xlx2730109-code/Microduck/01_mechanical/roller_skates_kissqy_20261107/README.md

# 01_mechanical/roller_skates_kissqy_20261107
目标：提供 kissqy 20261107 原版滑轮鞋文件与摆盘数量。

## 基准与结论

### A. 文件与数量

| 文件 | 数量 | 说明 |
|---|---:|---|
| 滑轮.stl | 4 | 作者要求 TPU |
| 滑轮支架左.stl | 1 | 硬质结构件；作者未指定统一材料 |
| 滑轮支架右.stl | 1 | 与左支架文件相同，左右各装一件 |
| 左脚.stl | 1 | 同版脚踝连接件，作为配套参考 |
| 右脚.stl | 1 | 同版脚踝连接件，作为配套参考 |
| source_layout.3mf | — | 原始整机摆盘，仅供核对，不整包上传打印 |
| manifest.json | — | 来源、数量依据及文件 SHA256 |

- **K1**：原始 3MF 含四个滑轮实例、两个支架实例。6个轮子包含备料，不能当成作者装机数量。
- **K2**：五个 STL 均可读取、网格封闭。文件直接复制，未改模型、单位及尺寸，复制前后哈希一致。
- **K3**：现有机械行者／fanhao v2.2 脚部与此支架的实际兼容尚未验证。左右脚作为同版连接件附带，不能据此断言现有脚必须更换。
- **K4**：作者要求滑轮使用 TPU。硬质件使用 ABS 属于我们的材料建议，不是作者要求。
- **K5**：来源：https://github.com/kissqy/Microduck-kissqy/tree/main/hardware/3d-print-frankenduck 。以下载的 20261107 原包为准，网页 FILES/SHA256SUMS 部分仍记录旧包。
- **K6**：用户已确认多打备料；本机拟下单数量、截图实际材料与成交状态统一在 [BOM 补打计划](../../00_notes/01_BOM表.md#2026-11-10-补打与备料计划) 维护。上表为原版装机数量，不是本机备料总数；尚未确认打印付款或收货。

## 已完成

- [x] 2026-11-10 下载原包、读取摆盘、提取文件并检查 ZIP，见 K1、K2。
- [x] 2026-11-10 同步用户备料决定和 BOM 入口，见 K6；更新 ZIP 内同名说明，STL 保持不变。

## 待完成

- [ ] **T1** 核对现有脚部与滑轮支架的连接孔位；决定是否需要同版左右脚，见 K3。
- [ ] **T2** 按同版装配核对 623ZZ 轴承、轮轴和紧固件；实物装配与运转未验证。
