xlx2730109-code/Microduck/08_local_web/studio/README.md

# Microduck Studio

装在鸭子上的网页中控。电脑或手机浏览器打开 `http://<鸭子 IP>:8000/` 就能看鸭子现在的状态、一键卸力，也能站立/走路、配对蓝牙手柄（走官方 `robotctl pad pair`）、标定舵机、校准 IMU 方向、把这两样和方向一次写进主程序，按「上手清单」做装机检查。鸭子开热点等配网时，还能用手机选家里的 WiFi、填密码。

## 它做什么、不做什么

- 平时跟鸭子主程序 robotd 说话（`/run/robotd.sock`，接口 v40）；舵机页要直接调舵机，先让 robotd 交出总线，用完再交还。
- 页面上的一切状态都来自 robotd 的回读：比如「已卸力 ✓」要等 busStatus 里扭矩确认关了才显示，不是「按过了」就算。
- 停掉 Studio 不影响鸭子；停掉 robotd **不会**让舵机卸力（舵机保持最后的指令），页面会提示。
- **Studio 退出不卸力**：舵机页的总线会话开着时 Studio 退出（重启、升级），只关串口，保持着的舵机照样保持。
  开总线时在 state 目录写 `servo-session.json`（串口、开始时间、谁开的），点「交还主程序」成功才删；Studio 起来时见到它、
  robotd 又不在，就自动重新接管总线（只读打开，不改扭矩），每一页顶上的提示条照旧；接管不上，提示条写
  「上次退出时可能还有舵机保持着，去舵机页接管后才能卸力」，顶上的卸力按钮带你去舵机页。robotd 在：它起来时已经全部松开，删掉标记。
- 舵机会话期间每 5 秒看一眼 robotd 的 socket：被手动起来了（它会把舵机全部松开、跟 Studio 抢串口）就记错误、Studio 关总线（不写舵机），
  提示条变红。要回主程序，点「交还主程序」，别手动 `systemctl start robotd`。

## 目录

```
run.py              启动入口（python3 -I run.py …）：把 deps/ 放进搜索路径再进 studio
run_tests.py        跑全部测试
studio/
  log.py            日志：分类、分级、毫秒时间、去重、脱敏、按天滚动；命令记「发出 → 回执 · 耗时」
  auth.py           管理员密码（scrypt）、登录会话、失败退避、Host/Origin 校验
  rpc.py            robotd/configd 的 JSON-RPC 连接（一条连接一次一个请求）
  robotd.py         连接：轮询 / 实时状态流 / 命令 / configd 各一条常驻；卸力每次新开一条（robotd 重启后不会撞上死连接）
  estop.py          卸力状态机：ready → pending → confirmed / unavailable；只认「卸力回执之后才发出的」回读
  state.py          把原始数据汇总成推给页面的状态（姿势、电量、舵机、IMU、手柄、待办、配网）
  models.py         模型库、默认恢复、实际切换回读、手柄改键
  model_package.py  模型部署包解析与 robotd 无硬件预检
  sensors.py        摄像头来源配置与 ToF 按需快照（独立于运动控制）
  net.py            配网：读 netcheck 的 net.json、configd 的 net.status / scan / connect / forget、开关热点
  app.py            网页服务：静态文件、登录、日志、诊断包、WebSocket
web/                页面（Preact + htm，three.js 画 3D 鸭子；全部本地文件，不走 CDN；wifi.js 是连 WiFi 卡片和设置；
                    probe.svg 是连 WiFi 以后找鸭子新地址用的小图）
deps/               钉死版本的 Python 依赖（starlette、uvicorn 等，见 deps/VERSIONS.txt）
dev/
  record_robotd.py  在鸭子上只读录一份 robotd 的真实回包（给假 robotd 和测试用）
  fake_robotd.py    假 robotd + 假 configd：回放录的数据，电脑上不接鸭子也能跑
tests/              单元测试 + 真机录的数据 fixtures/now-20261018.jsonl
```

## 在电脑上跑（不接鸭子）

需要 Python 3.13（跟板子一样；Windows 上是 `py -3.13`）。

```bash
py -3.13 -I dev/fake_robotd.py --fixture tests/fixtures/now-20261018.jsonl \
    --net-mode hotspot --net-state-file ./state-dev/net.json   # 假 robotd + 假热点配网，听 17001/17002
py -3.13 -I run.py --listen 127.0.0.1:18080 --robotd tcp:127.0.0.1:17001 --configd tcp:127.0.0.1:17002 \
    --net-state ./state-dev/net.json --dev-autologin --state-dir ./state-dev --log-dir ./logs-dev
```

浏览器开 `http://127.0.0.1:18080/`。`--dev-autologin` 只认本机请求、只能配 `127.0.0.1`，方便截图测试；鸭子上不要用。
假 robotd 可以用 `--mode commissioning|motion` 选主程序模式（出厂场景是 `--mode commissioning --calib factory`），用 `--posture limp|policy|commissioning|starting` 换姿势；`--net-mode hotspot|wifi|none` 写一份假 net.json。
标定模式照 fork 的真实行为：起来后先回启动报告（`phase=configuring_bus`），第一次读成功才回实时快照；`--commissioning-stuck-status` 模拟旧 fork（启动报告永远不清，Studio 一直看到「启动中」）。
不给 `--net-state` 时读 `/run/microduck/net.json`；文件不在（电脑上、老镜像）就不显示 WiFi。不给 `--duck-label` 时，界面用主机名（鸭子上是 `duck-xxxx`）。

Windows 的 Python 没有 Unix socket，所以地址写成 `tcp:主机:端口`；鸭子上是 `unix:/run/robotd.sock`（默认）。

## 摄像头和 ToF

左侧「手柄」之后是「摄像头」「ToF」两个独立页面，手机底栏也有入口。

总览／手柄页的状态栏依次显示电池、舵机、IMU、摄像头、ToF、手柄、主板。摄像头仅通过本机 mediad socket 的只读 `hello` 判断“服务在线”，不把配置文件或测试画面当作真实摄像头已连接；点开页面才能查看实际视频。ToF 根据新帧显示在线，fake/sim 明确标为模拟数据。状态栏每10秒检查一次，切页或后台取消，过期状态清空；检查不会请求视频帧、建立 WebRTC 或启动系统服务。

当前镜像尚无“开机自动识别摄像头／ToF 硬件，再按检测结果启停服务”的统一策略。firstboot 的自动识别针对 IMU；镜像默认 `media.source="test"` 避免缺摄像头反复崩溃，但媒体服务仍可能运行。网页未连接可能是网络或服务问题，不能直接据此认定没装硬件并关闭服务。

- **摄像头**：接现有 mediad 的局域网 WebRTC 视频（默认信令端口 8443），可以开始、停止和重新连接。页面等实际画面开始更新才显示播放；切走或进入后台会释放连接。只读取视频及画面元数据，不打开电脑/手机摄像头，不发送运动指令。画面按运行端报告的安装角度显示。
- **来源标记**：镜像的 `[media] source="test"` 表示测试图案，能播放也不能代表真实摄像头接好了。配置为 camera 时也只显示「配置：摄像头」，配置文件不能证明当前运行状态；视频服务标为模拟设备时另行注明。当前版本会忽略旧的 `media.camera` 开关，Studio 不据此猜测真实来源。
- **ToF**：通过 `/run/tofd/tof.sock` 的 `tof.stream` 获取 8×8 距离分区，显示有效格数、最近/最远有效毫米值及逐格原始状态。5/9 且距离为正才计入统计；无目标（255）和测量失败分别显示。服务未连接、未接传感器、等待首帧、格式错误和过期数据均有独立说明。fake/sim 数据会标注「模拟数据」。
- 传感器读取独立于 robotd 的运动连接，只在相关页面可见时进行；没有自动避障、导航或后台录像功能，不更改系统服务和配置。

高级安装可通过 `--tof unix:/run/tofd/tof.sock`、`--camera-socket unix:/run/mediad/media.sock` 和 `--camera-signaling-port 8443` 指定本机服务；`--tof none` 或 `--camera-socket none` 明确关闭对应的只读探测。开发测试可将 socket 指向受控的 `tcp:127.0.0.1:端口`。网页不接受任意 socket 或视频服务器地址。摄像头信令使用打开 Studio 的主机名，远程仅转发 8000 端口的 SSH 隧道不会自动转发视频链路。

本地 `tests/test_sensors_e2e.py` 使用明确标记的假 ToF 和浏览器 RTC 测试实现，验证真实网页播放、导航、错误及资源释放；这些软件测试不代替摄像头、编码器和 ToF 硬件验收。

## 台架模式：主控没烧，用飞特调试板在电脑上调舵机

把飞特调试板（或 USB 转 TTL）插到电脑上，接好舵机和电源，然后：

```bash
py -3.13 -I run.py --bench
```

它不连主程序，自动打开浏览器进「舵机」页；在页头的「串口」下拉里选 COM 口，点「连接」就能调（跟 servo-web 一样）。
没接硬件想先看看：串口选「演示（没接舵机）」，Studio 在软件里假装有 15 颗舵机。

## 装到鸭子上

1. 拷贝：把 `software/studio` 整个目录拷到鸭子的 `/home/radxa/studio-dev`（`scp -r`、U 盘解压包都行）。
2. 自检：在鸭子上运行 `python3 -I run.py --selfcheck`（只读：打印版本，对 robotd / configd / padd 各问一次）。
3. 装 root 小助手：`cd deploy && sudo sh install.sh radxa`。0.7.1 的小助手负责舵机总线交接、手柄配对、热点开关、`calib-read` / `calib-commit`（把标定写进主程序、切运动模式）、`ssh-status` / `ssh-password`（「更多」页的 SSH 开关），以及 `imu-recalibrate`（重新校验已保存的 IMU 安装方向）；关热点前会写 `/run/microduck/studio-connecting.json`，让 netcheck 在连接期间别插手。从舵机页交还时，标定模式的实时快照也算主程序起来了（0.5.1 只认运动模式的 `control`，标定模式下每次都等满 30 秒判「起不来」）。步骤、卸载和上机核对见 `deploy/INSTALL.md`。
4. 开机服务：照 `deploy/microduck-studio.service` 文件头的命令装：

   ```bash
   sudo install -m 644 microduck-studio.service /etc/systemd/system/ && sudo systemctl daemon-reload && sudo systemctl enable --now microduck-studio
   ```

   撤：

   ```bash
   sudo systemctl disable --now microduck-studio && sudo rm /etc/systemd/system/microduck-studio.service && sudo systemctl daemon-reload
   ```

5. 打开 `http://<鸭子 IP>:8000/`，按页面上的「上手清单」走。

手柄配对的主路是 root 小助手调官方 `/usr/local/bin/robotctl pad pair --json`：`/var/lib/robot/weird-ble` 板上它会先停 `btd`、给蓝牙适配器断电再开，配完把 `btd` 起回来。没装或旧版小助手时退回 configd → bluetoothctl；这块板这样可能配不上，向导会提示重装小助手，或者在鸭子上运行 `sudo robotctl pad pair`。

出厂镜像让 robotd 跑标定模式：`/etc/systemd/system/robotd.service.d/zzzz-zz-microduck-commissioning.conf` 里 `ExecStart` 带 `--commissioning`。这样 `calibration-status` 和 `busStatus.last_sample` 马上能读，IMU 页粗校、舵机页中位都能做。上手清单第 3 步写成功后，小助手删掉这个文件、`daemon-reload`、重启 robotd，主程序回到运动模式。`systemctl show robotd -p ExecStart` 里有 `--commissioning`、但那个文件不在时，小助手拒绝自动切（`foreign_commissioning`），去日志页导出诊断包。

IMU 页的「IMU 安装方向」始终保留入口：已经保存并验证过的安装四元数，也能点「重新标定方向」。先扶住鸭子并卸力，二次确认后，运动模式通过新版 root 小助手暂时回到标定模式；已经在标定模式的直接重新采集。沿用原来的静止 3 秒、整个躯干前倾 15–30° 采 3 秒、计算方向和主程序验证。**点击「交给主程序验证」前，先把实物回正并停住**，再按提示前倾。小助手的重标定恢复会话保持卸力；出厂标定模式也支持下述站姿采数，站着精校流程不变。

总线 ID 200 的 IMU 由主程序启动时自动识别，支持 FT6、IMU-to-DXL（Feetech）；SFLP 124/12（Dynamixel 2.0）。标定、运动模式的 IMU 页都显示实际协议和板卡。板卡名称表示识别到的寄存器布局，不证明厂商。需要手动指定时改主程序配置 `bus.imu_protocol = "auto" / "feetech" / "dxl2"`，网页没有运行中切换协议的按钮。I²C 的 BNO085、LSM6DSV16X 流程不变。

总线安装方向的 `imu_bus_protocol` 由主程序验证成功后写入；旧标定没有这个字段时只兼容 Feetech。检测到的协议不匹配时，页面提示重新标定，跳过第 2 步也不能把旧方向当成已验证。主程序通过运动模式的失能状态保留重做入口。第 3 步与小助手 0.7.1 保留并读回该字段；重做完成可采用新绑定，取消恢复原文件。协议、板卡布局或原始身份字节改变，会作废当前采集、在途计算和旧的站姿校准结果。DXL2 板卡不提供采样序号、状态位、传感器读数年龄；主程序使用主机接收新鲜度和原始字节冻结检查，页面不填造这些诊断值。

出厂标定模式做第一次安装方向标定，也可以先手动点「站姿使能」：等 HOME 保持站稳（误差 ≤5°），双手扶住整个躯干采静止和前倾，再回正交给主程序验证。允许已卸力或明确站稳两种状态；起身中、扭矩未知、运动中及卸力待确认仍拒绝。通过小助手从运动模式进入的重标定恢复会话仍要求全程卸力，避免恢复模式时重启主程序影响站姿。采数不会自动上力或发起运动。

重标定会话保留原始标定和启动配置，刷新网页或重启 Studio 后可继续，也可「取消并恢复原参数」。验证通过后逐项读回当前芯片和新方向，只恢复原来的运动许可及运行模式，舵机零位（包括非 2048 的零位）、方向、限位、其他 IMU 和未知配置均保留；恢复成功仍保持卸力。失败会保留恢复入口，不会把未读回的方向报成完成。此流程需要同时更新 Studio、root 小助手和 sudoers；不会调用上手清单第 3 步来重写舵机标定。

**标定模式的状态要新版 fork**：fork robotd 一起来先写一份启动报告（`{"mode":"commissioning","phase":"configuring_bus",...}`），`robot.busStatus` 只要它的 phase 还是启动阶段就一直回它；第一次读成功以后才回标定模式的实时快照（phase 是 `ready` / `moving` / `read_error` / `stop_unconfirmed` / `power_pending`，带 `last_sample`）。旧版 fork 的标定模式从来不清启动报告，Studio 会永远看到「启动中」、拿不到 `last_sample`（10-20 真机验收就是这样）；fork 已经改成第一次读成功以后清掉，用 20261020 之后的镜像（或重装那份 robotd）。Studio 这边：实时快照的这几个 phase 都算「主程序起来了」（`read_error` 是起来了、只是读舵机出错，照原样写主程序的原话）；连续报启动阶段超过 30 秒（从这次连上算），总览头图改成「主程序一直报『启动中』」、给「去日志页」，顶栏、待办、上手清单头上也不再说「通常 10 秒」。

电池用台架电源供电时，在「设置 → 电池」里把型号选成「台架电源」：只显示电压，不算电量、也不报电量。
Studio 默认没有密码，同一网络里谁都能打开。在「更多 → 登录密码」里可以直接设置；设过以后要先登录才能改，也可以清掉。命令行 `python3 -I run.py set-password` 仍然可用，但要用 radxa 用户运行，别加 `sudo`（root 写的密码文件 Studio 读不了）。

## 上手清单：去做、已完成、跳过

每一行任何时候都有三个按钮（用户 10-20：「可能有人之前做过重新走一遍」「允许人家直接跳过」）：

- **去做**：去那一步的页面；测出了问题的行写「重新做」。
- **已完成**：我以前做过（比如二号鸭零位早用 Studio 的舵机页校过），这一行 ✓、写「你标了已完成（时间）」。以前的「已经校过，核对一下」就是它。
- **跳过**：先不做，这一行 ↷。

标过的行给「重新做」和「取消」（跳过的是「取消跳过」）。标记绑这一步的指纹（舵机零位、IMU 方向、标定、手柄……），指纹变了就不算、回到「该做」；标的时候读不到指纹，等读到了再绑上。
以前锁着的情况——主程序说没做完、读不到（?）、测出了问题、测急停、调舵机时——现在都能点，但「已完成」「跳过」要点两次，第二下按钮上写后果（「确定跳过？主程序说标定没做完：跳过了鸭子也站不起来」这种），后端没收到确认也拒。
第 1 步标了已完成或跳过，第 3 步「写进主程序」的准备情况里「舵机零位」算满足（15 颗按 2048 写零位，零位要是用 Studio 的舵机页校过的才对）。
第 2 步标了已完成或跳过、主程序里正在用的那颗 IMU 方向没确认、IMU 页也没站着校过（没有 `imu-pending.json`）时，第 3 步**按默认装法写这颗 IMU 并标成已确认**（10-21 真机验收：全点跳过以后 fork 要 IMU 方向已确认才肯进运动模式，鸭子一直停在标定模式）：

- 总线小板（`bus`）：文件里现有的 `imu_mount_quat`（出厂就是官方装法 `[0.7071067811865476, 0, 0.7071067811865476, 0]`）；
- BNO085（`bno08x`）：`[0.5, 0.5, 0.5, 0.5]`，fork `duck-control/src/trunk_imu.rs` 的 `BNO08X_DEFAULT_MOUNT`；
- LSM6DSV16X（`lsm6dsv16x`）：`[0.7071067811865476, 0, 0.7071067811865476, 0]`，复刻推荐装法（模块 x 朝下、z 朝前，二号鸭 10-17 实测）。fork 自己给的默认是单位四元数（「小板没有公认的朝上方向」），不用它。

准备情况里写「你标了第 2 步已完成：IMU 按默认装法写（芯片：哪种装法）。装得不一样的，站起来会往一边倒——写完以后在 IMU 页站着校一次，再写一次主程序」；点「写进主程序」的第二下写「确定？IMU 按默认装法写」。IMU 页站着校过（有 `imu-pending.json`）就照旧用它，主程序里方向已确认就照旧用主程序的；IMU 页记下的是另一颗芯片的、或者主程序还没报用的是哪颗，不猜，照旧挡住。小助手 `calib-commit` 照旧只收 `imu: {source, quat}`。这样**跳过第 1、2 步 → 第 3 步写进主程序 → 运动模式**一路能通。

## 打开 Studio 的地址怎么选

开着 Clash 系统代理的 Windows 电脑打不开 `duck-xxxx.local`（走了代理，502）；不带点的 `duck-xxxx` 能开（Windows 用 LLMNR 问到鸭子，代理按 `<local>` 绕过）。所以页面上按设备写：

- Windows 电脑：`http://duck-xxxx:8000/`（开着代理也能打开）；
- 苹果手机、Mac：`http://duck-xxxx.local:8000/`；
- 安卓手机，或者都打不开：去路由器的设备列表找 `duck-xxxx`，用它的 IP；
- 电脑开着 Clash 的 TUN 模式还打不开：在 Clash 里把局域网（192.168.0.0/16）设成直连。

「更多」页有一块「这只鸭子的地址」，列出现在能用的 IP（configd `net.status` 的 `ip4`，热点模式是 10.42.0.1）、`duck-xxxx`、`duck-xxxx.local`，每个能复制；总览顶栏鼠标停在鸭子名字上也看得到 IP。连 WiFi 的列表里滤掉了鸭子自己的热点（按 net.json 的 `hotspot_ssid`；没有就滤「`Microduck-` 开头、已保存」的）。

**连 WiFi 以后自动跳到鸭子的新地址**（10-21 用户：「连 WiFi 弄了三下」）：点了连接，页面记下要找的 `http://duck-xxxx:8000/` 和 `http://duck-xxxx.local:8000/`（主机名来自 net.json，端口跟 `--listen` 一致）。
页面跟鸭子的连接断了（WebSocket 断了，或者 5 秒没收到消息）以后，卡片换成「鸭子正在连『家里 WiFi』……请把这台设备连回『家里 WiFi』（电脑插着网线的不用管），找到鸭子会自动打开」，列出这两个地址（能点）和「找不到时：去路由器设备列表找 duck-xxxx 的 IP」。
每 2 秒用 `new Image()` 加载 `<地址>probe.svg?t=<时间>`（`web/probe.svg`，跟别的静态文件一样不用登录、不缓存；跨域加载图片不要 CORS），哪个先加载成功就跳过去；一次探测最多等 6 秒，没回话之前不重复探同一个地址。
最多找 3 分钟，找不到就换回原来那段按设备打开的说明。页面重新连上原来的地址（热点回来了，说明没连上）时停止探测，照旧显示失败原因。

## 镜像里 vs 手动装

「连 WiFi」卡片依赖复刻镜像里的几样东西，不是 Studio 自己带的：

- netcheck 写的配网状态 `/run/microduck/net.json`；
- NetworkManager 里的 `Microduck-Hotspot` 热点配置；
- configd 以 `--allow-user btd,radxa` 运行，Studio 才有权限调 `net.scan` / `net.connect` / `net.forget`；
- mDNS 配置，手机才能用 `duck-xxxx.local` 找到鸭子。

按 `deploy/INSTALL.md` 手动装 Studio 和 root 小助手、但没有复刻镜像 overlay 的鸭子，没有这几样，页面就不显示「连 WiFi」卡片；总览、手柄、舵机、IMU、日志这些照常使用。

## 页面和 Studio 之间的约定（WebSocket `/ws`）

握手时检查 Host 和 Origin，不对就拒绝握手（浏览器只看到 1006，日志里写原因）；没登录的先接受再用 4401 关掉，页面看到 4401 就跳登录页。

| 方向 | 消息 | 说明 |
|---|---|---|
| Studio → 页面 | `{"t":"hello","version","duck"}` | 连上先发一次 |
| | `{"t":"state", …}` | 页面可见时 10 Hz；字段见 `studio/state.py` 的 `summarize` |
| | `{"t":"hb"}` | 页面在后台时 1 Hz（这时不订阅 robotd 的实时状态，省 CPU） |
| | `{"t":"log","entry":{…}}` | 新日志 |
| | `{"t":"result","id","ok","reason","data"}` | 命令回执；扫 WiFi 的网络列表等数据放在 `data` |
| | `{"t":"pad", …}` | 手柄快照：手柄那一块在屏幕上时 10 Hz，不在 1 Hz（总览的手柄格要用）；长列表没变时带 `lists_same`、不带列表 |
| 页面 → Studio | `{"t":"hb","seq","visible","route","pad_visible"}` | 每秒一次；进出手柄区那一刻马上再发一次。`pad_visible` = 手柄那一块在屏幕上（#/pad 只是总览上的锚点） |
| | `{"t":"cmd","id","name","args"}` | relax、servo.*、imu.op、calib.op（`preview` / `commit`：上手清单第 3 步）、pad.op、onboard.op（上手清单的 `done` 已完成、`skip` 跳过、`undone` / `unskip` 取消，`{step, confirmed}`：要点两次的第二下才带 `confirmed: true`；老的 `confirm_servo` 还认）、net.op（`scan` / `connect` / `forget`） |

舵机会话在 `state` 里的几个字段（每一页顶上的提示条用）：`servo_session`（开着才有：`holding` 几颗保持着、`unknown` 几颗读不到扭矩、
`restored` 是不是 Studio 重启后接着管的）、`servo_handback_s`（交还以后、主程序连上以前一直有）、`servo_orphan`（上次退出时开着、这次没接管上）、
`servo_conflict_s`（会话期间 robotd 被手动起来了，10 分钟内）。`servo.close {if_idle:true}`（离开舵机页）只在 15 颗扭矩当场读到都是 0、
没有别的页面在舵机页、没在校准 / 运动时才交还；`servo.close {}`（点「交还主程序」）先等在路上的舵机操作做完再卸力交还。

`state.starting_s` / `state.starting_long`：主程序从这次连上起连续报启动阶段多少秒、超没超过 30 秒（总览头图、顶栏、待办改口「一直报启动中」用）。

`state.net` 是配网状态：`known=false` 表示没有 net.json（整块 WiFi 隐藏）；否则有 `mode`（wifi / hotspot / none）、当前 `ssid` / `signal` / `ip4`、`hostname`、
`url_local`（`duck-xxxx.local`，端口跟 `--listen` 一致）、`url_host`（不带点的 `duck-xxxx`）、`ip_now`（现在能用的 IP：热点模式是热点地址）、
`urls`（「这只鸭子的地址」那几行：`{kind: ip / host / local, url, note}`）、鸭子热点 `hotspot {ssid, ip, psk}`、上次结果 `last_try`、`busy`。`net.op scan` 滤掉鸭子自己的热点。`net.op connect` 先回「开始切换」（页面拿 `url_host` / `url_local` 当以后要找的地址），真正关热点、调 configd 在后台做；
结果写到 state 目录的 `net-last-try.json`（不含密码）。家里的 WiFi 密码只从页面传到 configd 一次，不进日志、state 或诊断包。

已保存的加密网络也要每次填密码：官方 configd 遇到加密网络、没给密码就回 `unsupported`。密码错了会先 `net.forget` 掉这次写坏的配置，再马上开回热点；
`timeout`、`other`、Studio 自己等 configd 超时，也会马上开回热点。Studio 等 60 秒没回话单独记「鸭子的配网程序 60 秒没回话」，不跟 configd 的 `timeout` 混在一起。
小助手关热点前写 `/run/microduck/studio-connecting.json`（90 秒内 netcheck 不插手），开热点成功后删掉。

页面判断「连不上」只看收到消息的间隔（1 秒变灰、3 秒报警），不看两边的钟（鸭子的钟可能是 1970 年）。

## 日志

`logs/studio-YYYY-MM-DD.log`，留 14 天、总共不超过 50 MB。一行一件事：

```
2026-10-18T00:41:56.194+09:00 [命令] → 卸力（电脑 127.0.0.1） · 步骤：robot.relax
2026-10-18T00:41:56.197+09:00 [命令] ← 卸力 成功 · 3 ms · 已发出，等回读确认 · 步骤：robot.relax · 原文：{"accepted": true}
```

出错时写明「卡在：哪一步 · 原文：… · 建议：… · 现场：{…}」。密码、令牌自动打码。同一句话 1 分钟内重复只记一次，并注明合并了几次。
页面「日志」页能看最近 500 条，也能导出诊断包（日志 + 当时的状态 + robotd 原始回包 + 版本 + robotd 的系统日志），发群里求助用。

日志里每条命令都记发出和回执、带耗时和现场，代码是我们自己写的。

## 测试

```bash
py -3.13 -I run_tests.py               # 电脑
python3 -I run_tests.py                # 鸭子
```

总线 IMU 集成的定向回归（含无头 Edge 页面；无 Edge / Node >=22 时浏览器项跳过）：

```bash
py -3.13 -I -c "import sys;sys.path[:0]=['deps','.','dev'];import unittest;unittest.main(module=None,argv=['x','tests.test_imu_backend','tests.test_commit','tests.test_helper_calib','tests.test_helper_imu_redo','tests.test_imu_bus_ui','tests.test_imu_wizard_e2e'])"
```

覆盖：
- 登录：会话、密码错 5 次退避、退出要 CSRF；Host 421、Origin 矩阵；没登录的 WebSocket 收到 4401；
- 日志：格式、脱敏、去重、按天清理（钟停在 1970 也能清）；
- JSON-RPC：半行、超长行、乱码和非对象 JSON、超时重连；
- 卸力：不被慢查询挡住、回读确认、hd1910 标志没清不算确认、标定模式、robotd 重启后第一次就成功、确认后别人再上力不会自动补发；
- 轮询：一项出错不挡别的项；只在有人看时订阅，没心跳当没人看；robotd 掉线又回来；
- 姿势判定（用真机录的数据）；通过 WebSocket 发卸力的完整来回；
- 手柄配对：小助手 `pad-pair` / `pad-forget` 的参数校验、robotctl 成功 / 失败 / 超时解析；向导的主路、旧小助手回退、bluetoothctl 代理注册失败重试、padd 30 秒等待。
- 配网：小助手热点动词、连接窗口文件；net.json 缺失 / 损坏 / 各模式；扫描缓存；连接顺序、失败原因（bad_key 先 forget 再开热点）、热点恢复、同时只连一个；密码不进日志 / state / last-try / 诊断包。
- 登录密码：网页首次设置、登录后才改、清掉；改密码保留当前浏览器会话；root 运行 `set-password` 被拒；热点模式且没密码时的卡片提示。
- 标定模式的状态：假 robotd 先回启动报告（四个键）、读成功后回 fork 字段的实时快照、`--commissioning-stuck-status` 永远回启动报告；实时快照算主程序起来了（总览、准备情况、小助手交还都是），旧 fork 一直 `configuring_bus` 时交还照旧判没起来、话照实说；连续 30 秒报启动阶段改口「一直报启动中」。
- 上手清单的三个按钮：每种原来锁着的情况都能「已完成」/「跳过」（两步确认、第二下的话对、后端没确认也拒）、「已完成」的记录和作废、指纹读不到先记再绑、第 1 步标了 → 第 3 步舵机零位满足、第 2 步标了但方向没确认 → 按默认装法写 IMU（总线小板 / BNO085 / LSM6DSV16X 各一条：准备情况满足、交给小助手的四元数对、读回过得了运动模式校验）、有 `imu-pending.json` 用它、主程序已确认用主程序的、芯片对不上照旧挡住。
- IMU 页的「站姿使能 / 失能」：标定模式下点了弹确认、发 `imu.op hold`，主程序收到的是 15 个方向 + 3000 ms 的 `hold-home`，站住以后写「标定模式（站着）」，失能走 `relax` 回软着；运动模式下发的命令跟遥控卡「站起来」、顶上「卸力」一模一样（浏览器端到端）。
- 地址：热点 / WiFi 模式的地址列表、扫描结果滤掉鸭子自己的热点、切换提示里三种地址。
- 连 WiFi 以后找鸭子：`probe.svg` 不用登录、两种主机名都给、不缓存；探测逻辑（Node 跑 `web/wifi.js` 的真代码，假时钟）每 2 秒探两个地址、先通的就跳、3 分钟放弃、热点回来就停、挂着不回的不重复探；浏览器端到端看断线后的卡片、热点回来停下、探到了跳过去。
- 写进主程序：小助手 `calib-read` 只读 / 不拿锁、`calib-commit` 先拿锁再查旗、标定模式删 drop-in 后切运动模式、`mode=motion` + `phase=control` + `calibration-status` 逐项读回一致才算成功、`waiting_for_bus` 的标定错误 / 总线错误分开报、读回不一致 / `.saved.toml` 写失败 / 重启失败都回滚（文件和模式分开报，回滚后起不来如实写）、策略在跑拒绝、`ExecStart` 里有 `--commissioning` 但 drop-in 不在拒绝、备份按序号留 10 组；Studio 两种模式的准备情况、`calib-read` 兜底、超时读 `last-result.json`、pending / centered 变化让第 3 步变「该做」、撤销中位校准删记录；两份组 TOML 代码输出一致。

## 现状（第一版）

能用的：
- **总览**：实时状态、3D 鸭子、电池、主板温度、一键卸力（空格也行）。
- **舵机页**：扫描、单颗或全部中位校准（直接写进舵机）、方向、姿势、P/D/限力。
- **IMU 页**：出厂标定模式下粗校（托起摆正 + 往前低头，交给主程序 `verify-imu` 自己验），能站以后站着精校。
  「站着校准」上面有「站姿使能」和「失能（卸力）」（走顶上「卸力」同一条路：`relax`），旁边一行写现在站着 / 软着 / 正在站起来。
  运动模式下「站姿使能」走遥控卡「站起来」同一条路（`pad.op stand`，后端按姿势再判一遍）；
  **标定模式下也能站**（10-21 用户：「咱标定也能站姿不就好了吗？非要切到运动模式」）：发 `imu.op hold` → fork 标定模式的 `hold-home`，
  15 颗从现在的位置一起 3 秒转到 HOME 锁住，IMU 照常读；方向跟第 3 步写进主程序的同一套，零位用主程序文件里的（出厂 2048）。
  标定模式下 Studio 每 0.1 秒读一次 `busStatus`，`last_sample.imu` 当实时读数：「现在」那块的倾角、站着校准都能用，方向没确认过也能站着校（算出整份新方向，第 3 步写进去）。
  站着的时候第 3 步挡住（「先点失能」），因为写进主程序要重启主程序，鸭子会直接塌。软着时开始站着校准，提示先点「站姿使能」。
- **SSH 远程登录**（「更多」页，10-21 用户：「出了问题他们 SSH 自己修，不用重新烧卡」）：镜像出厂只认钥匙、不带任何人的钥匙，也没有能远程登录的默认密码。用户先设网页登录密码（没设时后端拒绝：不然连上热点的人都能打开网页、顺手打开 SSH），再自己定一个 SSH 密码（8–64 位，不能是 microduck 这类大家都猜得到的），`POST /api/ssh {action: on}` → 小助手 `ssh-password`：`chpasswd` 从 stdin 设 radxa 的密码，写 `/etc/ssh/sshd_config.d/05-microduck-ssh-password.conf`（排在镜像的 `10-microduck.conf` 前面），`sshd -t`、`sshd -T` 读回密码登录真开了才 `reload`，哪一步不对就删掉文件退回去。关掉 = 删这个文件再 reload。**密码只走小助手的 stdin，不进命令行、日志、结果文件**（测试逐项核对）。卡片上给出 `ssh radxa@<现在这个地址>` 的登录命令。
  「办法二：登记钥匙」（`studio/sshkeys.py`）：Studio 本来就以 radxa 身份跑，`~/.ssh/authorized_keys` 是它自己的文件，不经过小助手。只收一整行公钥（ed25519 / rsa / ecdsa / sk-*），base64 里的类型要跟开头写的一致，前面不能带 `command=` 这类选项；贴私钥会被认出来拦下。同一把（按 SHA256 指纹，跟 `ssh-keygen -l` 一样）不重复写；删掉按指纹删。目录 700、文件 600，`~/.ssh` 或文件是软链接就拒绝。跟打开密码登录一样，要先设网页登录密码。
- **写进主程序**：上手清单第 3 步把舵机零位、方向、IMU 方向一次写进 robotd 的标定。出厂镜像是标定模式；写成功后小助手删掉 commissioning drop-in、重启主程序切运动模式。成功不只看重启：还要 `mode=motion`、`phase=control`，并且 `calibration-status` 读回逐项一致；不成就把文件和模式换回去。Studio 重启后会读 `last-result.json` 把上次结果放回第 3 步卡片。
- **手柄**：配对（走官方 `robotctl pad pair`）、网页手柄、测急停。
- **遥控**：站起来 / 开始走 / 坐下、技能、动作和组合动作。
- **调手感**：只看。**模型管理**：导入部署包、改名、选择模型、恢复内置、设置动作键和删除导入模型；具体格式见 [模型导入说明](MODEL_IMPORT.md)。
- **日志**：日志页和诊断包；手机底栏从「更多」也能进日志、导出诊断包。
- **连 WiFi**：鸭子开热点时用手机选家里的 WiFi、填密码；切过去以后页面自己找鸭子的新地址、找到就跳过去；设置里能看当前网络、换网、忘掉已保存的网络。
- **登录密码**：在「更多 → 登录密码」设置、修改或清掉；热点模式又没密码时，总览的连 WiFi 卡片会提示先设密码。

还不能的（下一版）：
- 在网页上**改**调手感参数（走路幅度、平滑、P/D/限力）。

## 参考

本项目基于官方开源的 Microduck，开发中参考了社区多个开源项目的思路；代码由我们自己编写，开发中使用了 AI 辅助编程。

## 许可

Apache-2.0（跟仓库一致）。`web/vendor/` 下的 Preact、htm、three.js 都是 MIT，许可证在 `web/vendor/licenses/`；3D 模型的来源见 `web/model/NOTICE.md`；`deps/` 下各包的许可证在各自的 dist-info 里。
