xlx2730109-code/Microduck/00_notes/00_复刻总路线.md

# 复刻总路线

目标：给第一次做的人看的全局地图，从零件到小鸭会走，再到自己训练、复现。每一步只写做什么、怎样算完成、去哪看，细节在对应文档里。

原则：**真机首走优先用现成资源。** 阶段一使用作者镜像、成品模型和网页工具；主控在途期间已并行开展仿真训练。训练进展不替代实物标定、系统辨识、迁移和首走验收。

## 现在在哪

| 项目 | 状态 |
|---|---|
| 资料 | 作者主仓、镜像、10 个成品模型、CAD、装配 PDF、官方源码都在本地，有版本锁和校验 |
| 硬件 | 机械主体已装起；ZERO 3W 1GB 已启动；用户已接回 fanhao HAT，针序和舵机供电待实测；IMU 待读回 |
| 软件 | 64GB 系统卡已写入 `20261027`；已通过 `xlx` 配网，Studio 跨网可达性有波动，见[实机联调](../README.md#2026-11-14-实机联调) |
| 电脑工具 | 微雪 Adapter A 台架曾读到 15/15；当前 Windows 未枚举 COM10。模拟演示与实机入口见根 README |
| 摄像头机械适配 | 灰色面板与黄色眼圈的 SW 已定位；眼圈分面已核实，用户自行修改，尚无改件或打印验收。统一见[根 README 当前工作](../README.md#摄像头面板与眼圈修改2026-11-10) |
| 仿真训练 | Jetson 正在训练 HD1910 平地行走，已产生中途检查点；原生 Windows 短测通过，命令、曲线和预览见 [08 指南](08_训练导出与迁移指南.md) |
| 标定工具 | Windows 舵机调试台用于微雪台架；ZERO Studio 用于装机后的总线、IMU 和标定验收 |
| 真机验收 | 15 个唯一 ID 和舵机保护已通过台架断电复核；已单测右踝。整机 HAT 识别、机械零位、IMU、架空和首走待验 |

## 阶段一：整机复刻（进行中，不需要训练）

拿到零件后的顺序是：**给舵机编号 → 装机械 → 装电控 → 写镜像 → 网页上标定 → 手柄让它走**。

| 步骤 | 做什么 | 怎样算完成 | 去哪看 |
|---|---|---|---|
| 0 备料 | 核对已到货的主控、HAT、IMU、HUB 和线束版本 | 实物、接口和固件有记录 | [BOM 表](01_BOM表.md) |
| 1 清点 | 到货逐件核对，拍照，记板号和线数量 | 缺件与错件有清单 | [02 指南 C3](02_分阶段复现指南.md) |
| 2 舵机编号 | 首次接成整机总线/上电前，逐颗用 Adapter A 读回并设成 D1 目标 ID；仅卖家预编程且读回全数正确时跳过改写 | 15 颗 ID 唯一、匹配目标表且读回有记录 | 02 指南 D |
| 3 机械装配 | 小腿、大腿与髋、躯干、颈、头分组装；装前先让舵机归中 | 关节无卡滞，线不拉紧 | 02 指南 E，[视频入口](../90_archive/notes/04_视频与外部入口.md) |
| 4 电控装机 | 按实物核对针序，装主控、HAT、IMU，万用表查电压 | 主控 5 V 正常，无异常发热 | 02 指南 F、F1 |
| 5 写镜像与联网 | 已写卡并配置 `xlx`；核对同网和跨网访问 | 电脑能稳定打开 `:8000` 并收到实时状态 | 02 指南 G、H |
| 6 标定 | 网页向导：舵机零位、IMU 方向、站姿 | 本机标定保存并重启后仍有效 | 02 指南 I，[验收模板](03_标定与验收记录模板.md) |
| 7 架空与手柄 | 托住机身测保持、卸力；配对手柄，测急停 | 卸力和停止行为有记录 | 02 指南 J |
| 8 首次行走 | 平地低速前后、转向、停止，一次只改一个条件 | 有成功与失败记录 | 02 指南 K |
| 9 摄像头 | 接真实摄像头，Studio 视频页出画面 | 真实画面，不是测试图 | 02 指南 L |
| 10 备份基线 | 整卡存档，保存标定与配置，必要时做恢复卡 | 能从备份恢复到走通的状态 | [08 指南 G](08_训练导出与迁移指南.md) |

阶段一到第 10 步结束，就是“复刻完成”。

## 阶段二：复现学习（走起来之后，选做，可按兴趣取舍）

| 环节 | 目的 | 现有资料 | 缺口 |
|---|---|---|---|
| 1 读懂现成系统 | 理解镜像里运行端、模型和部署合同如何配合 | [06 完整性](06_复现完整性与动作清单.md)，作者仓库 | 无 |
| 2 建模 SW → MJCF / URDF / USD | 对照自己熟悉的流程 | SW 装配体与 STEP 在 `01_mechanical/cad_v2.2`；训练主线用作者的 MJCF，不需要转换；第三方有 URDF 与 Isaac Lab 仓库可对照 | 没有 HD-1910 版的 USD，自己转需另立项 |
| 3 质量与惯量实测 | 让仿真模型贴近本机 | 电子秤已买；训练前数据清单有原版数值 | 装好后称重，模型要按实测改 |
| 4 系统辨识 | 得到本机舵机参数 | 现用陆吾公开的 1910 参数，飞特官方另有一份 | 本机台架数据、拟合和验证都没有 |
| 5 训练环境 | 原生 Windows RTX 5080 与 Jetson 独立适配环境已短测通过，无需为此安装 WSL2 | [08 指南](08_训练导出与迁移指南.md) | 严格冻结、长期目录和环境重建仍待完成 |
| 6 训练与评估 | Jetson 正在训练 HD1910 平地行走，保留日志和中途 PT | 08 指南的当前实测与常用命令 | 尚未完成收敛、步态、续训与迁移验收；本机检查点不等于作者原始权重 |
| 7 导出与部署合同 | 把训练结果变成机器人能导入的包 | 08 指南 D | 训练台导出的包缺部署合同文件，要补 |
| 8 sim2sim | 在另一个仿真里对照同一策略 | 作者有回放脚本 | 脚本里还有原版舵机路径，要改 |
| 9 sim2real | 导入、分级验收、与基线对比、可回退 | 08 指南 E | 依赖阶段一的基线 |
| 10 其他动作 | 倒地恢复、坐站、捡物 | 10 个成品模型在本地，行走权重已含倒地恢复 | 本机恢复范围需分别验收；重训这些动作需额外移植 |

## 扩展（不挡阶段一）

云端自然对话、ToF 测距、轮滑、翻滚与踢球。上游没有云端对话，列在这里单独做。

## 现在卡在哪

1. 先比较 `xlx` 同网与 Tailscale 的 Studio 首页及实时状态，定位超时。PCB/Wi-Fi 批次及扩容待记录，`20261023c` 保留为回退版本。
2. 台架已完成 15 颗舵机编号；转接 HAT 前核对三芯线针序与供电，使用 ZERO Studio 验收整机 15/15。逐关节核对方向、行程和走线后再校零。
3. 核对 IMU 板型并读回实时数据，再确认安装方向。HUB 和实际供电端子仍待记录。
4. 补打件含备料的数量、截图材料、文件和未成交状态统一见 BOM；滑轮鞋不阻断普通脚底首走。
5. 摄像头镜头无法穿过现有眼圈孔，待用户按实测尺寸修改后检查并少量打印验配；照片不能作为扩孔尺寸依据。

更详细的评估、缺件核对与差异分析见 [15 方案评估与核对记录](../90_archive/notes/15_方案评估与核对记录.md)。
