xlx2730109-code/Microduck/00_notes/03_标定与验收记录模板.md

# 标定与验收记录模板

目标：保留本机配置、原始寄存器、关节映射和验收结果，避免后续依靠聊天记忆恢复。

2026-11-13 已完成电脑台架的 15 颗 ID 和保护断电复核。实物关节映射、方向、机械零位及整机运动仍待验收，空白不代表 0。

| 台架项目 | 实测结果 |
|---|---|
| 调试入口 | Windows 本地舵机调试台 `http://127.0.0.1:8080/`，Adapter A V3.1，COM10，1 Mbps |
| 断电重上电后 ID | 10–14、20–24、30–34 全部应答，逐颗读取的 ID 与寻址一致 |
| 断电重上电后 EEPROM | 15 颗的寄存器 19 均为 13，启用过热、过流、过压保护。寄存器 40 均为 0，55 均为 1 |
| 单颗运动 | 14 号单颗低速试动回读 190 → 209 → 191，随后扭矩回读为 0 |
| 下一步 | 在承托、关扭矩状态下手摆逐关节，核对 ID、方向和线束余量，随后按实物基准校零 |

## 本机版本

| 项目 | 实际值 | 证据/备份位置 |
|---|---|---|
| 舵机完整型号与固件 | 已购 HD-1910-C001；逐颗固件未读回 | BOM 第1项 |
| 机械版本/打印来源 | 机械行者／fanhao 飞特 v2.2；主体已装起，新增补打件尚未确认交付 | [装配照片](evidence/20261110/assembly_progress.jpg)、BOM 补打计划 |
| 主控及 PCB 修订/RAM/eMMC | 订单为 ZERO 3W，1GB RAM、无 eMMC、带排针；已发货；PCB 修订未知 | [主控订单](evidence/20261110/zero3w_shipped.png) |
| 调试板与接口版本 | 微雪 Bus Servo Adapter (A) V3.1，COM10 | 2026-11-13 台架实测 |
| HAT 版本 | 待填 | |
| IMU 芯片/MCU/PCB/协议 | 实物照片为方形四安装孔、丝印 V1.0A；芯片/MCU/协议/固件待核 | 本会话 IMU 到手照片；不继承其他板型标定 |
| 系统镜像与 SHA256 | 待填 | |
| 板端服务仓库/分支/提交/版本 | 待填 | |
| 中控版本 | 待填 | |
| 模型与合同/归一化/频率 | 待填 | |
| 电池/电池座/降压 | 待填 | |
| 脚垫材料与厚度 | 待填 | |
| 整机含电池质量 | 待填 | |

## 逐关节标定

关节按策略的常见命名列出；**本机实测ID未预填**，计划映射已按当前镜像列于 [执行指南D1](02_分阶段复现指南.md#d1-本镜像的关节与-id)。逐颗读回后再填本表，不把计划当作实测。零位、方向和偏移公式以同版运行时为准。

| 关节 | 本机 ID | 固件 | 原始零位/相位备份 | 几何零位 ticks | 方向 | 机械限位 | 小角度验收 |
|---|---|---|---|---|---|---|---|
| left_hip_yaw | 待填 | | | | | | 未测 |
| left_hip_roll | 待填 | | | | | | 未测 |
| left_hip_pitch | 待填 | | | | | | 未测 |
| left_knee | 待填 | | | | | | 未测 |
| left_ankle | 待填 | | | | | | 未测 |
| neck_pitch | 待填 | | | | | | 未测 |
| head_pitch | 待填 | | | | | | 未测 |
| head_yaw | 待填 | | | | | | 未测 |
| head_roll | 待填 | | | | | | 未测 |
| right_hip_yaw | 待填 | | | | | | 未测 |
| right_hip_roll | 待填 | | | | | | 未测 |
| right_hip_pitch | 待填 | | | | | | 未测 |
| right_knee | 待填 | | | | | | 未测 |
| right_ankle | 待填 | | | | | | 未测 |
| mouth | 待填 | | | | | | 未测 |

## 验收记录

| 日期 | 阶段/测试 | 固定条件与改动 | 输出/现象 | 判定与风险 | 日志/视频/标定备份 |
|---|---|---|---|---|---|
| 2026-11-10 | 机械进度记录 | 用户提供实物照片，无通电测试 | 主体已装起，部分线束外露 | 仅记录外观进度；行程、紧固、接线及标定未验收 | [原图](evidence/20261110/assembly_progress.jpg) |
| 待填 | 单颗通信 | | | 未测 | |
| 待填 | 总线与供电 | | | 未测 | |
| 待填 | IMU 四方向 | | | 未测 | |
| 待填 | 架空 HOME/卸力 | | | 未测 | |
| 待填 | 首次落地保持 | | | 未测 | |
| 待填 | 小幅前后/转向/停止 | | | 未测 | |

发生失败时记录“假设、改动、现象、回退版本”，不删去失败记录。临时诊断脚本与日志按全局规则先放 E 盘任务临时目录；经用户确认需要长期保留的结果再归入正式项目。
