xlx2730109-code/Microduck/00_notes/08_训练导出与迁移指南.md

# fanhao：训练、模型导出与环境迁移
目标：记录当前 HD1910 仿真训练、命令与可视化；真机首走仍用配套模型，训练候选经评估和合同核对后再迁移。

| 需求 | 采用入口 | 现在是否要做 |
|---|---|---|
| 尽快让小鸭走 | 镜像配套模型，见 [执行指南](02_分阶段复现指南.md) | 先做，不要求训练 |
| 当前训练、命令与可视化 | 本文 0 节 | Jetson 长训进行中，TensorBoard 与动作预览已启动 |
| 修改步态 | HD1910 平地任务，真实 GPU 训练 | 仿真参数与硬件合同核对后 |
| 将模型移上机 | 本文 D–E、机器人 Studio“模型管理” | 仿真评估通过后 |
| 换电脑/云服务器/卡 | 本文 F–G | 迁移前先备份 |

**截至2026-11-10，原生 Windows 与 Jetson 短测已通过，Jetson 长训正在运行，已有本机 PT 检查点。** 当前采用独立适配环境与命令行入口；后文 Training Studio、完整导出和迁移流程属于参考，未因训练启动而视为验收通过。

## 0. 当前实测与常用命令

### 0.1 当前训练什么、运行到哪里

| 项目 | 已核实状态 |
|---|---|
| 任务 | `Mjlab-Velocity-Flat-MicroDuck-HD1910`；HD1910 平地速度跟踪与平衡，使用 BAM M6 舵机模型；不训练摄像头、对话或轮滑 |
| 实际训练端 | Jetson AGX Orin 64GB，12核 ARM64，Ubuntu22.04；SSH别名 `jetson-usb`，USB地址 `192.168.55.1` |
| 参数 | 4096环境、目标1500轮、种子42、每环境每轮24步、每250轮保存；未为提速减少奖励、物理精度或PPO更新 |
| 工作目录 | `/home/jetson/microduck_training_test_20261110`；仍在临时实验目录，活跃训练结束及成果备份前不要清理或搬迁 |
| 当前运行 | `logs/rsl_rl/microduck_hd1910_velocity/2026-11-10_21-31-20_hd1910_m6_luwu/`，进程PID159599 |
| 2026-11-10约22:46读回 | 日志迭代索引416，最近10轮吞吐中位数8927.5 FPS；总奖励最新103.23，平均回合长度940.09步；NaN终止统计0 |
| 最新已保存模型 | 本次运行目录中的 `model_250.pt`，4843363字节；另有 `model_0.pt`。这是读取时的快照，不随本文自动更新 |
| 当前可视化 | TensorBoard和 `preview.py` 进程均在运行；曲线已有用户截图确认。动作预览进程存在，不等于步态已评估通过 |

日志迭代索引不是训练成功率；奖励和回合长度不能单独证明已学会稳定行走。本机尚无完整步态评估、PT/ONNX一致性、sim2sim或实机部署通过记录。未验证从中途检查点恢复全部训练状态，不假定重启能恢复到日志最新轮数。

### 0.2 统一训练命令

在Jetson进入目录：

```bash
cd /home/jetson/microduck_training_test_20261110
```

激活独立环境：

```bash
source venv/bin/activate
```

下次新训练使用统一入口，当前训练运行时不要再执行：

```bash
python train.py --task=Mjlab-Velocity-Flat-MicroDuck-HD1910 --headless --num-envs 4096 --max-iterations 1500
```

仅检查参数转发、不启动训练：

```bash
python train.py --task=Mjlab-Velocity-Flat-MicroDuck-HD1910 --headless --dry-run
```

`train.py`是新增包装入口，继续调用`benchmark.py --mode train`，默认启用已验证的`--det3-compat`；不表示迁入Bennett训练框架。任务名不是检查点或策略文件名。默认4096环境、1500轮，支持环境数与轮数的连字符/下划线别名。已验证帮助、参数转发与错误输入处理；尚未通过新包装入口另开完整训练，原长训仍由`benchmark.py`启动。

### 0.3 曲线与动作预览

另开Jetson终端启动TensorBoard；已有服务时直接打开网页，不重复启动：

```bash
/home/jetson/microduck_training_test_20261110/venv/bin/python -m tensorboard.main --logdir /home/jetson/microduck_training_test_20261110/logs/rsl_rl --host 0.0.0.0 --port 6006
```

| 浏览器位置 | 地址 |
|---|---|
| Jetson桌面，包括Moonlight中的浏览器 | http://127.0.0.1:6006 |
| Windows电脑 | http://192.168.55.1:6006 |

`0.0.0.0`用于服务监听，不作为浏览器访问地址。该服务首页及数据接口已返回HTTP200，用户已打开曲线页面。只勾选本次21:31:20运行；其余运行是短测试。关注`Train/mean_reward`、`Train/mean_episode_length`、`Episode_Termination`、`Perf/total_fps`。Curriculum横线不是训练停滞证据，右上角INACTIVE也不能单独判定训练停止；刷新后结合日志步数与进程检查。

另开终端启动1环境动作预览：

```bash
/home/jetson/microduck_training_test_20261110/venv/bin/python /home/jetson/microduck_training_test_20261110/preview.py
```

Jetson浏览器访问`http://127.0.0.1:8080`，Windows浏览器访问`http://192.168.55.1:8080`。不要与Windows本地模拟演示网页`127.0.0.1:8080`混淆。入口在启动时自动选择本次运行编号最大的已保存PT，并打印完整路径；已有预览不会因新增PT而自动保证切换。使用界面的检查点选择功能，或仅结束预览终端后重新执行；不要结束训练终端。

### 0.4 已验证的提速与软件候选

| 条件 | 吞吐中位数 | 统计边界 |
|---|---:|---|
| 原50W动态频率 | 7153 FPS | 同一长训阶段的10轮 |
| 50W锁频 | 7991 FPS | 同一长训阶段的10轮 |
| MAXN锁频、未开预览时的短时测量 | 11652.5 FPS | 同一长训阶段的10轮；相对原始约提高62.9% |
| 当前长训并行预览 | 见0.1状态快照 | 存在资源竞争，未做开/关预览的严格对照，不能将降速全归因于预览 |

当前CPU2201.6MHz、GPU1300.5MHz、8个TPC全开、EMC3199MHz。约22:47采样CPU60℃、GPU56℃，仍维持上述频率；不把短时读数称为全程温度峰值或长期稳定验收。MAXN功耗模式持久保留，锁频未配置开机自启；没有修改密码、SSH、网络或启动服务。

本机先恢复动态频率再切换MAXN，`nvpmodel`未请求重启，原训练保持运行；之前“一定需要重启”的判断过强。若以后切换请求重启，应先拒绝，确认检查点与恢复路径；不用`--force`。

原始频率备份：`/home/jetson/microduck_training_test_20261110/clocks-before-20261110-214439.conf`。恢复候选顺序为`sudo jetson_clocks --restore 备份路径`再`sudo nvpmodel -m 3`，完整恢复效果尚未实测，当前不执行。

软件分析使用py-spy25秒非阻塞采样，主要线索为舵机延迟缓存中的GPU布尔判断、直立奖励的身体姿态索引及指令重采样nonzero。延迟缓存候选通过360组组件一致性检查，姿态索引输出一致；均未接入原训练或共享mjlab。组件计时与长训共享GPU，不能换算成整轮收益；GPU时间线因CUPTI权限不足未取得。

### 0.5 资料、验证边界与后续

| 材料 | 位置 |
|---|---|
| Windows与Jetson实测、原始数据、软件候选、启动脚本副本 | `E:/HuanCun/AI_tmp/GPT/tmp_20261110_microduck_training/`，详细记录见该目录README |
| Jetson实际日志、PT、配置、MAXN操作证据、分析结果 | 0.1工作目录；`power-tuning-*.json`、`maxn-*.json`、`software-*.json/raw` |
| Windows独立虚拟环境 | 上述本机测试目录的`windows-venv`，继承原`D:/Conda/envs/env_isaaclab`；未改原Conda环境，未安装WSL2 |

待办：

- [ ] 训练结束后核对最终PT、日志和配置，备份到经用户确认的长期结果目录；当前不搬迁活跃目录。
- [ ] 分检查点评估站稳、前后、侧向、转向和停止，保留成功与失败视频；确认播放的实际检查点。
- [ ] 验证可续训状态与统一入口的完整运行，记录迭代计数语义和剩余轮数，不盲目重启。
- [ ] 软件候选先做隔离完整A/B，报告效果后经用户确认再接入机器人专属适配。
- [ ] 模型/动作合同、系统辨识、导出、sim2sim和实机分级验收依后文开展；当前训练不能抵消这些缺口。

## A. 三个软件对象分开理解

| 名称 | 在哪里运行 | 地址/作用 |
|---|---|---|
| 机器人 Studio | ZERO 主控，镜像自带 | `:8000`；标定、手柄、运行模型与诊断 |
| Training Studio | 独立训练执行端，本次未启用 | 默认 `127.0.0.1:8093`；调度训练、评估和导出 |
| mjlab 训练引擎 | 同一训练执行端 | 实际计算仿真与 PPO，保存 PT 检查点 |

Training Studio 的演示模式生成合成指标和示意回放，不产生可部署权重。界面显示百分比是迭代进度，不表示“已学会走路”。已有 ONNX 推理模型通常不能直接恢复优化器继续训练；续训需要适用的完整 PT 检查点。

源码固定于 [本地训练工程](../02_feetech/microduck-replica_20261024/software/training/README.md)和 [训练台](../02_feetech/microduck-replica_20261024/software/training-studio/README.md)。不用旧 V167 训练中控的菜单替代当前 Training Studio。

## B. 已实测的训练环境

用户不希望安装WSL2或切换Ubuntu。本次已在原生Windows RTX5080和Jetson上实际完成短训；当前长训采用Jetson。下表仅代表本机适配环境，不代表作者冻结依赖的原样复现。

| 平台 | 解释器与GPU软件 | 验证 |
|---|---|---|
| Windows RTX5080 16GB | Python3.11.14、PyTorch2.7.0+cu128、CUDA12.8 | 64/256环境各5轮PPO及检查点读取通过；4096环境未测 |
| Jetson AGX Orin 64GB | Python3.10.12、PyTorch2.11.0、CUDA12.6 | 同规模短测通过，长训见0节 |
| 两端仿真依赖 | mjlab1.3.0、MuJoCo3.10.0、MuJoCo-Warp3.8.1、Warp1.12.0 | Python/PyTorch/CUDA不同，非严格硬件单变量对照 |

训练源码提交`2852bccd625e0aef01b6a48a0ea8fd4c9d43670d`，BAM提交`62bd8ce12154340be97e06f7f41a0ca8f116d967`。通过PYTHONPATH加载独立源码副本和手动注册任务，未改固定归档源码。作者声明Python3.12及另一套锁定依赖，本机适配不宣称`uv sync --frozen`原样通过。

Jetson现有PyTorch/CUDA在随机化阶段缺少cuSOLVER符号`cusolverDnXsyevBatched_bufferSize`。测试入口对3×3行列式使用等价显式公式，已与CPU结果核对1000个矩阵；两端对照均启用，未取消质量/惯量随机化。原系统CUDA没有替换，Matplotlib冲突仅在独立venv修复。

同规模热身后小样本中位数：64环境Windows2.28秒/轮、Jetson6.02秒/轮；256环境Windows2.435秒/轮、Jetson6.13秒/轮。采用第1–4轮、排除第0轮和冷启动，Jetson为当时50W条件；不能套用到当前MAXN的4096环境，也不能据5轮判定收敛。

安装与重建参考：复制原始训练工程到独立可写目录后，先核对源码、BAM、解释器与锁文件；不要在归档源码内升级依赖。若另建作者原生Linux环境，使用该提交实际锁文件和作者README；不要把旧`915ed836`镜像资料提交直接当成本次训练提交。Training Studio尚未在本次适配环境验证，当前入口使用0节命令。

## C. Training Studio 参考流程（本次未启用）

在训练引擎目录转到相邻训练台。

```bash
cd ../training-studio
```

使用训练环境中的 Python 启动真实模式。

```bash
../training/.venv/bin/python run.py
```

在服务所在机器打开 `http://127.0.0.1:8093/`。远程服务器通过 SSH 转发到本机；下面用户名和主机是占位符。

```bash
ssh -N -L 8093:127.0.0.1:8093 USER@GPU_HOST
```

操作顺序：

1. 进入“计算环境”，确认 GPU、MuJoCo 图形后端、mjlab 1.3.0、CUDA 和 HD1910 注册检查通过。
2. 新建“HD1910 平地行走”，保留配置快照和种子，不选 XL330、轮滑或单脚平衡作为首个任务。
3. 按作者入口先做 **64 环境、5 轮**短试跑。它只检查加载、物理步进、保存与评估链路；执行预算先设短超时，超时记录现象后再决定是否延长。
4. 短测检查：数值有限，无 NaN/Inf；正确保存 PT；评估视频对应所选检查点；不是演示模式。
5. 报告短测配置、输出与问题，获用户确认后再正式训练；5 轮权重不用于真机行走。
6. 正式训练前核对质量/惯量、动作系数、默认姿态、执行器、随机化和命令范围，保持 HD1910 独立任务，不修改共享官方任务。
7. 正式训练放大环境数和轮数时以显存和实际迭代耗时为依据，不盲目照抄大卡参数。
8. 选检查点评估零命令、前后、转向、起停和失败场景；保留成功、失败及对照条件。
9. 比较同任务和同模式实验，确定候选后导出。

本版 Training Studio：关网页不停止任务，**关闭训练台服务会停止它拥有的子进程**。暂停仍占显存；不会停止云主机计费。长训练应使用经确认的终端会话/服务管理方案保持服务运行。

### C1. 不用界面时的命令行入口

先确保工作副本和短测输出位置已经核对，再在 `software/training/` 使用作者短测命令：

```bash
uv run --frozen train Mjlab-Velocity-Flat-MicroDuck-HD1910 --env.scene.num-envs 64 --agent.max-iterations 5 --agent.logger tensorboard
```

默认会在工作副本 `logs/rsl_rl/microduck_hd1910_velocity/` 生成文件；使用临时短测时，工作副本/输出应置于用户规定的临时任务目录，不能污染原始快照。

## D. 导出与仿真验证

### D1. 需要保留哪些成果

| 文件/记录 | 用途 |
|---|---|
| 完整 PT 检查点 | 评估、可能的续训；是否含优化器等状态须检查 |
| `policy.onnx` | ZERO 推理 |
| `manifest.json`、`deployment-contract.json` | 模型身份、关节、观测、动作与运行要求 |
| 其他导出配置/执行信息 | 同次导出若有 `deployment-execution.json`、`deployment-runtime.json`、`model-info.json` 等一并保留 |
| 源码提交、锁文件、参数和种子 | 重建训练与解释差异 |
| 评估视频和数值对照 | 证明候选通过了哪些检查，保留失败场景 |

在引擎目录先查实际导出参数：

```bash
uv run --frozen python scripts/export.py Mjlab-Velocity-Flat-MicroDuck-HD1910 --help
```

以下路径须替换为同一次实验真实检查点和新的候选文件；不覆盖已验收模型。

```bash
uv run --frozen python scripts/export.py Mjlab-Velocity-Flat-MicroDuck-HD1910 --checkpoint-file /absolute/path/model_XXXX.pt --onnx-file /absolute/path/candidate.onnx
```

导出脚本包含观测归一化；仍要核对具体包，不在运行端重复归一化。命令行导出单个 ONNX 不保证已产生机器人 Studio 所需的全部元数据；缺少合同不能随意补名、改后缀或塞入另一次实验的 JSON。

### D2. 导出后再验什么

1. 对相同观测比较 PT 与 ONNX 输出；记录容差和不能解释的差异。
2. 用匹配 HD1910 执行器的仿真检查静止、前后、转向与停止，不将保留 XL330 执行器路径的独立测试脚本直接当作 HD1910 通过证明。
3. 核对当前常用 61 维观测、14 维动作和 50Hz 的每一维语义；同维度不意味着同任务，单脚平衡的命令定义不同。
4. 对照实机的关节顺序、零位、方向、默认站姿、动作缩放、滤波、舵机增益及时间步。
5. 保存所有成果和 SHA256，候选未通过时保留失败记录，不替换旧基线。

## E. 导入小鸭并逐级验收

依据：[作者模型导入说明](../02_feetech/microduck-replica_20261024/software/studio/MODEL_IMPORT.md)。

1. 先备份旧配置、标定、模型和可启动系统卡，记下恢复方式。
2. 将同次导出的 `policy.onnx`、`manifest.json`、`deployment-contract.json` 及可用的其他运行元数据置于单一模型目录，打成 ZIP/tar.gz/tgz；不混多个模型或训练日志。
3. 部署包压缩上限 64MiB、展开上限 256MiB。进入机器人 Studio `:8000` 的“模型管理”导入。
4. 导入通过只表示安装成功；预检失败先读合同/运行端不兼容原因，不能强制复制覆盖系统模型。
5. 卸力后选择正确用途，点击“使用此模型”，等主程序确认实际路径。
6. 基础站姿、P 参数或关节顺序不同不能直接热切换，需要部署适配。
7. 重新完成架空、小幅保持、卸力、低速落地与停止验证，再做带摄像头/语音并发。
8. 异常先恢复旧模型及对应参数；只换回 ONNX 而不恢复参数可能仍然异常。

## F. 换电脑、换服务器、换主控

| 场景 | 要复制 | 在新环境做什么 |
|---|---|---|
| 换训练电脑 | 固定源码/锁文件、两个结果目录、完整 PT、配置及评估 | 重建 Python/CUDA 环境，短测后核对能否续训 |
| 本地转 GPU 服务器 | 同上，另记工作目录和路径关系 | 启动训练台并 SSH 转发，确认成果实际留在服务器 |
| 更换系统卡 | 已核验镜像、本机配置/标定、导入模型库和验收记录 | 备用卡启动，先看身份/数据，再标定检查和架空验证 |
| 更换 ZERO 主控 | 上述机器人备份及板卡/无线信息 | 先验镜像支持该批主控，再恢复本机资料 |
| 换另一只小鸭 | 可复用源码和候选模型 | 新机必须独立标定，不复制旧机零位当成新机实测 |

Training Studio 结果要同时保留 `training-studio/state/runs/` 和 `training/logs/rsl_rl/`；界面可能引用旧绝对路径，换位置后需明确恢复引用。本版没有“上传成果 ZIP 自动恢复训练”的入口。Windows 的 `.venv` 不复制到 Linux 直接用。

## G. 机器人备份和恢复卡

| 内容 | 本镜像的来源位置 | 处理 |
|---|---|---|
| 飞特配置和标定 | `/etc/robot/feetech-ft5/` | 完整备份并计算哈希；目录名沿用 ft5，不自行改名 |
| 媒体等总配置 | `/etc/robot/robotd.toml` | 保存相机等实际启用状态 |
| Studio 状态与导入模型 | 通常 `/var/lib/microduck-studio/` | 按实际 state 路径确认，保留导入身份与配置 |
| 默认 runtime 和模型 | `/opt/robot/feetech-ft5-r5/` | 发布版本和文件身份与系统卡一同记录 |
| 对话客户端 | 最终安装目录及设备配置 | 备份配置结构；凭据单独保管，不放公开资料包 |
| 系统卡 | 关机后整卡读出的镜像 | 使用明确支持读卡备份的工具；不要用 Flash 写入代替读出 |

制作恢复卡时先正常关机、断电取 A 卡，再通过已核对的工具读出完整卡镜像；使用 Etcher 将备份写入 B 卡。标称同为128GB的卡实际扇区数可能不同，目标小于源整卡镜像时不能强行写入，需调整镜像或使用更大实际容量卡。

恢复验收顺序：B卡启动 → 核对版本和实际本机标定 → 检查舵机/IMU → 卸力/保持 → 低速首走。只成功写卡、复制文件或显示页面不算恢复验证通过。

## H. 已知边界

- 训练工程沿用上游几何质量/惯量及公开 BAM M6 执行器参数，不是本机辨识结果。
- 作者 GPU 短试跑不等于长训练完成，也不等于该权重已在本机稳定行走。
- 内置运动模型、源码和网格的许可范围不同，按原文保留；本次定位个人复刻。
- 先形成普通脚底基线，再引入新动作或结构变化，避免同时修改机械、标定和模型而无法定位问题。
