xlx2730109-code/Microduck/01_mechanical/author_tips_20261024/README.md

# 作者补充资料 2026-10-24

目标：保存作者在微信群发布的零位支架和装配提示，供标定与装配时对照。来源为用户提供的群聊截图，未在上游仓库中。

| 文件 | 内容 |
|---|---|
| `chat_zero_jig_announce.png` | 作者说明：0 位支架可打印验证，仅验证了下半部，也可作站立底座 |
| `photo_zero_jig_front.jpg` | 零位支架装机正面，可见舵机铭牌 `HD1910M` |
| `photo_zero_jig_side.jpg` | 零位支架装机侧面 |
| `tip_use_m3_not_self_tapping.png` | 躯干与髋连接处用合适长度的 M3 螺丝拧紧，不用自攻螺丝 |
| `zero_position_jig.3mf` | 同一支架的可打印 3MF，来自用户提供的 `01_mechanical/original_downloads/0位支架.3MF` |
| `zero_position_jig.stp` | 零位支架 STEP，1.3 MB；作者称仅验证了下半部，未验证部分不作为标定依据 |

- 作者实物照片中的舵机铭牌为 `HD1910M`，用户确认与已购 HD-1910-C001 是同一款。
- 支架需自行打印，数量和材料作者未说明。
