xlx2730109-code/Microduck/90_archive/notes/09_资料来源与本地索引.md

# 资料来源与本地索引

目标：说明每份资料的来源、固定版本、本地位置、校验与可复现范围。

## 当前 fanhao 主线：2026-10-24

| 对象 | 固定身份/本地位置 | 使用边界 |
|---|---|---|
| 主仓源码 | `02_feetech/microduck-replica_20261024/`，提交 `915ed8364650dff317d9b80760ee632fa4b1c9ed` | 1095个Git blob全部核验；10月22日旧快照已于2026-10-24删除，见K90 |
| 发布信息 | `90_sources/fanhao_20261024/release.json` | GitHub原始发布元数据，大小/哈希可追溯 |
| 原始源码树 | `90_sources/fanhao_20261024/source-tree.json` | 每个文件的Git blob SHA1 |
| 当前镜像runtime源码 | `02_feetech/Microduck-kissqy_runtime_20261023c/`，提交`0791fcd…` | 1948个Git blob核验，原始树见`runtime-source-tree.json` |
| 模型标注训练上游 | `90_archive/references/03_official/microduck_rl_8d0db749/` | 241个Git blob核验，原始树见`model-training-upstream-tree.json` |
| 独立运动模型 | [模型README](../../02_feetech/models/fanhao_20261023c/README.md) | 10个权重全部匹配发布SHA256；86个模型相关文件；无对应完整PT |
| 系统镜像及附件 | `02_feetech/images/fanhao_20261023c/` | 完整镜像状态以 [版本锁定](../../90_sources/fanhao_20261024/版本锁定.md)为准 |
| 初学者操作 | [装配到首走](../../00_notes/02_分阶段复现指南.md) | 当前执行入口，不混用历史R1/V167 |
| 训练与音视频 | [训练迁移](../../00_notes/08_训练导出与迁移指南.md)、[独立云对话](../../00_notes/07_摄像头与独立云对话指南.md) | 未安装/未实机验证的部分明确标注 |

以下完整仓库和发布附件表保留10月22日的原始归档信息。旧表“fanhao只存小附件”仅指 `20261021b`，不代表当前版本下载状态。

## 完整仓库快照

共 13 套完整快照。ZIP 获取的仓库已检查 CRC；四套逐文件获取的仓库与固定提交的全部 Git blob 核对一致。保留来源原文，没有把来源里的结论当作本机验收。

| 本地目录 | 来源 | 分支/提交 | 获取与检查 |
|---|---|---|---|
| [01_mechanical/microduck-replica-cad](<../../01_mechanical/microduck-replica-cad>) | [fanhao375/microduck-replica-cad](https://github.com/fanhao375/microduck-replica-cad/tree/dabbda7c592e42e0d016a293dc8c9fcabb300bbf) | `master` / `dabbda7c592e42e0d016a293dc8c9fcabb300bbf` | ZIP CRC 通过 |
| [02_feetech/Microduck-kissqy](<../../02_feetech/Microduck-kissqy>) | [kissqy/Microduck-kissqy](https://github.com/kissqy/Microduck-kissqy/tree/525a215a19397767a073b782f57e97cf53683761) | `main` / `525a215a19397767a073b782f57e97cf53683761` | 全部 1936 个文件 Git blob 通过 |
| [02_feetech/Microduck-kissqy-imu-fork](<../../02_feetech/Microduck-kissqy-imu-fork>) | [fanhao375/Microduck-kissqy](https://github.com/fanhao375/Microduck-kissqy/tree/e376346723e1670a649b2a00e4dcec0f3d2a46cd) | `hd1910-v167-trunk-imu-i2c` / `e376346723e1670a649b2a00e4dcec0f3d2a46cd` | 全部 1945 个文件 Git blob 通过 |
| `02_feetech/microduck-replica`（已删除） | [fanhao375/microduck-replica](https://github.com/fanhao375/microduck-replica/tree/813639d668c1dc56bd0aa145a930bb2c9fb5986c) | `master` / `813639d668c1dc56bd0aa145a930bb2c9fb5986c` | 10月22日旧快照，988 个文件核验后于 2026-10-24 删除，哈希清单仍在 `90_sources/metadata/`；当前用 `microduck-replica_20261024` |
| [03_official/elec_RPI_Robot_HAT](<../references/03_official/elec_RPI_Robot_HAT>) | [pollen-robotics/elec_RPI_Robot_HAT](https://github.com/pollen-robotics/elec_RPI_Robot_HAT/tree/6de86283297e4c49a9da8312cd3395ab83c437e3) | `main` / `6de86283297e4c49a9da8312cd3395ab83c437e3` | ZIP CRC 通过 |
| [03_official/microduck](<../references/03_official/microduck>) | [pollen-robotics/microduck](https://github.com/pollen-robotics/microduck/tree/942e58e3aa6dbb28e7037203fff11866122c7567) | `main` / `942e58e3aa6dbb28e7037203fff11866122c7567` | ZIP CRC 通过 |
| [03_official/microduck_rl](<../references/03_official/microduck_rl>) | [pollen-robotics/microduck_rl](https://github.com/pollen-robotics/microduck_rl/tree/b02fdea4902c2b93b7d34a83a6f05da4ececb7d3) | `develop` / `b02fdea4902c2b93b7d34a83a6f05da4ececb7d3` | ZIP CRC 通过 |
| [04_alternatives/awesome-microduck](<../references/04_alternatives/awesome-microduck>) | [joeynyc/awesome-microduck](https://github.com/joeynyc/awesome-microduck/tree/75b59609af34189014787989c3d7910da0232535) | `main` / `75b59609af34189014787989c3d7910da0232535` | ZIP CRC 通过 |
| [04_alternatives/Microduck-build-tutorial](<../references/04_alternatives/Microduck-build-tutorial>) | [AI-FanGe/Microduck-build-tutorial](https://github.com/AI-FanGe/Microduck-build-tutorial/tree/49678215d0b40529522772a40c06c216390449dd) | `main` / `49678215d0b40529522772a40c06c216390449dd` | ZIP CRC 通过 |
| [04_alternatives/microduck-community-kit](<../references/04_alternatives/microduck-community-kit>) | [jyg9/microduck-community-kit](https://github.com/jyg9/microduck-community-kit/tree/35a4bf8a4c7c7038ab7b20f0aa86236101a4d596) | `main` / `35a4bf8a4c7c7038ab7b20f0aa86236101a4d596` | ZIP CRC 通过 |
| [04_alternatives/microduck-diy](<../references/04_alternatives/microduck-diy>) | [wslengzhicheng/microduck-diy](https://github.com/wslengzhicheng/microduck-diy/tree/6c88eb6be07b9003c58a0f0a946bac15305f6bdd) | `main` / `6c88eb6be07b9003c58a0f0a946bac15305f6bdd` | ZIP CRC 通过 |
| [04_alternatives/microduck-hd1910m](<../references/04_alternatives/microduck-hd1910m>) | [zhuoligetu123/microduck-hd1910m](https://github.com/zhuoligetu123/microduck-hd1910m/tree/59d5117d2aa6428150d55250bb8c692b46d818f1) | `main` / `59d5117d2aa6428150d55250bb8c692b46d818f1` | 全部 709 个文件 Git blob 通过 |
| [06_voice/xiaozhi_linux_rs](<../references/06_voice/xiaozhi_linux_rs>) | [haoyn231/xiaozhi_linux_rs](https://github.com/haoyn231/xiaozhi_linux_rs/tree/57981916aafc91b66bba3fc658f7a6be0789c3b6) | `main` / `57981916aafc91b66bba3fc658f7a6be0789c3b6` | ZIP CRC 通过 |

完整固定提交、原始 URL、下载时间、ZIP 哈希或逐文件哈希保存在 `90_sources/repository_manifest.json` 与 `90_sources/metadata/`。逐文件快照不含 Git 历史；原始仓库引用的站外模型、系统镜像、视频和依赖不因此自动包含。

## 直接使用的文件

| 内容 | 本地入口 | 版本/说明 |
|---|---|---|
| 机械装配说明书 | [打开](<../../01_mechanical/microduck-replica-cad/安装说明书/microduck装配安装说明书.pdf>) | 21 页；全文与渲染检查通过，仍需配合 CAD |
| 采购 BOM | [打开](<../../01_mechanical/microduck-replica-cad/BOM/装配BOM-机械行者Robo-2026-10-20-带采购链接.xlsx>) | 33 类打印/23 类外购；公式问题见零件清单，原表未改 |
| 打印工程 | [打开](<../../01_mechanical/microduck-replica-cad/打印/microduck-飞特版-BambuStudio2026-10-20.3mf>) | 飞特 v2.2，材料不能全部套默认 PLA |
| 组件/爆炸图 | [打开](<../../01_mechanical/microduck-replica-cad/组件图>) | 23 张组件图，另有零件预览 |
| 可编辑 CAD 原包 | [打开](<../../01_mechanical/releases_v2.2/SolidWorks-FT2026-10-20.zip>) | 发布方 SHA256 与 ZIP CRC 通过 |
| 已解压 CAD | [打开](<../../01_mechanical/cad_v2.2>) | 77 个 SolidWorks；STEP 包保留原目录，未用 SolidWorks 重建验收 |
| 改动件 STEP | [打开](<../../01_mechanical/releases_v2.2/STEP-changed-parts-FT-2026-10-20.zip>) | 13 个；只包含改动件，不是全套中性格式总装 |
| 系统镜像 R1 | [打开](<../../02_feetech/images/kissqy_R1/microduck-zero3w-0.15.1-R1.img.xz>) | control.40，后续升 control.43；已验发布方哈希，未烧卡 |
| 机器人中控 | [打开](<../../02_feetech/Microduck-kissqy/release-assets/Microduck-Console-R17-V167.zip>) | R17 V167；完整 ZIP CRC 通过，未执行 |
| 训练中控 | [打开](<../../02_feetech/Microduck-kissqy/release-assets/Microduck-Training-Studio-R1.5.27.zip>) | R1.5.27；完整 ZIP CRC 通过，未执行 |
| ZERO ARM64 固件 | [打开](<../../02_feetech/Microduck-kissqy/microduck-hd1910/firmware/console/updates/Microduck-Robotd-FT6-R17.tar.gz>) | control.43，发布方哈希一致；已解析包目录，未安装 |
| STM32 IMU 固件 | [打开](<../../02_feetech/Microduck-kissqy/microduck-hd1910/firmware/console/updates/imu_to_feetech_ReVA_FT6_SYNC15_UART_IRQ_v1.bin>) | FT6，8428 字节，发布方哈希一致，未烧录 |
| AMP2.0 板卡工程 | [打开](<../../02_feetech/Microduck-kissqy/hardware/AMP2.0-VERSION.md>) | 成品配套与原理图/PCB 源文件入口 |
| 飞特调试软件/资料 | [打开](<../../02_feetech/microduck-replica_20261024/tools>) | 原仓自带工具，未安装或执行 |
| 官方 HAT 生产文件 | [打开](<../references/03_official/elec_RPI_Robot_HAT/production>) | D1 当前资料及 _old 历史版；不是可与任何固件互换的承诺 |
| 官方训练参考 | [打开](<../references/03_official/microduck_rl>) | 默认 XL330 参考，HD1910 使用适配执行器与合同 |
| 板端云对话源码 | [打开](<../references/06_voice/xiaozhi_linux_rs>) | 完整 AArch64 候选源码；未与本机 HAT 联调 |

## 发布附件校验

| 文件 | 字节数 | SHA256 |
|---|---:|---|
| [SolidWorks-FT2026-10-20.zip](<../../01_mechanical/releases_v2.2/SolidWorks-FT2026-10-20.zip>) | 417656282 | `71e5b6a711ec9b4dd7154627e036a5180207088536aa230e42949212a550eaa1` |
| [STEP-changed-parts-FT-2026-10-20.zip](<../../01_mechanical/releases_v2.2/STEP-changed-parts-FT-2026-10-20.zip>) | 21667489 | `57570e61e556b51f2f476b961cac2d6ac93250b4190bca3009de13d5f388e9d9` |
| [microduck-zero3w-0.15.1-R1.img.xz](<../../02_feetech/images/kissqy_R1/microduck-zero3w-0.15.1-R1.img.xz>) | 767412924 | `75da978b5d56acd9e4146256431732381de84523bb683e4ab7ac9f0580a7bce5` |
| [microduck-replica-20261021b-licenses.txt](<../../02_feetech/images/fanhao_20261021b/microduck-replica-20261021b-licenses.txt>) | 13323 | `a1e7e5968f45e70a962f4222de4e90ae6ce40fe90072e32506c330f5bf65e7eb` |
| [microduck-replica-20261021b-manifest.txt](<../../02_feetech/images/fanhao_20261021b/microduck-replica-20261021b-manifest.txt>) | 9560 | `fa33be798abefc14203c6e678a52380e98df2b6840b25b6d958952c146e3f687` |
| [microduck-replica-20261021b-models.txt](<../../02_feetech/images/fanhao_20261021b/microduck-replica-20261021b-models.txt>) | 7477 | `539a03996c0f4bd446b78b508eea0a70eda21f55067586eccc77881775f40e4d` |
| [microduck-replica-20261021b-third-party.txt](<../../02_feetech/images/fanhao_20261021b/microduck-replica-20261021b-third-party.txt>) | 4931 | `42f1f6c68cbb1ac2dc684b323909858389962677685bd0516296c37ad4bc109b` |
| [microduck-replica-20261021b.img.xz.sha256](<../../02_feetech/images/fanhao_20261021b/microduck-replica-20261021b.img.xz.sha256>) | 101 | `100ba75f0ee2f2c9b9fa70745c057a41adb5c2842d718f17ec489a62e6cbb9f6` |

以上附件均与 GitHub 发布方 digest 一致。fanhao 20261021b 仅保存镜像清单、许可与哈希文件；**其 `.img.xz` 没有下载**，因为当前采购推荐是配套总线 IMU 路线。R1 是本轮实际下载的系统镜像。

## 厂家与语音参考范围

| 范围 | 本地目录 | 说明 |
|---|---|---|
| 飞特 | [型号、STEP、针序与协议](<../references/05_vendor/feetech>) | Wiki 固定提交 a4f9de2388ade2b9d811635bc748c0c2ff9a7189；仅选取相关文件，不是全部厂家资料库 |
| 微雪 | [产品、接线、FAQ](<../references/05_vendor/waveshare>) | HTML 快照；外链图片可能仍需联网，不等于整站离线镜像 |
| 瑞莎 | [主控与快速上手](<../references/05_vendor/radxa>) | HTML 快照；按实物 PCB 修订继续核对 |
| Python 语音备选 | [说明、许可、依赖](<../references/06_voice/py-xiaozhi>) | 仅选取参考文件，没有下载完整客户端与模型 |
| ESP32 语音备选 | [说明与许可](<../references/06_voice/xiaozhi-esp32>) | 仅选取参考文件，没有下载全部固件或选定具体板卡 |

## 缺口与限制

- B 站 API 本轮返回 `code=-352`，网页访问也有限制。视频目录保留原仓可追溯的前六集地址；搜索结果可见第八集标题，尚未获得其独立 BV 链接。平台视频未下载。
- 微雪文档中的 Adapter A 原理图旧链接返回 404；不以其他型号原理图替代。
- 飞特 Gitee BAM 页面抓取失败，没有把整个厂家 BAM 库计为已下载。适配仓内的现有参数与出处另行保留。
- 部分最初 ZIP/Git 大包传输失败，已用逐文件加 Git blob 校验补齐；这些失败不再意味着仓库缺文件。
- 自然对话是新增集成工作，资料不证明本机能录音、全双工、唤醒、打断或视觉问答。
- 原许可逐目录保留。官方代码、几何与第三方模型/个人中控的许可不同，不为整个资料包统一重新授权。
- 备选 `microduck-community-kit` 的 `firmware/GD32F30x_Firmware_Library` 是外部 Git 子模块，未递归下载。该项不属于当前推荐 STM32 FT6 成品路线；若以后编译该备选固件，需按固定子模块提交补齐厂家库。

## 复核文件

- `90_sources/validation_report.json`：ZIP、固件哈希、CAD 数量与本地链接检查。
- `90_sources/file_inventory.json`：最终文件路径、大小与 SHA256。
- `90_sources/repository_manifest.json`：完整仓库提交与获取方式。
- `90_sources/release_manifest.json`：发布附件及发布方摘要核对。
- `90_sources/web_manifest.json`、`voice_manifest.json`：选取网页/语音参考及失败记录。

本轮没有采购付款、安装依赖、启动第三方程序、烧卡、烧 IMU、写舵机或实机测试。
