xlx2730109-code/Microduck/90_archive/notes/10_回来后统一确认.md

# 用户确认与剩余疑问

目标：保存用户已明确的需求与采购信息，后续不重复询问已确定事项。

| 编号 | 用户已确认 | 对后续的影响 |
|---|---|---|
| Q1 | 已买截图套件；2026-10-24 明确选中 HD-1910-C001、15 舵机＋打印件＋M2 螺丝包＋轴承＋5264 转 AMP2.0 线 | 不重复买整套机械；微雪板仍保留 Q5 的此前确认，另核附送范围 |
| Q2 | 2026-10-24 用户再次确认主控还没买；此前拟选 ZERO 3W 2GB、无 eMMC、带排针 | 记在B015；同批已测2GB可用，4GB为并发余量候选，不登记已下单 |
| Q3 | 2026-10-24 用户确认HAT和躯干IMU都还没买，GY-BMI160为已购不适配件 | 继续核对适配fanhao 20261023c的成套电控，不将BMI160计为反馈补齐 |
| Q4 | 已购两款 NP-F550 电池、USB 单充和简易焊接工具；电池座、TF 卡/读卡器、万用表等仍无已购确认 | 已购物料转入验收，不重复补购；明细以本机 BOM 为准 |
| Q5 | 2026-10-24 用户明确为微雪 Bus Servo Adapter (A) ×1 | 型号和数量关闭询问，按Adapter A核对发货修订、跳线和针序，不照URT-2接法 |
| Q6 | 首版要摄像头及自然对话、回答问题 | 原始叫声功能不足，单独安排语音集成 |
| Q7 | 不依赖电脑，允许 Wi-Fi 云端 AI | 不要求小鸭本地运行大模型 |
| Q8 | 优先成品，减少焊接开发，预算不设限制 | 采购已焊、已刷、已测的板卡和线束 |
| Q9 | 已有四足项目手柄 | 历史记录为 TGZ Controller，6 轴/13 键；Microduck 映射未测 |
| Q10 | 已买的东西若不对，须主动提醒 | 检查型号、接口、版本、结构和配套；发现不合适时说明影响与补救，不仅登记已购 |
| Q11 | 轴承最终确认为大 11＋小 3，共 14 个；打印件没问题 | 关闭轴承数量和打印件是否适用的采购疑问，不再重复询问 |
| Q12 | 买什么就记入文档，作为本机 BOM | 统一在 `01_BOM表.md` 记录型号、数量、证据和状态，其他文档引用该主表 |
| Q13 | 新增两笔 GY-BMI160、VL53L8CX 与焊接套装订单 | 记录 B012–B014；BMI160 不适配当前躯干路线，ToF 板型有空间风险，建议与实际退换状态分别维护 |
| Q14 | BOM 要加入主控、电控、IMU 等完整模块 | 同一主表列已购、拟购和待购，并补用途、数量、成套边界与连接关系，避免把需求当已购 |
| Q15 | 按fanhao375/microduck-replica全盘整理，面向初学者，以最短周期完成 | 当前主线改为fanhao镜像与配套Studio；当前入口为02/08/07指南，旧路线归档 |

全部套装、供电、传感器与工具订单统一见 [本机 BOM](../../00_notes/01_BOM表.md)。截图的已揽件不代表实物已到货或已通过验收；BMI160 已购也不代表配套 FT6 躯干 IMU 已补齐。

## 剩余事项

以下为到货和卖家配套核对项，不再重复询问用户目标：

- 已购两款电池各自件数、完整型号、电压、外形/质量、放电能力；已购 USB 单充的铭牌与适配说明。
- 两笔 BMI160 是否退货或保留开发备件；VL53L8CX 模块外形/孔距与脸壳配合；焊接套装实际内容。没有用户确认前不登记为已退款或已换货。
- 电池座/触点和相机/音频成品是否配齐；实际安装空间与线束走向按装配验收记录，不再重复质疑用户已确认的打印件。
- 微雪Adapter A发货修订、跳线和接口；转接线数量、长度和针序。准确型号与1块数量已经确认，不再重复询问。
- 成品HAT/IMU/HUB修订、接口、固件/协议、配套主控修订和fanhao 20261023c实测范围。
- 主控截图呈补货状态，需确认个人可买的库存、2GB/4GB 各自实价、发货批次和排针已焊；BOM B015 未登记为已下单。
- 麦克风、扬声器与 HP1.25 线束是否配齐，实际录放音与相机出图是否通过。
- TGZ 的接收器/USB/蓝牙模式、轴键映射和实际 Wi-Fi 频段。

具体型号与采购状态见 [本机BOM](../../00_notes/01_BOM表.md)，可发卖家的文本见 [当前执行指南C2](../../00_notes/02_分阶段复现指南.md#c2-发给电控卖家的核对内容)。本轮未代发消息、下单、刷卡或写舵机。
