xlx2730109-code/Microduck/90_archive/notes/11_硬件型号版本选型调研.md

# Microduck 硬件型号与版本选型

目标：保留已购 HD-1910 套件，以成品配套、可靠供电和可维护性为优先，完成独立行走、摄像头与云端自然对话。

选型检索：2026-10-22 至 2026-10-23；采购同步：2026-10-24。本文记录候选依据；已购状态以本机 BOM 为准，尚未接硬件或完成整机验证。

2026-10-24 已购更新：机械、供电、传感器与工具统一登记在 [本机 BOM](../../00_notes/01_BOM表.md)。轴承数量和打印件疑问已关闭；已购电池与单充先验收。新增 BMI160 不能替代当前 FT6 躯干 IMU，已购 VL53L8CX 须核对板型；具体处理见 BOM。其他品牌电池/充电器保留备选，不自动列为还需购买。

用户另提供的聊天式购物建议已在本机 BOM 的“外部采购建议的复核”逐项核对：不采用其中 HAT 头/身 IMU 混用、BMI160 直插免适配、“拒绝4GB”和全机按6V理解的说法。采购仍按下表具体版本与实际卖家成套证明核对；表格模块名不等于同名商品均可直接互换。

## 1. 建议先研究的组合

| 部分 | 本轮建议 | 数量 | 决定条件 |
|---|---|---:|---|
| 主控 | **Radxa ZERO 3W，4GB、无 eMMC、已焊 40Pin 排针**，SKU `RS107-D4E0H1W15` | 1 | 优先取得同批 PCB/Wi-Fi 与运动镜像验证；2GB 已测成套方案仍可优先交付 |
| 主控备选 | ZERO 3W，2GB、无 eMMC、带排针，`RS107-D2E0H1W15` | 与上项二选一 | 与目前社区实购基线更接近；不是低质量版本 |
| 电控 HAT | **kissqy AMP2.0 接口版，2026-10-15 工程对应 PCBA 成品** | 1 | 已焊、供电/总线/音频已测，附板卡修订与实际照片 |
| 躯干 IMU | **STM32G031F8P6＋LSM6DSV16XTR，配套 AMP2.0 板，已刷 FT6_SYNC15_UART_IRQ_v1** | 1 | 卖家确认 ID 200、1Mbps、实际数据更新；与所选 robotd 配套 |
| 分电与触点 | 匹配现有飞特打印件的 HUB、NP-F 电池触点板、固定件与成品线 | 1 套 | 不能仅凭“Microduck 通用”下单；确认总线针序、接口和结构 |
| 摄像头 | **Radxa Camera 8M 219，Sony IMX219** | 1 | 原厂板型，确认现有面板孔位 |
| 摄像头线 | **22Pin/0.5mm → 15Pin/1.0mm，同面 FPC** | 1＋备件 | ZERO 3W 对应版本；原厂默认 150mm，短线按实际走线选择 |
| 工作/备份卡 | **三星 PRO Endurance 128GB，MB-MJ128KA/CN** | 2 | 正规渠道；按 2022 款完整料号辨认，替代地区后缀单独核对 |
| 读卡器 | **SanDisk MobileMate USB 3.0，SDDR-B531** | 1 | USB-A；若电脑仅 USB-C，另选可靠转接或同级 USB-C 读卡器 |
| 电池 | 已购两款 NP-F550，详见 BOM B008/B009；**Hollyland HL-NP550**及社区款仅作备选 | 实购件数见 BOM | 先验收已购件的仓位、重量、电压与放电能力，不重复下单 |
| 充电器 | 已购 USB 单槽充电器，详见 BOM B010；**NITECORE USN3 PRO**仅作升级备选 | 实购数量见 BOM | 先核对已购铭牌及适配，不因品牌不同就判断买错 |
| 扬声器 | **3525 腔体、4Ω/3W、HP1.25 2P 成品线** | 1 | 参考样机规格；由 AMP2.0 HAT 卖家配套，不默认线序相同 |
| 麦克风 | 先用 HAT 的 **LMA2718T421-OA5-2 模拟 MEMS**及其匹配模拟输入 | 随 HAT | 要录音样例与录放音验证；不直接买 I²S 麦克风代替 |
| 音频升级候选 | **Seeed reSpeaker Lite，SKU 107990273，USB 固件、双麦、XMOS XU316** | 可选 1 | 建议先台架评估；35×86mm，尚未确认装入现有头壳 |
| 主控台架电源 | **Radxa Power PD 30W**，按国行插头与原装线购买 | 1 | 用于主控独立台架；整机电池由配套 HAT 降压，不给舵机接 USB 5V |
| 散热 | **Radxa Heatsink 5519A**为尺寸核对候选 | 1 | 检查与 HAT、排针和头壳间隙后决定，不先叠风扇 |
| 台架直流电源 | **SIGLENT SPD1168X**；更高电流需求选 RIGOL DP813A | 二选一 | 前者 16V/8A；后者高量程 20V/10A、低量程 8V/20A；设置由现场分阶段确定 |
| 万用表 | **UNI-T UT61E+**；品牌偏好可选 Fluke 17B+ | 二选一 | 直流电压、通断与线序核对；不以表面功能数判断质量 |
| 机械工具 | Wiha 精密十字 #00/#0，按实物配六角；Mitutoyo 500-196-30 卡尺可选 | 各 1 套 | 手动装配；卡尺用于孔距、板厚、插座与电池尺寸测量 |
| 启动排障线 | **FTDI TTL-232R-3V3**＋适配跳线 | 选配 1 | 3.3V 信号、支持高速 UART；用于 ZERO 启动日志，不替代舵机调试板 |

优先花预算在明确修订、PCBA 测试、连接器和线束、供电、真实存储卡上。主控与相机更换平台会增加驱动、外形和训练基线核对工作，暂不作为首轮升级方向。上述推荐是工程判断，不是本机测试排名。

## 2. 主控：4GB 优先候选，批次与镜像比容量更关键

| 版本 | 型号/SKU | 对本项目的意义 | 建议 |
|---|---|---|---|
| ZERO 3W 2GB，无 eMMC，排针已焊 | `RS107-D2E0H1W15` | 现有社区运动基线与采购记录清楚 | **最快成套备选** |
| ZERO 3W 4GB，无 eMMC，排针已焊 | `RS107-D4E0H1W15` | 给语音、相机服务和日志留更多内存；CPU 仍相同 | **本轮优先询价** |
| ZERO 3W 4GB＋32GB eMMC，排针已焊 | `RS107-D4E32H1W15` | 内存满足候选目标；仍可评估用 TF 卡启动，但须核对启动介质与现有系统 | 无 eMMC 款缺货时可接受的候选 |
| ZERO 3W 8GB | 按是否 eMMC/排针区分 | 没有证据说明本项目需要 8GB，CPU 并未同步提升 | 不为容量单独加价 |
| ZERO 3W 1GB | 按实际 SKU | 可参考原运动架构；首版还要自然对话，余量较少 | 新购不优先 |
| ZERO 3E、ZERO 2 Pro、Orange Pi Zero 3W、Cubie A7Z、树莓派 5/Zero 2W | 不同平台 | 名称或外形接近不等于现有镜像、HAT、CSI 和串口配置兼容 | 不作为同型号替代下单 |

SKU 依据原厂规格书 [S01]；4GB 的选择理由之一是候选 Python 语音客户端公开建议至少 4GB [S23]。这并不证明它已在 ZERO 上跑通，也不意味着 2GB 的轻量 Rust 客户端方案一定不可用。

### 2.1 板卡批次要记录什么

| 必须取得 | 为什么 |
|---|---|
| PCB 正反面照片与完整丝印 | `V1.12` 等简称不能唯一识别全部物料批次 |
| Wi-Fi 模组/芯片标识 | 原厂 FAQ 说明早期与当前无线方案不同；不能只看商品标题的 Wi-Fi 6 |
| 实测过的镜像文件名、哈希或下载地址 | 社区曾遇到相同系列板卡需要不同引导/DTB 的情况 |
| 冷启动、重启、Wi-Fi/蓝牙及外设测试范围 | “能亮灯”或“官方系统能开机”不等于机器人镜像及外设全部通过 |

官方硬件变更页主要记录板级物料变更，不提供完整供应商映射；FAQ 中还有更细无线批次描述 [S02][S03]。社区对 V1.12 与 V1.12J 记录了引导/设备树差异 [S04]。因此不写死“某个版本一定好”，优先取得与实际批次配套的测试结果。

### 2.2 本轮能确认的购买状态

2026-10-24 用户新截图指向 2GB 无 eMMC 带排针，已登记为 BOM B015 拟购。截图选项灰显，底部写补货中，页面 ¥888 无法归属为已确认配置价；不能据此认定原淘宝已恢复可售、个人最少须买 100 块或用户已经付款。库存、零售价格、交期与实际 PCB/Wi-Fi 批次都待卖家明确，证据 P5 见本机 BOM。

| 入口 | 已核实 | 未核实 |
|---|---|---|
| [Arace ZERO 3W](https://arace.tech/products/radxa-zero-3w) | 页面显示 **2GB 无 eMMC 带排针 SKU，US$39.99，In stock** | 4GB 选项的成交价/库存、板卡修订、配送与发货时间 |
| [京东 RADXA 官方店 2GB 对应页](https://ic-item.jd.com/10147078913756.html) | 商品标题为所需 2GB 配置 | 页面未返回价格和地区库存 |
| [安联新创淘宝店](https://allnetchina.taobao.com/) | 瑞莎旧官方渠道页列有该店 | 未读到可核实的新商品 SKU 或库存 |
| [旧淘宝商品](https://item.taobao.com/item.htm?id=763812025816) | 用户截图确认下架 | **不再作为购买入口** |

Arace 的 US$39.99 对应页面所示 2GB SKU，不能套给本轮 4GB 推荐款。内存不同的报价、库存分别核对。

当前建议仍为：首版包含相机和云对话时优先取得 4GB 无 eMMC 已焊排针、同批验证的组合；2GB 已测整套可以作为快速交付路线，需采用轻量客户端并验收并发资源占用。这是余量与交付的选型判断，不是已经完成两种内存的横向实测。完整模块与采购状态统一在本机 BOM，不能用本报告候选表代替订单。

## 3. HAT、IMU 与 HUB：购买一套完整配套

### 3.1 HAT 版本比较

| 对象 | 差异 | 购买判断 |
|---|---|---|
| kissqy AMP2.0，2026-10-15 工程 | 总线 AMP2.0 3P，音频 HP1.25 2P；新增 RX 指示相关器件 | **现有飞特套件优先询价的版本** |
| kissqy 原 EH2.5 接口版 | 插座和配套线束不同，原采购成本表对应此版 | 有成套已测件也能评估；不能照搬 AMP2.0 插头 |
| Pollen HAT C1 | 复刻作者有使用记录；原官方设计并非飞特线束专版 | 要核对总线与音频转接 |
| Pollen HAT D1 | 官方列出换用 LSM6DSV16X、RS485 和音频端子变更 | 更新不代表对旧复刻镜像更成熟，须单独核对 |
| fanhao 新版三板 | 公开工程有参考价值，README 仍记为未打样实测 | 不作为成品优先目标的直接下单方案 |

工程依据 [S05][S07][S08]。HAT 内置的头部 IMU 不等同于躯干 IMU；本项目保留独立躯干反馈位置。

推荐版的主要器件为 `TLV320AIC3104IRHBR` 音频 codec、`PAM8406DR` 功放、`AP63205WU-7` 5V 降压与 `LMA2718T421-OA5-2` 板载模拟 MEMS。核对来源为本地 `AMP2.0-BOM.json`；这些是成品识别依据，不是让用户逐颗买元器件。

### 3.2 躯干 IMU 比较

| 方案 | 具体对象 | 软件要求 | 本轮判断 |
|---|---|---|---|
| STM32 总线成品 | STM32G031F8P6＋LSM6DSV16XTR，匹配 RevA/AMP2.0 板，FT6 | V167/control.43 或明确支持 FT6 的 fork/镜像 | **优先**，减少自焊和固件适配 |
| LSM6DSV16X 模块直连 I²C | 3.3V 模块，地址 0x6A/0x6B | 采用支持该模块的 fanhao fork | 备选；模块排针和固定方式也需处理 |
| BNO085/BNO086 模块直连 I²C | 对应模块及正确接线 | 对应 fork；注意融合模式和该版本实机记录 | 不因“九轴/自带融合”就判定更稳定 |
| GD32 社区 IMU 或其他 imu_to_dxl | MCU、寄存器和固件可能不同 | 按该板专用运行时合同核对 | 不把 STM32 FT6 文件刷到其他 MCU |
| MPU6050、ICM42688 等通用模块 | 传感器型号不同 | 驱动、融合、安装与时序需另适配 | 不作为免开发替代品 |

FT6 当前合同为 **飞特协议、1Mbps、ID 200**，固件与主控服务分开升级 [S06]。不能只凭名称 `imu_to_dxl` 或 LED 亮就判定买对。I²C 方案还须注意 D1 板上 LSM6DSV16X 已占 0x6A，外置模块需避让；旧 fork 文档与最新镜像的验证范围应分别阅读 [S08][S09]。

### 3.3 下单描述中必须写清

| 项目 | 要求 |
|---|---|
| HAT | 已焊 PCBA；工程日期、接口版、正反面照片；同批 ZERO 的 5V、总线与录放音测试 |
| IMU | MCU 与传感器完整型号、FT6 文件名、ID/波特率、转动时数据更新证明 |
| HUB/触点板 | 匹配用户现有飞特打印件；电池接触件、固定件和线束范围列明 |
| 线束 | 主电源与信号分支分别明确；端子系列、针序、长度与实际线规可追溯 |
| 整套 | 给出已测镜像/robotd/IMU 固件组合；样机标定仅作参考，到本机重新标定 |

在此类社区 PCBA 上，清楚的工程来源、焊接检查和负载测试比商品名中的“高配”更有判断价值。尚未收到卖家报价或测试材料。

**已购提醒：GY-BMI160 不是这套 FT6 板的替代品。** 当前归档支持的躯干 IMU 路线没有 BMI160 驱动，HAT 资料中的 BMI088 也不等于 BMI160。如果是为首版躯干姿态反馈购买，建议退掉或作为开发备件，不为了消化已购物料扩展驱动；实际退换状态以本机 BOM B012 为准。仍需配套 STM32G031＋LSM6DSV16X 的已刷 FT6 成品板。

## 4. 相机与 ToF：原厂 IMX219 保持兼容

| 选择 | 优点 | 代价/限制 | 建议 |
|---|---|---|---|
| **Radxa 8M219 原厂模组** | 明确为 IMX219，官方列出 ZERO 3W 兼容与专用排线 | 本机镜像仍需启用相机并验证长期出图 | **首版推荐** |
| 通用 IMX219 板 | 可能便宜或提供不同镜头 | 芯片相同不保证孔位、FPC、触点、镜头高度和调试参数相同 | 有完整尺寸与驱动证据才选 |
| Raspberry Pi Camera Module 3 / IMX708 | 支持自动对焦，传感器规格更新 | 树莓派生态的兼容声明不等于 ZERO 兼容；模组高度变化 | 首轮不替换 |
| USB 摄像头 | 可走 UVC，调试方便 | USB 口、外形、重量和线缆占用增加 | 台架备选，非原面板直接替换 |

原厂明确的 FPC 是 **22P/0.5mm → 15P/1.0mm，同面**，不是“买一条 22Pin 线就行” [S10]。相机与主控都在头部，排线无需跨脖子；默认 150mm 可按头内走线整理，追求短线时先核对折弯和插座位置。

Camera Module 3 的对焦能力与更高模组高度来自树莓派规格书 [S11]；上述不优先换用的结论是兼容性判断，不是画质测评。

ToF 是可选扩展；用户已购 VL53L8CX，先按 BOM B014 核对外形/孔距，暂不重复买。该芯片在归档驱动支持范围，但作者常见长板样品约 33.4mm 长、孔距约 28mm，曾装不进默认脸壳；这些不是本机实测。若确实不匹配，可换 **VL53L5CX 小载板 V2＋盖片、匹配面板孔距**，不为可选传感器改已确认的打印件或拖延首走。不能买成 VL53L0X、VL53L1X 或 VL53L7CX 后期待原程序直接识别。芯片功能看 ST 资料 [S12]，板型与踩坑见复刻采购记录 [S13] 和本机 BOM 所列原文。

## 5. 存储：指定系列与料号，工作卡加回退卡

**2026-10-24当前选型：系统盘首选改为Samsung PRO Plus 128GB，`MB-MD128SA`系列、UHS-I/A2/U3/V30、两张；原Endurance优先建议降为备选。** 本轮按系统盘和维护用途选型，未做本机随机I/O/耐久横测；A2不等于耐久保证，64GB已够用。采购状态见B024，具体理由和原厂链接见 [执行指南C1](../../00_notes/02_分阶段复现指南.md#c1-tf-卡直接购买规格)。下表保留此前比较依据，其“优先候选”为历史时点。

| 产品 | 指定版本 | 取舍 |
|---|---|---|
| **Samsung PRO Endurance 128GB** | `MB-MJ128KA/CN`；其他地区后缀核对同代 | **优先候选**。原厂针对持续写入；不是以最高标称读速作为唯一指标 |
| SanDisk MAX ENDURANCE 128GB | `SDSQQVR-128G-GN6IA` | 耐久系列备选；购买时核对容量与料号，官网动态页默认容量可能跳变 |
| Samsung PRO Plus 128GB | `MB-MD128SA` 系列，U3/V30/A2 | 偏性能的备选；与 Endurance 的用途取舍不同 |

三星国行 Endurance 128GB 页列出最大 100/40MB/s、U3/V30 和持续视频写入测试条件 [S14]。**不再把“A1/A2”与“耐久卡”强制捆成一个筛选条件**；A2 描述应用性能，不能代替耐久用途声明，反过来也不能凭 Endurance 名称推定 Linux 随机 I/O 最快。主控实际接口也会限制达到的速度 [S15][S16]。

本机尚未做卡速和耐久测试。两张卡的作用是工作与可回退备份，不是 RAID。推荐配 **SanDisk MobileMate USB 3.0 SDDR-B531**，型号已在品牌支持页核实 [S17]；SD 转接套本身不等于 USB 读卡器。

## 6. 电池：品质、放电能力、尺寸与重量一起核对

**采购状态更新：已购 B008/B009 两款电池，先完成验收。** 下表为前期候选比较，不是当前缺件订单。商家标称容量和“进口电芯”不能代替电芯料号或放电能力资料，已购评估统一见本机 BOM。

| 候选 | 已公开的具体规格 | 本项目的判断 |
|---|---|---|
| **Hollyland HL-NP550** | 7.2V、2000mAh、100g，充电限制 8.4V | 品牌薄款候选；官方页未列持续放电电流，须取得该数据后再确定 |
| 沣标 NP-F550 2200mAh | 社区作者采购并使用的两电＋双充款 | 复现基线候选；同名 SKU/容量和卖家批次仍要核对 |
| **SmallRig 4331 USB-C NP-F550** | 经销支持页列 70.6×38.5×22.8mm、最大输出 10A；页面同时存在两处重量数据 | 电流资料较完整，但比常见薄款更厚；先核对电池仓和实称重量，不能默认直装 |
| Deity NP-F550 / FB-NP-F550-DT | 7.4V、3350mAh，LG 电芯；厂商定位包括低功耗 NP-F 设备 | 容量与电芯信息清楚，但不是机器人高峰值电流适配证明 |
| F750/F970 或大容量改装包 | 更大的外形、重量或不同结构 | 不作为首轮续航升级 |

来源 [S18][S19][S20][S21]。SmallRig 页列 `Product Weight 133±5g` 与 `Battery Weight 112±5g`，本报告保留该冲突，不自行选一个当实测值。其标称 3500mAh 与电池额定 3300mAh 也属于不同字段。

**已购电池仍须通过适配验收。** 优先取得：实物长宽厚、称重、连续/峰值放电及保护限流说明，再与打印件配合。换大电池会改变质量和重心，未验证前不承诺更长续航或更稳步态。

“10A 电池”也不代表每个 HUB、触点和小插座都能连续通过 10A。整机供电要结合实际压降、温升和各段接插件核对；台架电源或电池均不以全部舵机同时堵转为正常工况。

### 6.1 充电器

**本机已购 USB 单充先验收，NITECORE USN3 PRO 保留为升级备选。** 该备选官方明确列出 NP-F550，输出 8.4V，QC 模式可双槽各 800mA [S22]。这些规格不属于已购单充，不能混填；仅有 USB-C 插头不等于可用快充档。

若改选 SmallRig 4086，须另取得当前版原厂规格与实际 SKU。它目前保留为询价候选，不用经销商的“索尼电池通用”一句话代替确认。充电时取下电池单独充，不将充电器当机器人台架电源。

## 7. 自然对话：音频前端与对话软件分别选

| 方案 | 硬件 | 适用优势 | 尚需完成 |
|---|---|---|---|
| **紧凑基础方案** | HAT 自带模拟麦克风＋3525 喇叭 | 体积和布线改动较少，先复用运动电控 | ALSA 录放音、舵机噪声下拾音、回声和打断验收 |
| **音频品质升级候选** | reSpeaker Lite `107990273`，XU316 双麦，USB 固件 | 专用音频前端提供回声/干扰处理和降噪；支持 USB 音频 | 35×86mm 的装配、重量、5V 余量、播放参考路径、Linux 客户端联调 |
| 独立小智语音板 | 完整型号明确的 ESP32-S3 成品 | 对话可作为独立模块运行 | 增加电源/安装/控制接口；与原相机、手柄和动作的配合需开发 |
| Waveshare ESP32-S3-AUDIO-Board | ESP32-S3R8、16MB Flash/8MB PSRAM、ES8311/ES7210、双麦 | 有专门音频硬件与 ESP-SR 资料 | 不是 USB 麦克风的同义词，也不证明原头壳能装；暂作为台架候选 |

reSpeaker 的产品与固件类型依据 [S24][S25]。USB 音频模式选 `107990273` 并确认 USB 固件；带 XIAO 的 I²S 配套版本不默认是相同即插即用体验。裸阵列板没有完成云端自然对话，仍需要本机客户端和云服务。

Waveshare 板卡的芯片与接口信息来自原厂 Wiki [S35]；本轮未从其尺寸图确认裸板可用安装空间，因此不将它列为整机直接替换件。

回声消除要有正确播放参考。若声音只从 HAT 播放、阵列只负责拾音，不能默认阵列芯片已拿到参考、AEC 就会生效。验证时应让播放走该音频设备支持的参考链路，或采用明确支持外部参考的方案。

### 7.1 麦克风与扬声器的具体要求

| 项目 | 本轮规格 | 不采用的泛化采购法 |
|---|---|---|
| HAT 麦克风 | 板载 `LMA2718T421-OA5-2`；外置款需匹配带偏置模拟输入 | 将 INMP441/I²S 麦直接插模拟输入 |
| HAT 扬声器 | 3525 腔体、4Ω/3W，配 AMP2.0 版 HP1.25 2P | 单纯换大功率、大腔体，以为必然更清楚 |
| 阵列方案扬声器 | 按阵列功放、负载和参考链路确认 | 将两个功放的输出并接同一喇叭 |
| 拾音安装 | 麦孔露出、隔离振动与线束遮挡，检查离喇叭和舵机位置 | 只按芯片信噪比宣传判断整机效果 |

### 7.2 软件候选与首版边界

| 客户端 | 已核实能力 | 选择条件 |
|---|---|---|
| `xiaozhi_linux_rs` | AArch64 目标、ALSA、云端协议与音频；不内置离线唤醒/AFE | 轻量方案候选，仍需确认 ZERO 系统库与实际声卡 |
| `py-xiaozhi` | ARM/Linux、语音和视觉工具；README 建议至少 4GB | 4GB 候选理由之一；未完成本机资源占用验证 |

来源 [S23][S26]。本机运行客户端、Wi-Fi 调云端，满足用户“不依赖电脑”的方向。摄像头出图、模型理解画面、语音触发机器人动作是不同集成项，首版应分别验收；运动由原控制服务管理。

## 8. 工具：具体型号与投入优先级

| 项目 | 推荐/备选 | 依据与本项目用途 | 优先级 |
|---|---|---|---|
| 台架电源 | **SIGLENT SPD1168X** | 16V/8A、128W、线性电源；原厂商城页面 ¥2,071、有货 | 优先候选 |
| 更高电流台架 | **RIGOL DP813A** | 8V/20A 与 20V/10A 两量程；8.4V 不在 8V 量程内 | 如需更大余量，替代上一项 |
| 万用表 | **UNI-T UT61E+** | 真有效值、22000 显示、数据传输；重点用于直流电压和通断 | 建议有一台 |
| 万用表备选 | **Fluke 17B+** | 品牌与售后取向的备选；本项目不需据此升级所有精度指标 | 与上一项二选一 |
| 数显卡尺 | **Mitutoyo 500-196-30** | 0–150mm、分辨率 0.01mm；长期机械测量工具 | 可选；正规品牌同用途款也可 |
| 精密螺丝刀 | **Wiha Precision Phillips，#00/#0** | 选匹配螺丝头的刀型；六角尺寸按实物清点补齐 | 建议手动装配 |
| 启动串口 | **FTDI TTL-232R-3V3** | 厂家列 3MBaud、3.3V UART；ZERO 调试波特率为 1,500,000 | 启动问题排障备件 |
| 主控独立供电 | **Radxa Power PD 30W** | 原厂支持 5V 大电流；用匹配线缆和国行插头 | 主控台架用 |
| 其他 | 镊子、标签、热缩、绝缘材料、承托支架、少量替换螺丝 | 降低装配损伤和反复等待 | 按现有工具补缺 |

出处 [S27]–[S34]。SPD1168X 的 8A 不是“任何动作都够”的保证；DP813A 的 20A 更不是允许线束或舵机消耗该电流的许可。分阶段设置限流，触发恒流后该次运动测试的供电条件已经改变。

FTDI 的 `3V3` 指 UART 信号电平，其线缆供电针仍可能是 5V [S33]；排启动日志按主板说明连接信号与共地，不把供电针随意接进板内。已有微雪舵机调试板与这种普通 UART 排障线用途不同。

不把焊台、热风枪、ST-LINK、示波器和电子负载列为首版必购。成品电控未能提供应有测试时，先解决供应配套；不能用增加一桌工具替代合格成品交付。

## 9. 价格与购买入口：不将估计包装成报价

| 项目 | 本轮状态/金额 | 解释 |
|---|---|---|
| ZERO 3W 2GB | **US$39.99，Arace 页面显示有货** | 对应所示 2GB SKU；4GB 另询价；未核运费和地区配送 |
| reSpeaker Lite 107990273 | **US$24.90，Seeed 页面显示有货** | 裸 USB 音频前端选项；不含已完成整机安装/云对话 |
| SPD1168X | **¥2,071，原厂商城显示有货** | 仅台架电源，不含其他工具 |
| SmallRig 4331 | 页面显示 **US$44.90** | 技术对比与价格参考；不据此确认中国内地到手价或装配适用 |
| 8M219 / 3525 喇叭 / 沣标两电双充 | 历史订单 ¥129.99 / ¥3.08 / ¥84.59 | 仍是历史价，未验证当前对应 SKU |
| HAT＋IMU＋HUB＋线束 | **待整套报价** | 最大未定项之一；不引用裸板元器件分摊成本当成品售价 |
| 三星国行 Endurance 128GB | 官方规格页标售完 | 可核规格，不证明授权零售渠道无货；本轮未核到国内实时成交价 |

按本轮品质取向，**缺件可先预留 ¥2,000–3,500；若连专业电源、万用表与较好机械工具全部新买，再预留约 ¥3,500–5,000 工具资金**。这是资金规划判断，非已报价项目相加；总预留约 ¥5,500–8,500，不含已购机械/舵机、代装、运费和云端服务。最终应按选定电池、卡、主控与成品电控实际报价重算。

上一轮 ¥1,100–1,500 缺件及 ¥500–1,000 工具属于早期占位，不是本轮品质配置总价；仅选 SPD1168X 就已超出上一轮工具预留。专业工具可以服务后续机器人项目，但并非每件都必须买最高档。

### 9.1 淘宝与官方入口

| 物品 | 商品/品牌入口 | 需选择的具体版本 | 核实程度 |
|---|---|---|---|
| 主控 | [Arace](https://arace.tech/products/radxa-zero-3w)、[京东官方店对应 2GB 页](https://ic-item.jd.com/10147078913756.html)、[安联新创淘宝店](https://allnetchina.taobao.com/) | 4GB 无 eMMC 已焊排针优先询价；2GB 已测成套备选 | 见 §2.2 |
| HAT/IMU | [作者淘宝成品入口](https://item.taobao.com/item.htm?id=1095121548583) | AMP2.0 PCBA＋STM32 FT6，成品范围明确 | 入口来自作者；现价/库存未读到 |
| 相机 | [原采购商品](https://item.taobao.com/item.htm?id=768918125679) | Radxa 8M219，ZERO 3W 同面转接排线 | 历史入口，未核当前库存 |
| 扬声器 | [原采购商品](https://item.taobao.com/item.htm?id=683920556900) | 3525，4Ω3W，匹配端子与线序 | 历史入口 |
| 飞特成品线 | [原采购商品](https://item.taobao.com/item.htm?id=825340808235) | AMP2.0、长度按配套，不能只看标题 | 历史入口 |
| 电池 | [Hollyland 型号页][S18]、[原沣标套装](https://item.taobao.com/item.htm?id=585415365001)、[SmallRig 4331 支持页][S20] | 先核薄款尺寸与放电；4331 暂不认定直装 | 规格与历史入口，非统一现货订单 |
| 充电器 | [NITECORE USN3 PRO][S22] | USN3 PRO，NP-F550 兼容 | 原厂规格已核；国内现价待查 |
| 存储卡 | [三星国行 MB-MJ128KA/CN][S14] | 128GB、KA 代完整料号 | 原厂规格已核；官网售完 |
| 读卡器 | [SanDisk SDDR-B531 支持页][S17] | MobileMate USB 3.0，USB-A | 型号已核，购买渠道待定 |
| 阵列 | [Seeed 107990273][S24] | USB 双麦 XU316，不带额外 XIAO | 页面显示有货 |
| 台架电源 | [鼎阳官方商城][S27] | SPD1168X，16V8A | 页面有货；也可向品牌授权淘宝店核同 SKU |
| 万用表 | [优利德 UT61E+][S29]、[Fluke 17B+][S30] | 精确到 `E+` / `17B+`，配原装表笔 | 规格核实，国内成交价未核 |

找不到可信的新淘宝商品页时，保留型号与品牌入口供人工核对，不生成看似真实的商品 ID。淘宝搜索可直接粘贴：`Radxa ZERO 3W 4GB 无eMMC 带排针`、`MB-MJ128KA/CN`、`NITECORE USN3 PRO`、`UT61E+`、`SPD1168X`。这些搜索词不是库存证明。

## 10. 可复制给卖家的核对文字

> 我在复刻飞特 HD-1910-C001 Microduck，已有 15 个舵机、打印件、微雪调试板、轴承螺丝和部分转接线。请按免焊成品配套报价：Radxa ZERO 3W 4GB 无 eMMC 已焊 40Pin 排针；如果你们只有已测的 2GB 套装，也请单列。请提供 PCB 丝印、无线模组照片及已测镜像版本。HAT 要 kissqy 2026-10-15 AMP2.0 接口工程对应成品；躯干 IMU 要 STM32G031F8P6＋LSM6DSV16X、已刷 FT6_SYNC15_UART_IRQ_v1、ID200、1Mbps。请同时列 HUB、电池触点板、接触件、固定件和全部成品线束的型号、接口、数量与长度，并确认与我的打印件适配。相机要原厂 Radxa 8M219 和 ZERO 3W 对应同面 FPC。音频要已测录音与播放、3525 4Ω3W 扬声器及匹配线，不只写“支持语音”。请说明做过哪些供电、总线、IMU、相机和音频测试，哪些尚未测，给出整套实物照片、交期和分项价格。样机标定不替代我这台的重新标定。

本轮仅准备文字，未代发消息、询价或付款。

## 11. 用户审阅后需要冻结的项目

| 待冻结项目 | 已有判断 | 尚缺证据 |
|---|---|---|
| 主控 4GB 或 2GB 成套 | 4GB 为本轮优先询价；同批已测更重要 | 实际货源、PCB/Wi-Fi、配套镜像 |
| HAT/IMU/HUB 成品整套 | AMP2.0＋STM32 FT6 优先；已购 BMI160 不能抵扣 | 卖家明确板号、线束、测试与价格 |
| 已购 ToF 与开发模块 | VL53L8CX 芯片支持；BMI160 不适配当前路线 | ToF 板型与脸壳尺寸、BMI160 实际退换或备件安排 |
| 已购电池与单充 | 已纳入本机 BOM，其他品牌暂不重复下单 | 两款实购件数、铭牌、尺寸/质量、放电能力与单充适配 |
| 音频 | HAT 先验收；专用前端可提升候选能力 | 头壳空间、参考音频路由、功耗与真机拾音效果 |
| 工具档次 | 已列品牌与具体型号 | 选择哪些购入、现有工具是否可复用 |

用户已确认打印件没问题及轴承数量。剩余为微雪板准确型号、线束清点、已购供电件适配和其他到货验收，不再将已关闭事项作为采购阻断。本报告不替代本机 BOM。

## 12. 来源与本地资料

已保存的新增原厂 PDF 位于 `../references/05_vendor/selection_20261022/`：

| 文件 | 内容 |
|---|---|
| [radxa_zero3w_product_brief.pdf](../references/05_vendor/selection_20261022/radxa_zero3w_product_brief.pdf) | 主控规格、SKU 与外形参考 |
| [radxa_8m219_product_brief.pdf](../references/05_vendor/selection_20261022/radxa_8m219_product_brief.pdf) | 相机规格、接口与尺寸图 |
| [rigol_dp800_datasheet.pdf](../references/05_vendor/selection_20261022/rigol_dp800_datasheet.pdf) | 台架电源系列与输出量程 |

SanDisk 旧数据表地址本轮下载返回 404，未登记为本地已下载；改保留当前原厂产品入口。网页页面可访问也不意味着其动态 SKU、收货地址库存和实际结算价均已验证。证据入口及下载哈希另见 `../90_sources/hardware_selection_manifest_20261023.json`。

[S01]: https://dl.radxa.com/zero3/docs/hw/3w/radxa_zero_3w_product_brief.pdf
[S02]: https://docs.radxa.com/en/zero/zero3/faq
[S03]: https://docs.radxa.com/zero/zero3/hardware-design/revision
[S04]: https://github.com/fanhao375/microduck-replica/blob/813639d668c1dc56bd0aa145a930bb2c9fb5986c/tools/radxa/镜像使用说明.md
[S05]: https://github.com/kissqy/Microduck-kissqy/blob/main/hardware/AMP2.0-VERSION.md
[S06]: https://github.com/kissqy/Microduck-kissqy/blob/main/hardware/IMU-FIRMWARE.md
[S07]: https://github.com/pollen-robotics/elec_RPI_Robot_HAT/blob/main/README.md
[S08]: https://github.com/fanhao375/microduck-replica/blob/813639d668c1dc56bd0aa145a930bb2c9fb5986c/README.md
[S09]: https://github.com/fanhao375/Microduck-kissqy/blob/hd1910-v167-trunk-imu-i2c/IMU-MODULE.md
[S10]: https://docs.radxa.com/accessories/camera/camera-8m-219
[S11]: https://www.raspberrypi.com/products/camera-module-3/
[S12]: https://www.st.com/resource/en/datasheet/vl53l5cx.pdf
[S13]: https://github.com/fanhao375/microduck-replica/blob/813639d668c1dc56bd0aa145a930bb2c9fb5986c/docs/电控采购清单.md
[S14]: https://www.samsung.com.cn/memory-storage/memory-card/memory-cardpro-endurance-128gb-mb-mj128ka-cn/
[S15]: https://www.sandisk.com/products/memory-cards/microsd-cards/sandisk-max-endurance-uhs-i-microsd?sku=SDSQQVR-128G-GN6IA
[S16]: https://news.samsung.com/us/samsung-announces-improved-speeds-pro-plus-memory-card-line-up?r=true
[S17]: https://support-en.sandisk.com/app/products/product-detailweb/p/9346
[S18]: https://www.hollyland.com/accessories/np-f550-battery
[S19]: https://github.com/kissqy/Microduck-kissqy/blob/main/DUCK-SHOPPING-LIST.md
[S20]: https://www.smallrigreseller.com/smallrig-np-f550-usb-c-rechargeable-camera-battery-4331.html
[S21]: https://help.deitymic.com/en/np-f550/overview-and-specifications
[S22]: https://www.nitecore.com/product/usn3pro
[S23]: https://github.com/huangjunsen0406/py-xiaozhi/blob/main/README.md
[S24]: https://www.seeedstudio.com/ReSpeaker-Lite-p-5928.html
[S25]: https://github.com/Seeed-Studio/wiki-documents/blob/docusaurus-version/sites/en/docs/Sensor/ReSpeaker_Lite/reSpeaker_lite_introduction.md
[S26]: https://github.com/haoyn231/xiaozhi_linux_rs/blob/main/README.md
[S27]: https://store.siglent.com/product/spd1168x-可编程线性直流稳压电源/
[S28]: https://www.rigol.com/dam/global/downloads/brochures/en/data-sheet/dc-powers/DP800_DataSheet_EN.pdf
[S29]: https://meters.uni-trend.com.cn/content/1301.html
[S30]: https://www.fluke.com/en-us/product/electrical-testing/digital-multimeters/fluke-17b-plus
[S31]: https://www.mitutoyo.com.br/nossos-produtos/instrumentos-de-medicao/paquimetro/paquimetro-digital-aos-cd-6-asx.html
[S32]: https://www.wihatools.com/products/precision-phillips-screwdrivers
[S33]: https://ftdichip.com/product-category/products/cables/
[S34]: https://docs.radxa.com/en/zero/zero3/accessories/pd-30w
[S35]: https://www.waveshare.com/wiki/ESP32-S3-AUDIO-Board
