xlx2730109-code/Microduck/90_archive/notes/15_方案评估与核对记录.md

# 方案评估与核对记录

目标：保存 [00 总路线](../../00_notes/00_复刻总路线.md) 之外的评估、缺件核对和差异分析，日常不需要打开。

2026-11-10 状态说明：以下为各日期的历史评估，不作为当前重复采购清单。主控已发货、IMU 已有实物、机械主体已装起；当前采购、补打数量与待验收项目以 [BOM 主表](../../00_notes/01_BOM表.md) 和 [根 README](../../README.md) 为准。旧 kissqy 采购及“不买 HUB”等决定已被后续订单替代。

## 三、步骤 0 的缺件清单

对照作者 2026-10-23 版 BOM 与本机 BOM 逐行比对，缺项如下。

| 缺件 | 作者 BOM 位置 | 本机 BOM | 处理 |
|---|---|---|---|
| HAT、躯干 IMU 板、电池触点板（banana PCB） | 外购 3、4、10，价 120、80、20 元，标“可拼团” | B016、B017、B019 | 微信群拼团，见第四节 |
| ZERO 3W 2GB 无 eMMC 带排针 | 外购 1，价 309 元 | B015 | 打开作者表中的链接核对库存；瑞莎官网页面全部选项为灰色（补货中）；万物拟态商城标现货 ¥385（K91） |
| 64GB TF 卡，另备第二张作恢复卡 | 外购 2 | B024 | 按 01 表购买 |
| IMX219 摄像头、扬声器 | 外购 11、13 | B020–B023 | 与 HAT 成套核对后补；步骤 9 才需要 |
| 2.5 mm 香蕉插头 ×2 | 外购 9 | B035 | 与触点板成套核对 |
| 自攻螺丝 M2×5/6/8、M2.5×6/8 | 外购 17–21 | B036 | 开箱清点后补缺 |
| 乐泰 243 螺纹胶 | 外购 22 | B037 | 待购 |
| M3 螺丝，长度待定 | 作者聊天截图：躯干与髋连接处用 M3，不用自攻 | B038 | 装配时按实物量长度 |
| 鞋底防滑垫 | 外购 23 | B027 | 先查套装是否附送 |

作者表中不需要购买的项：URT2 调试板（已有 Adapter A）、6×12×3 轴承（轮滑用）、V1 备选踝、合体轮胎、滚轮叶片、轴承滚轮（轮滑件）。

## 四、HAT、IMU 与触点板的获取

已决：走路线 A。

| 路线 | 做法 | 风险 | 状态 |
|---|---|---|---|
| A 拼团 | 加作者微信群，按作者表价格 120、80、20 元拼 | 发货时间由群主决定，未知；群二维码仅到 2026-10-31 有效，群满 200 人无法扫码 | **采用** |
| B 成品卖家 | 按 [02 指南 C2](../../00_notes/02_分阶段复现指南.md#c2-发给电控卖家的核对内容) 询成套已焊已刷 | 价格高，板版本须逐项核对 | A 无回复时的备选 |
| D 万物拟态商城 | 第三方商城 `wwntai.com/parts.html` 标注 imu_to_dxl 板和 banana PCB “即将上线、价格待定”，目前不能买 | 支付宝扫码转账、手填单号，未写退换货政策，卖家资质未核实 | 先跟踪，不作采购依据；见 K91 |
| C 嘉立创自制 | HAT 官方 Gerber、BOM、坐标齐全；触点板 banana PCB 有现成 Gerber 压缩包（`90_archive/references/04_alternatives/microduck-community-kit/hardware/banana_pcb/production/`），见 K94，可直接下单；旧版 IMU 板有工程、固件和 BOM | IMU 须 ST-LINK 烧录 STM32；新版三块板作者标注未打样 | 仅在 A、B 均失败时启动 |

## 五、云端自然对话与上游的关系

上游仓库（固定提交 `915ed836`）全文检索，没有语音识别、大模型或云端对话的代码；与声音相关的只有 HAT 上的 aic3104 音频芯片、官方声音包的安装步骤，以及摄像头与 ToF 的 Studio 页面。作者表中的扬声器和摄像头是硬件，对话软件不在复刻范围内。

因此“与上游一致”意味着首版不含自然对话。本地 [07 指南](../../00_notes/07_摄像头与独立云对话指南.md)和 `90_archive/references/06_voice/` 保留参考实现（py-xiaozhi 等），如需要，在步骤 10 之后作为扩展阶段单独做。

## 六、待决事项

| 编号 | 问题 | 状态 |
|---|---|---|
| Q1 | 采购路线 | 已决：路线 A |
| Q2 | 舵机型号 | 已决：HD-1910-C001；打印件与舵机均在途 |
| Q3 | ZERO 3W 来源与容量 | 待决：用作者表链接还是另寻来源；2GB 是否定稿 |
| Q4 | 是否打印作者的 0 位支架 | 待决：非必需，可加快标定；作者称仅验证了下半部 |
| Q5 | 云端自然对话是否保留为扩展阶段 | 已决：用户确认放扩展阶段，首版与上游一致 |

## 七、与官方原版的差异和风险

评估依据：官方 `pollen-robotics/microduck` 的 README，fanhao 固定源码中的 `执行器选型.md`、`HD-1910训练前数据清单.md`、README 实机记录，以及本地 [06 动作清单](../../00_notes/06_复现完整性与动作清单.md)。标“推测”的为本评估的判断，尚无实测。

### A. 硬件差异

| 项目 | 官方原版 | fanhao 飞特版 | 影响 |
|---|---|---|---|
| 舵机 | Dynamixel XL330 ×15，18 g，堵转 0.52 N·m（5V）；官方实际以 6.6–8.2 V 超压使用 | HD-1910-C001 ×15，21 g，规格书堵转约 1.47 N·m（7.4V），额定 4–8.4 V | 力矩约 2.5 倍，余量更大；满电 8.4 V 正处额定上限，无余量（推测：长期满电使用寿命需观察） |
| 整机质量 | 约 737 g（仿真值），官方 README 写约 800 g | 作者实测带电池约 806 g | 差异小；训练值 820 g，与实机差 1.7%（作者记录） |
| 躯干 IMU | 官方 `imu_to_dxl` 板，未开源 | fanhao 逆向重绘的同名板，或 kissqy 的 FT6 板；新版三块板未打样 | 这是全机最不确定的零件，板与固件版本必须与镜像配套 |
| 供电 | 电池直连舵机，板上一颗降压给主控 | 同一思路，NP-F550 直连；无电池保护板 | 走路时整机掉电已被作者遇到，靠限制转矩缓解 |
| 材料 | 官方成品件 | PLA 打印，部分件可换铝合金 | 刚度与公差依赖打印质量，需自己控制 |

### B. 软件与性能差异

| 项目 | 官方原版 | fanhao 飞特版 | 影响 |
|---|---|---|---|
| 舵机动力学模型 | 官方自己辨识 | 借用陆吾 1910 M6 参数，作者注明“不是自行辨识”；飞特官方另有一份参数，两者差异大且均未在真机比较 | 仿真与真机有差距，步态质量可能不及官方（推测）；首走够用，精细步态受限 |
| 质量与惯量 | 官方 CAD 导出 | 仍用 XL330 版仿真值，作者称后续需按实机校正 | 同上 |
| 实机表现 | 官方视频：行走、起身、坐、踢球、滚动 | 作者记录：已稳定行走；转向偏弱；偶发整机重启；脚抬得不够高会蹭地；已用 D=0、转矩限制 700 缓解 | 首走可行，动作流畅度与官方有差距（来自作者记录，非本机测试） |
| 起身与其他动作 | 官方有倒地起身、坐站、踢球 | 10 个模型都在，本机均未验证；`deployment_verified=false` | 不得假设一次摔倒能自己站起来 |
| 保护行为 | 官方有更新回滚与健康检查 | 摔倒不自动卸力，低电压不自动关机 | 须人在旁边，看到警告立即处理 |
| 整套能力 | 官方有手机应用、蓝牙、OTA 更新、目标检测、NFC、里程计等 | 镜像只含运动、Studio、相机与 ToF 页面；底图来自社区镜像转换而成 | 不具备官方的后几项能力；运行端是 fork，不要执行官方更新，会覆盖 fork（推测，更新机制未在本机验证） |

### C. 结论

1. 机械和电气方案合理：飞特舵机力矩更大、价格约为一半，是 fanhao 项目的核心取舍；其代价是软件链路里有三处借用或沿用的参数（舵机参数、质量惯量、IMU 板），因此实机表现比官方更依赖现场调试。
2. 按 fanhao 复现能做到：行走、手柄遥控、网页标定与诊断、相机与 ToF 页面。做不到或未验证：官方全套应用能力、倒地自动起身的可靠性、轮滑。
3. 最大的三个风险依次是：躯干 IMU 板的版本与固件；走路时的供电压降；ZERO 3W 批次与镜像的兼容。

## 八、本评估发现的遗漏项

| 编号 | 遗漏 | 处理 |
|---|---|---|
| G1 | ZERO 3W 有多批 PCB。作者记录 V1.12J 批（Wi-Fi 为 AIC8800DS2）用瑞莎引导起不来，需 B1 引导加 B1 设备树；镜像底图为 V1.12 板改制 | 下单前向卖家要 PCB 丝印和 Wi-Fi 模块照片；到货先用瑞莎官方镜像验证板可启动，再写 `20261023c`；保留一张官方镜像卡作恢复 |
| G2 | 无电池低压保护，也不会自动关机 | 装配期准备电池电压提示方案（如充电后测电压、固定使用时长上限），低于阈值停止；到货后核对 NP-F550 电池本体是否带保护（未验证） |
| G3 | 满电 8.4 V 贴近舵机额定上限 | 首次上电用台架电源限制电压和电流，记录满电与走路时电压 |
| G4 | 供电压降致整机掉电的缓解依赖转矩限制，镜像默认值是否已含该设置未核实 | 到货后读 `robotd.toml` 的转矩限制，记录在验收模板 |
| G5 | 15 颗中的下颚舵机（ID34）作者未验收；作者文档里旧记录的嘴 ID 为 29 | 单颗编号时按 ID34 设置，首走前单独测试开合 |
| G6 | 备件：舵机、舵盘、线束无备份；手柄兼容未验证 | 首走前不必买；开箱清点后决定是否补 1–2 个备用舵盘与线 |
| G7 | 作者的整机称重与填充率信息：尚无本机称重记录 | 装配完成后称重并填入验收模板，与作者 806 g 对比 |
| G8 | 音频：镜像里声音包指回官方，HAT 的音频芯片需特定设置，作者记录安装脚本曾因缺声卡中断 | 放入扩展阶段，到货后再核对 |

## 九、缺件总清单（2026-10-25 核对）

对照 [01 BOM](../../00_notes/01_BOM表.md) 的 B001–B038 与已登记订单。已购或在途的不列。

### A. 核心电控，决定整机能否做成

| 缺件 | B 行 | 来源路线 | 状态 |
|---|---|---|---|
| Radxa ZERO 3W 2GB 无 eMMC 带排针 | B015 | 作者表链接，或万物拟态商城 ¥385 | 未买；下单前核对板批次 |
| 机器人 HAT | B016 | 微信群拼团；官方 HAT 开源，`90_archive/references/03_official/elec_RPI_Robot_HAT/production/` 有 Gerber、BOM、坐标 | 未买 |
| 躯干 IMU 板（imu_to_dxl） | B017 | 微信群拼团；社区套件有 Gerber 与固件 | 未买；协议是否与镜像兼容待核 |
| 总线 HUB（分线分电板） | B018 | 微信群拼团；社区套件有 `dxl_hub` Gerber | 未买；容易漏，与 HAT 同样必需 |
| 系统 TF 卡 | B024 | 闪迪或三星官方店，64GB 一张 | 选购中 |
| microSD 转 SD 卡套 | B025 | 电脑有 SD 卡槽，需卡槽支持 SDXC | 待确认卡套是否随卡附送 |

### B. 首次上电与装配所需的小件

| 缺件 | 说明 |
|---|---|
| 舵机单颗调试的供电接线 | 电源已有：已购 NP-F550 电池（7.4 V，满电 8.4 V）。缺的是电池到 Adapter A 的接线：Adapter A 有 DC 5.5×2.1 插座和绿色接线端子，5–8.4 V 可用，不要接 9–12 V。banana PCB 与香蕉插头到货后，加红黑导线接到绿色端子即可；可调直流电源（可限流）为可选项，不是必需 |
| 红黑硅胶导线 18–20 AWG 与热缩管 | 触点板到 HUB 的电源线，运行电流 3–5 A，不要用细线 |
| 万用表 | 量针序、极性、电压，必备 |
| 螺丝刀与镊子、卡尺 | 先清点 B013 焊接套装和已有工具 |
| 机身承托 | 架空标定与卸力时托住机身，可自制吊带或用作者的 0 位支架 |
| M3 螺丝 | 躯干与髋连接处，长度装配时量，B038 |
| 5V USB-C 电源 | ZERO 3W 台架单独启动用，5V 2.5A 以上即可 |

### C. 到货后核对，可能需要补购

| 项目 | 核对点 |
|---|---|
| 摄像头 DECXIN 款 | 孔位能否装入头壳，排线接口能否接 ZERO 3W，系统是否识别；不行再买 Radxa 原厂款 |
| 扬声器杜邦公头 | 与 HAT 接头是否匹配，不匹配则改接线 |
| 打印件 | 是否含软下巴、软嘴（作者建议 TPU）；是否缺件 |
| 舵机线束 | 每颗舵机自带线的长度，是否需要更长的 AMP2.0 线；已购 100 mm 转接线数量待核 |
| 备用 | 备用舵盘、螺丝、线材，首走前不必买 |

### D. 不需要买

URT2 调试板（已有 Adapter A）、6×12×3 轴承（轮滑）、V1 备选踝、轮滑件、ToF（首走后再做）、BMI160（不兼容，已购待处理）。

## 十、BOM 完整性核对（2026-10-25）

BOM 不能确认完整。已与作者 2026-10-23 版 xlsx、CAD 仓库 BOM、装配 PDF 和社区套件逐项比对，以下事项未定。

| 编号 | 事项 | 依据 | 处理 |
|---|---|---|---|
| H1 | 总线 HUB 是否必需。作者 BOM 只列 HAT 和 imu_to_dxl，没有 HUB；官方 HAT 自带 3 个舵机口；`dxl_hub` 是社区套件另设计的板，fanhao 新版 HUB 未打样 | xlsx、官方 HAT 原理图、社区套件 README | 问群：作者实际整机如何连接 15 颗舵机与电池 |
| H2 | HAT 的舵机接口是官方 2.5 mm 还是 AMP2.0 2.0 mm，决定要多少转接线 | fanhao README：飞特舵机接口为 2.0 mm，官方 HAT 为 2.5 mm | 问群：拼团的 HAT 是哪一版 |
| H3 | 社区套件的 imu_to_dxl 用 GD32F303 与自有固件，与 fanhao 的 STM32G031 版不同，与 `20261023c` 镜像是否兼容未核实 | 社区套件 README | 拼团的 IMU 板必须问清型号和固件，不要自行用套件 Gerber 打 |
| H4 | 10-20 版 BOM 有电池座 ¥83，10-23 版换成 banana PCB 加香蕉插头加 AMP2.0 线；是否仍需电池座未核实 | 两版 xlsx 比对 | 看装配视频第 4 集的电池部分 |
| H5 | 舵机互连线的数量与长度；套装内 5264 转 AMP2.0 线的数量未知 | 订单未显示 | 到货清点，不足再补 |
| H6 | 打印件是否含两个 TPU 软件；是否缺件 | CAD 仓库 BOM | 到货清点 |
| H7 | 热熔螺母与压头：fanhao 的紧固件反推建议使用，作者 BOM 未列；以作者 BOM 为准，装配时发现孔座为热熔螺母位再补 | 机械采购清单 | 装配时核对 |
| H8 | 装配 PDF 只有通用步骤，没有螺丝对应表和接线；装配前舵机须先通电归中 | PDF 逐页检查 | 对照视频，逐组件现场确认 |

## 十一、XGO-Duck 对照（2026-10-25）

用户确认套装打印件是机械行者 Robo（fanhao 方案）的版本，没有问题，现有路线不变。陆吾智能 XGO-Duck 是另一套设计，资料存于 `90_archive/references/04_alternatives/xgoduck_hardware/`，只作对照。

| 项目 | fanhao 版 | XGO-Duck |
|---|---|---|
| 控制器 | Radxa ZERO 3W 加 HAT | Arduino UNO Q 加陆吾扩展板 |
| 螺丝 | M2、M2.5 平尾自攻 | M2×6 沉头自攻约 204 颗，M3×16 四颗 |
| 舵机 ID | 10–14 右腿，20–24 左腿 | 10–14 左腿，20–24 右腿，左右相反 |
| 装配资料 | 21 页 PDF，无螺丝数量 | 25 页图解，逐步标螺丝，零件不同，只供参考 |

## 十二、codex 核查吸收记录（2026-10-25）

核查原件存于 `90_sources/references/codex_意见_20261025/`。其结论与本仓库已有记录一致的部分见根 README K101；以下是此前未写入文档的要点。

| 编号 | 要点 | 处理 |
|---|---|---|
| C1 | IMU 板 ID 200 在总线读序中的位置有两种说法：fanhao 旧 IMU 固件实测排在舵机之后，kissqy FT6 要求排在 Sync Read 列表首位，且不要移植其他排队逻辑 | 拿到 IMU 板后，先问清板型与固件，再选对应运行端，不混用，对应 README T38 |
| C2 | 零位标定要分清四件事：编码器零点 `zero_raw`，关节正方向 `direction`，策略 HOME，执行器模型 `q_offset`；`q_offset` 不是实机零位，不要写进逐关节零位 | 标定时按此分开记录 |
| C3 | 首走前的关卡：读数、标定、承托上力、手柄急停、落地保持、低速首走，之后才验收普通脚底恢复，每关失败回到前一关 | 已体现在总路线阶段一 |
| C4 | 系统辨识当前不是本机结果：公开参数没有附原始数据、电压和固件；台架脚本仍指向原版舵机；若自测，先做能读回和卸力的单关节台架，拆拟合集与留出集，最后用整机闭环验证 | 列入阶段二环节 4，对应 T39 |
| C5 | 训练台打包的成果包没有部署合同文件；机器人导入要求同次导出的策略、`manifest.json`、`deployment-contract.json`，并通过 `robotd validate-policy`；成果包含 PT 和视频时可能超过导入的 64 MiB 上限 | 列入阶段二环节 7，对应 T39 |
| C6 | 自训练前提：PT 与 ONNX 数值对照、独立 HD1910 回放、运行端预检，应以一个真实小实验走通后再写成可执行步骤 | 对应 T39 |
| C7 | 称重只得总质量和分块质量，得不到惯量与重心 | 阶段二环节 3 说明 |
| C8 | 两颗 IMU 并存时，头部 HAT 上的 IMU 默认关闭，不与躯干 IMU 融合 | 到货后核对运行配置 |

codex 交接清单 F01–F17 的处理情况：F02、F11、F12、F13、F17 已处理；F01、F03、F04、F09、F10、F14 待实物到货；F05–F08、F15、F16 属阶段二。

## 十三、fanhao 与 kissqy 对比（2026-10-26）

依据：codex 交接稿（存于 `90_sources/references/codex_fanhao与kissqy对比_20261026.md`）加本地核对。本地核对三项：10 个成品 ONNX 的 SHA256 全部出现在 kissqy 发布清单中；kissqy 采购总表确实把 HAT ¥119、IMU ¥99 指向淘宝商品 1095121548583；kissqy 装机说明确实要求总电源入口并联 1000 µF 电容。

| 维度 | fanhao | kissqy | 本机取舍 |
|---|---|---|---|
| 关系 | 在 kissqy 运行程序与模型基础上增加 I²C 与总线 IMU 兼容、板端 Studio、做卡与标定流程，并结合机械行者的机械资料 | 提供飞特运行适配、配套 FT6 IMU 板、机器人与训练中控、自训模型 | 两者同源，不是两只完全不同的鸭子 |
| 成品电路板 | 自绘新版 IMU、HUB、触点板，作者注明未打样实测 | 作者店有 HAT 与 IMU 成品，AMP2.0 版 | 买 kissqy 成品 |
| 机械 | SolidWorks 可编辑文件、STEP、装配 PDF、视频 | 以 STL 与 3MF 为主 | 机械沿用 fanhao，已购打印件不换 |
| 手机操作 | 板端网页 8000 | 中控通常在电脑上运行 | 首走用 fanhao 镜像 |
| 训练 | 平地与地形行走等入口，有 GPU 短训与导出记录 | 14 类动作、35 种配方，远端队列，合同检查更完整 | 阶段二优先研究 kissqy 训练工具 |
| 现成策略 | 10 个模型与 kissqy 发布清单一致 | 同 | 步态基础相同，实物差异来自标定、IMU、供电 |
| 许可 | 镜像含模型，保留限制 | 原创部分仅限个人非商业，公司或组织用途须事先书面许可 | 若用于单位报销或科研，须向作者说明并取得授权 |

结论：不存在谁复刻得更好的定论，两者没有同条件实测数据。fanhao 强在机械与首次上手，kissqy 强在配套电路板与训练工具，本机两者结合。

采购要点：
1. 淘宝页的规格是 HAT 与 IMU TO DXL 两项，当前高亮为 HAT，¥119；IMU 按作者采购表为 ¥99，须切换规格核对；合计约 ¥218，不是套装 ¥119。
2. 主图的扬声器与整机是展示，不含在单板里。
3. 向卖家确认：板版本；IMU 是否已刷 `FT6_SYNC15_UART_IRQ_v1`，ID 200，1 Mbps；HAT 40 Pin 排母是否已焊及堆叠高度；麦克风是否附带；喇叭口为 HP1.25 2P，现有杜邦扬声器需转接；1000 µF 电容是否含；与 20261023c 镜像是否实测过。
4. 本机其他件的对应关系见交接稿第 2 节。

## 十四、kissqy 在线教程要点（2026-10-26）

来源：`kissqy.github.io/Microduck-kissqy/` 下的装配指南 `build/assembly.html`、采购页 `build/shopping.html`、中控教程 `console-guide.html` 与在线演示页。演示页用模拟数据，不能连接实机。

| 项目 | 内容 | 与本机的关系 |
|---|---|---|
| 装配六步 | 打印与准备，两条腿，躯干与电池仓，头颈与板卡，接线，上电前核对 | 步骤顺序可参考 |
| 打印件 | 缝合怪版：36 个 STL 加 1 个 3MF，第 5 盘为 TPU（左右脚底与滑轮），电池仓二选一；代打 ¥199 | 本机打印件是机械行者版，零件对不上，不能照其零件步骤装 |
| 螺丝 | 页面不给规格与数量，只说按孔位选长度 | 无参考价值 |
| ID | 右腿 10–14，左腿 20–24，头颈 30–34 | 与 fanhao 一致 |
| 接线 | 头颈为 HAT → 34 → 33 → 32 → 31 → 30 → HUB，右腿与左腿各从 HUB 出发，IMU 接 HUB 的 J1，电池接 HUB 的 CN1，HUB 自带 1000 µF 缓冲电容 | kissqy 走 HUB 分电，fanhao 作者的 BOM 没有 HUB，电池直连 HAT，两者供电接法不同 |
| HUB 采购 | 采购页没有 HUB 的购买链接与价格，写“向作者确认供货与价格”，入口是作者微信二维码；HAT 与 IMU 的淘宝商品不含 HUB | 要用 HUB 须联系 kissqy；本机目前不买，等接线表确认 |
| 5 GHz Wi-Fi | 使用无线手柄时，ZERO 须连路由器 5 GHz，2.4 GHz 会与手柄互相干扰，出现断网与 SSH 超时 | 写入首次联网步骤，手柄到货后核对 |
| 中控教程 | 十章：配网、连接、界面、关节标定、IMU 核对、HOME 与行走、手柄、摄像头、升级与关机、常见问题 | 对应 kissqy 的电脑端中控，本机用 fanhao 板端 Studio，按钮不同，只作参考 |
| 诊断 | 逐关节看实际角度、目标角度、误差、电流、温度、电压，可导出 CSV；台架模式只读，使用前须先停 robotd 并托住机器人 | 调试时可借鉴 |
