xlx2730109-code/Microduck/90_archive/notes/04_视频与外部入口.md

# 视频与外部入口

目标：按装配任务直接找到原作者演示，区分实物操作和仿真界面。

## 机械行者Robo 装配系列

原作者：[B 站账号](https://space.bilibili.com/312747174)，[合集](https://space.bilibili.com/312747174/lists/9279084?type=season)。以下 BV 地址来自固定版本的 CAD/复刻主仓；本轮网页工具无法播放 B 站页面，未声称逐段观看验收。

| 集 | 内容 | 原仓标注时长 | 入口 |
|---|---|---:|---|
| 1 | 零件清单 | 1:32 | [第 1 集](https://www.bilibili.com/video/BV1RoHX68EFV/) |
| 2 | 小腿安装 | 2:21 | [第 2 集](https://www.bilibili.com/video/BV1Xppb6tECr/) |
| 3 | 大腿安装 | 5:13 | [第 3 集](https://www.bilibili.com/video/BV1ycpb6yEwB/) |
| 4 | 躯干组件 | 2:29 | [第 4 集](https://www.bilibili.com/video/BV1Kwpg6wE9G/) |
| 5 | 颈部安装 | 0:40 | [第 5 集](https://www.bilibili.com/video/BV1EEpg6nEkD/) |
| 6 | 头部安装 | 5:50 | [第 6 集](https://www.bilibili.com/video/BV1aKpE6hEzj/) |
| 7 | 原仓未列 | — | 回到原作者合集核查 |
| 8 | 第三方整理页提到组件安装 | — | 本轮未独立取得原作者 BV 链接，不填猜测地址 |

公开合集接口本轮返回 `code=-352`，原始响应保存在 `90_sources/bilibili_series.json`。它是访问失败证据，不是已取得的完整视频清单。视频平台流媒体未离线下载；仓库自带且可公开下载的演示随仓库归档。

## 电控与软件

| 内容 | 入口 | 使用边界 |
|---|---|---|
| kissqy IMU 制作视频 | [Bilibili](https://www.bilibili.com/video/BV1qapz6PERs/) | 辅助理解焊板；实际烧录按同版硬件说明 |
| kissqy 机器人中控演示 | [在线演示](https://kissqy.github.io/Microduck-kissqy/) | 使用模拟数据，不连接用户真机 |
| kissqy 训练中控演示 | [在线演示](https://kissqy.github.io/Microduck-kissqy/training/) | 不会真正训练，也不能替代本地 GPU 环境 |
| fanhao 构建与上电记录 | [固定来源仓库](https://github.com/fanhao375/microduck-replica) | 作者样机日志，附实际边界；本机需重新标定 |
| 3D 装配浏览器 | [Ley-WL 指南](https://ley-wl.github.io/microduck-guide/) | 辅助理解组件；作者明确未逐件实机核验，不能代替 CAD 试装 |
| 官方产品介绍 | [Pollen Robotics](https://pollen-robotics.com/microduck/) | 官方整机功能不等于当前国产套件全部可用 |
| 官方控制与训练 | [运行时](https://github.com/pollen-robotics/microduck)、[RL](https://github.com/pollen-robotics/microduck_rl) | 了解架构与合同；HD-1910 必须用适配后端与策略 |

## 厂家文档

| 对象 | 原始入口 |
|---|---|
| HD-1910-C001 | [飞特型号页](https://www.feetechrc.com/510257)、[飞特 Wiki](https://ftservo.github.io/ftservo-wiki/products/models/hd-1910-c001/main/) |
| 飞特协议 | [FT-SCS](https://ftservo.github.io/ftservo-wiki/reference/protocol/ft-scs/) |
| 飞特调试板 | [适配器说明](https://ftservo.github.io/ftservo-wiki/tools/adapters/) |
| 飞特执行器辨识 | [ftservo-bam](https://gitee.com/ftservo/ftservo-bam)，本轮在线页面抓取失败，未作为已下载完整模型库 |
| 微雪 Bus Servo Adapter A | [产品](https://docs.waveshare.net/Bus_Servo_Adapter_A/)、[接线](https://docs.waveshare.net/Bus_Servo_Adapter_A/Product-Wiring-Example/)、[FAQ](https://docs.waveshare.net/Bus_Servo_Adapter_A/FAQ/) |
| Radxa ZERO 3 | [官方文档](https://docs.radxa.com/zero/zero3)、[快速上手](https://docs.radxa.com/zero/zero3/getting-started) |
| 镜像写卡工具 | [Armbian Imager](https://imager.armbian.com/)；本轮未安装或写卡 |
