xlx2730109-code/Microduck/00_notes/evidence/20261110/camera_lens_fit.png

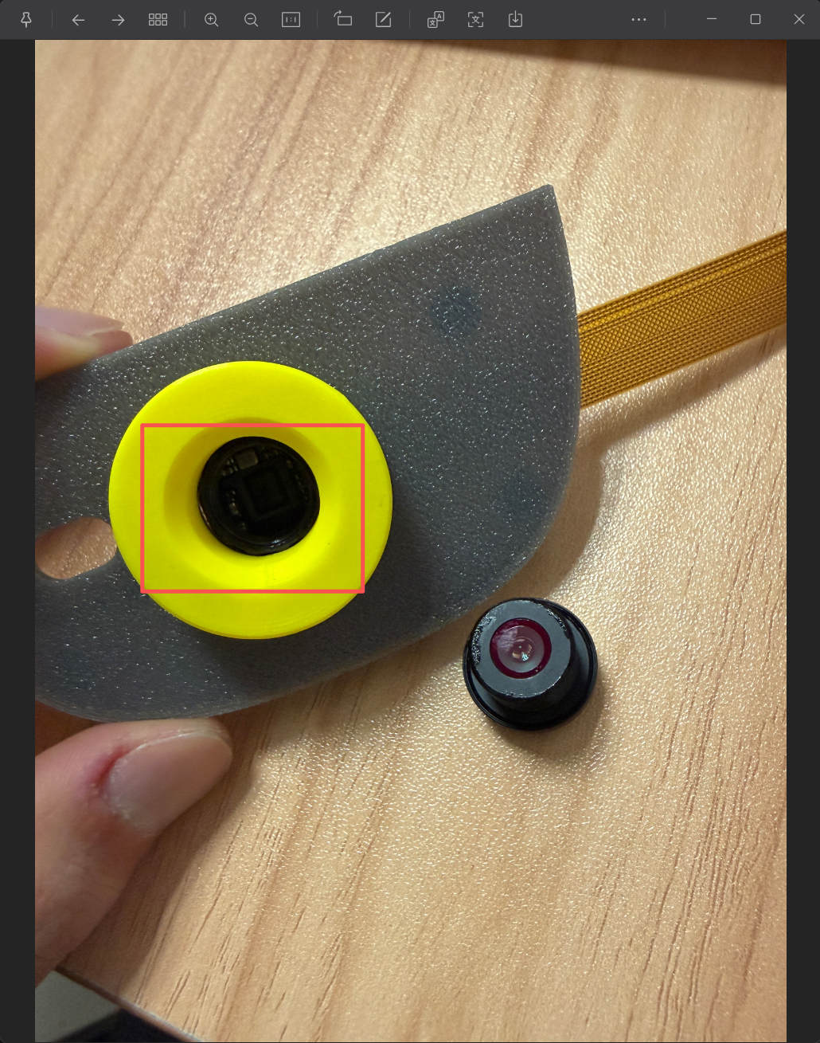
00_notes/evidence/20261110/camera_lens_fit.png
