xlx2730109-code/Microduck/00_notes/evidence/20261110/eye_facets_sw.png

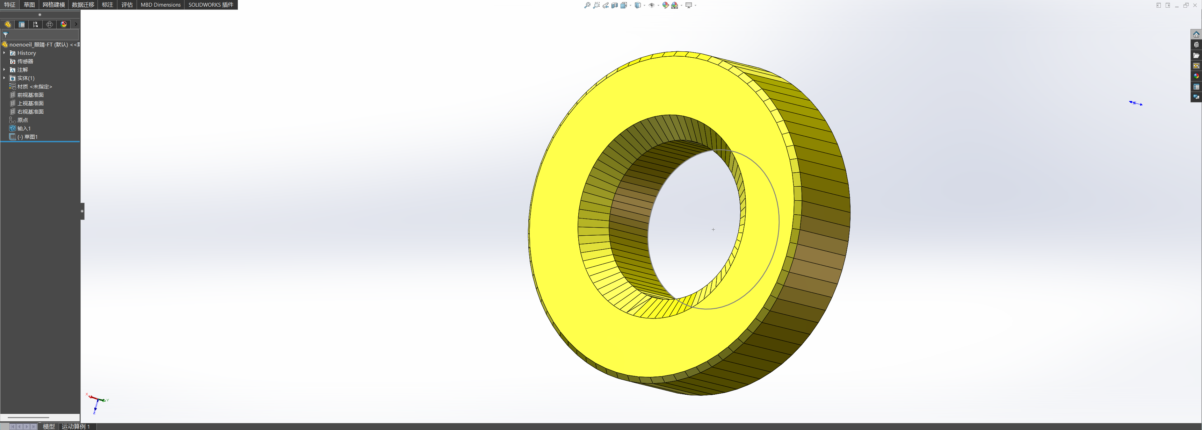
00_notes/evidence/20261110/eye_facets_sw.png
