xlx2730109-code/Microduck/00_notes/evidence/20261110/jlc_head_review.png

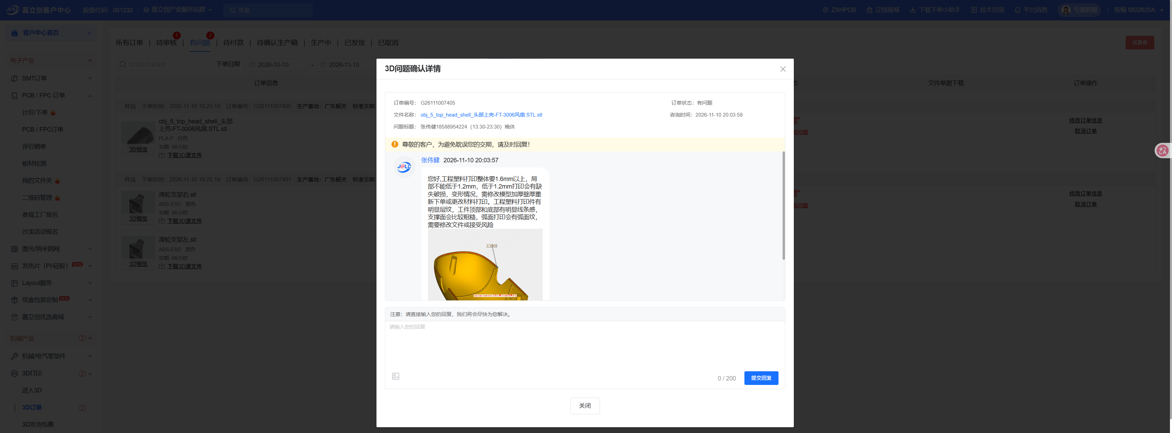
00_notes/evidence/20261110/jlc_head_review.png
