xlx2730109-code/Microduck/00_notes/evidence/20261110/zero3w_shipped.png

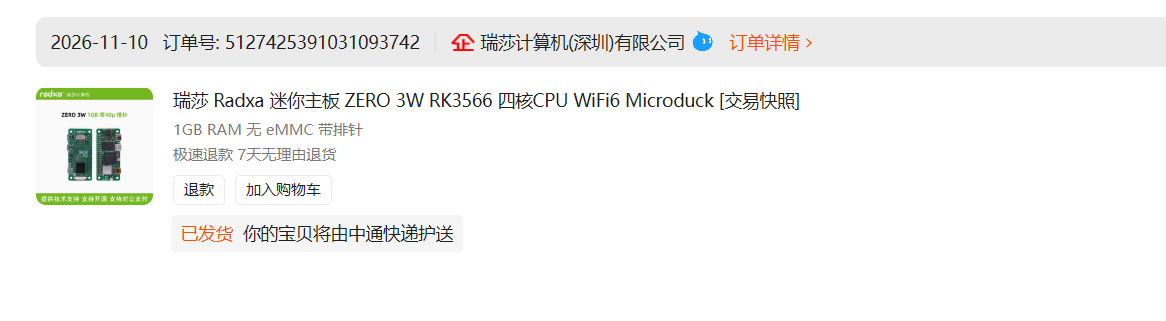
00_notes/evidence/20261110/zero3w_shipped.png
