xlx2730109-code/Microduck/01_mechanical/author_tips_20261024/chat_zero_jig_announce.png

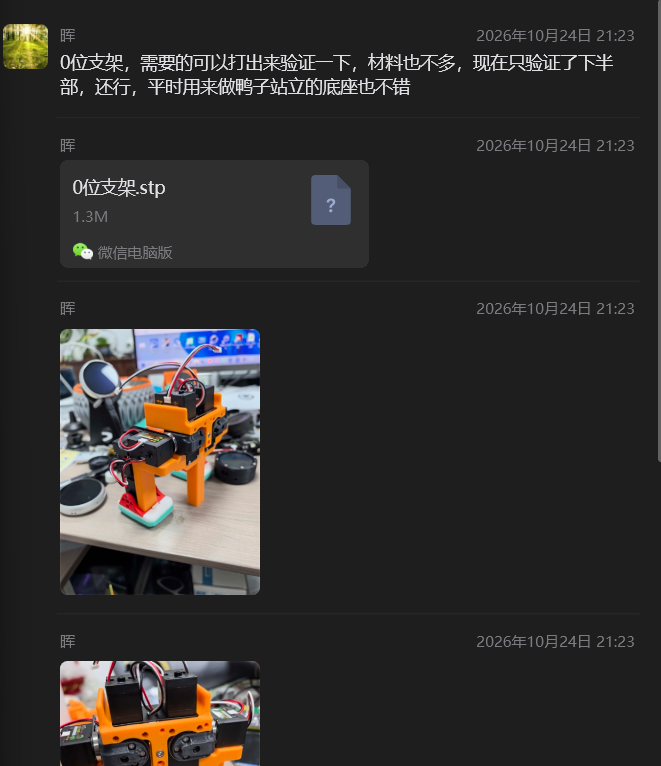
01_mechanical/author_tips_20261024/chat_zero_jig_announce.png
