xlx2730109-code/Microduck/01_mechanical/author_tips_20261024/photo_zero_jig_side.jpg

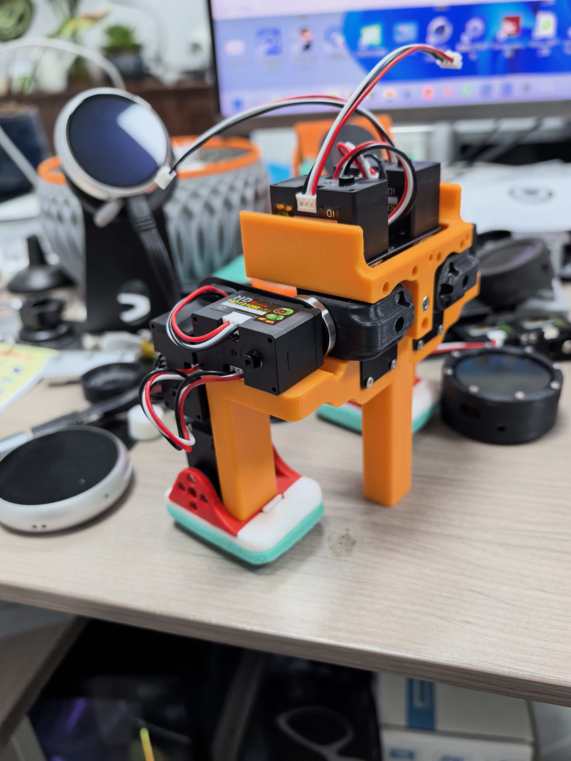
01_mechanical/author_tips_20261024/photo_zero_jig_side.jpg
