xlx2730109-code/Microduck/01_mechanical/microduck-replica-cad/组件图/01-躯干主体-爆炸图.png

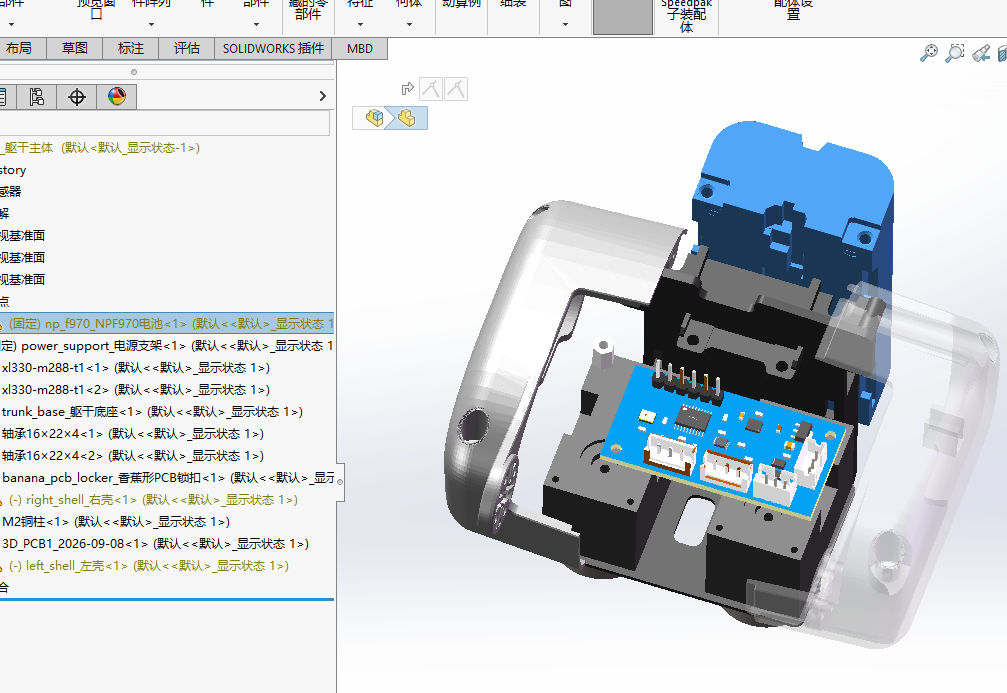
01_mechanical/microduck-replica-cad/组件图/01-躯干主体-爆炸图.png
