xlx2730109-code/Microduck/01_mechanical/microduck-replica-cad/组件图/10-头部总成爆炸1.png

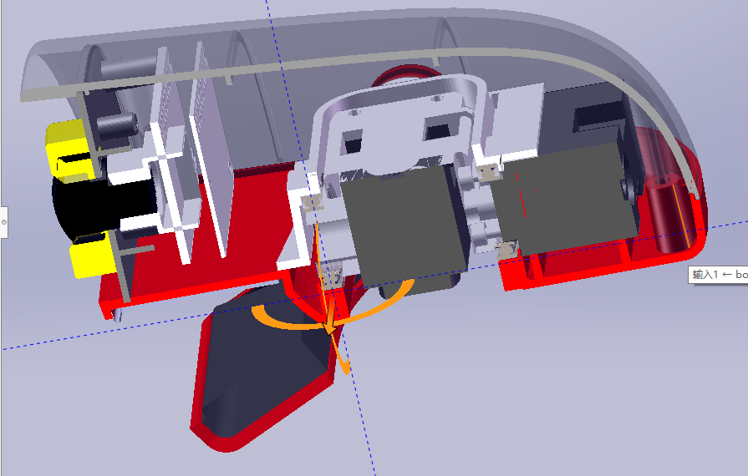
01_mechanical/microduck-replica-cad/组件图/10-头部总成爆炸1.png
