xlx2730109-code/Microduck/08_local_web/studio/web/assets/tof-vl53l5x-product.png

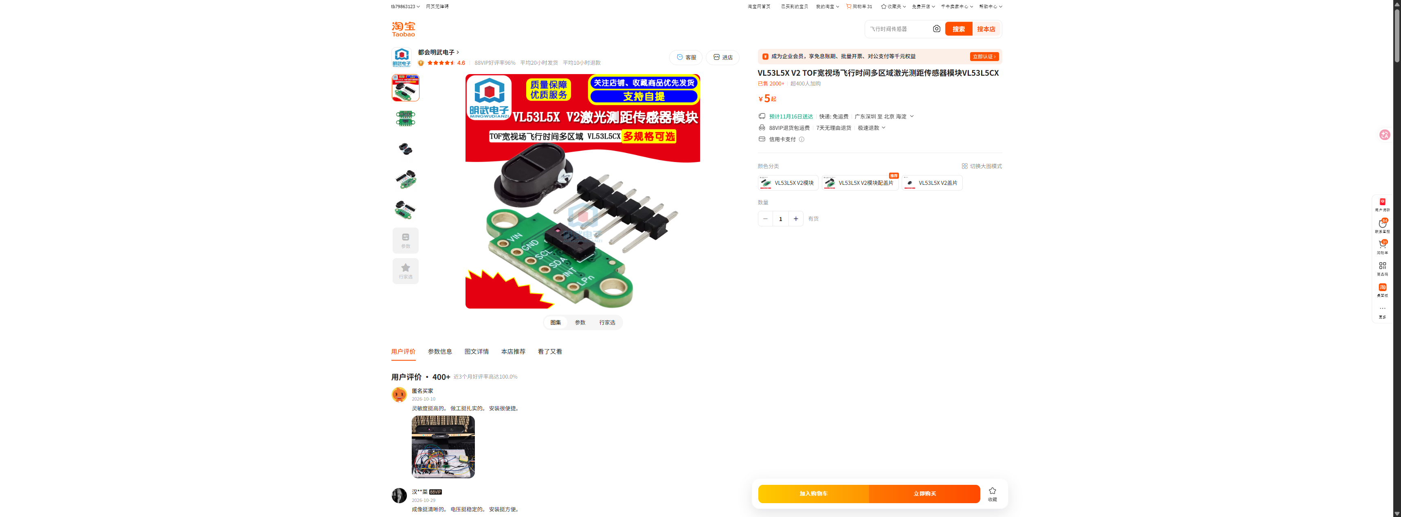
08_local_web/studio/web/assets/tof-vl53l5x-product.png
