xlx2730109-code/Microduck/00_notes/01_BOM表.md

# BOM 表

目标：统一记录本机物料、采购状态与缺件；已下单不等于已到货或通过适配验收。

最新状态：2026-11-13 ZERO 3W 已到手，插入已写好的 `20261027` SD 卡后曾成功开出 `Microduck-9c2a` 热点；校园网 `web.wlan.bjtu` 配网后访问受隔离影响，Studio 实机状态尚未验收。Adapter A V3.1 板体已由照片确认；用户确认没有图示 DC5521 电源线，绿色 DC+/DC− 端子的替代供电线也未确认。IMU 已有到手照片；HAT、HUB 与金属件适配状态仍待核。音频 B13/B14 是两种候选扬声器，首版二选一；没有单独麦克风采购记录，HAT 是否带板载麦克风和音频 codec 待实物核对。摄像头打印件未到，ToF 未焊接，均延后。原 kissqy HAT、IMU 订单已取消/退款，不重复计数。

| 序号 | 模块 | 名称 | 数量 | 单价 | 总价 | 采购链接/网址 |
|---:|---|---|---:|---:|---:|---|
|  | **一、已购（含在途）** |  |  |  |  |  |
| 1 | 舵机套装 | 飞特 HD-1910-C001 套装订单列有：舵机×15、整机打印件、轴承×14、M2 螺丝包、微雪 Bus Servo Adapter (A)、5264 转 AMP2.0 转接线；Adapter A 实物照片确认 V3.1，用户当前仅确认持有 Adapter A 板体，转接线和供电线未核 | 1 套 | 1854 | 1854 |  |
| 2 | 电池 | NP-F550 电池，国产电芯 2600 mAh | 1 | 57.80 | 57.80 |  |
| 3 | 电池 | NP-F550 电池，进口电芯 3300 mAh | 1 | 83.00 | 83.00 |  |
| 4 | 电池 | 唯卓仕 NP-F550 电池，2200 mAh，Type-C 直充 | 1 | 46.70 | 46.70 | https://item.taobao.com/item.htm?id=769425140324&skuId=5445604550341 |
| 5 | 充电器 | NP-F550 USB 单槽充电器 | 1 | 21.20 | 21.20 |  |
| 6 | 手柄 | TGZ Controller 手柄；用户确认未购买，首版先用 Studio 网页手柄/自定义网页控制，实体手柄为可选项 | 0 |  |  |  |
| 7 | 工具 | 焊接工具 6 件套 | 1 | 39.68 | 39.68 |  |
| 8 | 线材 | AMP2.0 双头转接线，100 mm，双头反向 | 4 | 2.00 | 16.00 | https://item.taobao.com/item.htm?id=1089647066599&skuId=6146736860515 |
| 9 | 线材 | AMP2.0 双头转接线，100 mm，双头同向（用于舵机之间） | 15 | 2.00 | 38.00 | https://item.taobao.com/item.htm?id=1089647066599&skuId=6146736860515 |
| 10 | 电池触点 | 2.5 mm 香蕉插头 PCB 铜镀金，13 mm，尾部 1.5 mm，U6068 | 4 | 1.60 | 16.40 | https://item.taobao.com/item.htm?id=1066300439603&skuId=6116801109787 |
| 11 | 电池触点 | banana PCB，嘉立创打样，双面板 1.6 mm，绿色，有铅喷锡 | 5 片 |  | 21.60 | https://www.jlc.com/ |
| 12 | 摄像头 | IMX219 800 万摄像头模块，DECXIN，222° 广角，含排线 | 1 | 53.80 | 63.80 | https://detail.tmall.com/item.htm?id=775872575316 |
| 13 | 音频候选 A | 扬声器，8Ω 2W，直径 20 mm，杜邦公头；与 B14 二选一，实际到货未单独核对 | 1 | 3.80 | 3.80 | https://item.taobao.com/item.htm?id=902489608878&skuId=5925223242747 |
| 14 | 音频候选 B | 扬声器 3525 腔体，4Ω 3W，自带 1.25 端子，kissqy 同款；与 B13 二选一，实际到货未单独核对 | 1 | 2.77 | 2.77 | https://item.taobao.com/item.htm?id=683920556900 |
| 15 | 轴承 | 轴承 10×15×3，NSK | 6 | 6.00 | 44.00 | https://item.taobao.com/item.htm?id=670727787832 |
| 16 | 轴承 | 轴承 16×22×4，不锈钢薄壁 ET2216 | 17 | 4.00 | 76.00 | https://item.taobao.com/item.htm?id=539024647147&skuId=5716548727712 |
| 17 | 紧固件 | 平尾自攻螺丝 M2×5、M2×6、M2×8、M2.5×6、M2.5×8，各 500 只 | 5 包 |  | 26.70 | https://detail.tmall.com/item.htm?id=534923831046 |
| 18 | 紧固件 | 乐泰 243 螺纹胶 | 1 | 15 | 15 |  |
| 19 | 脚底 | 鞋底防滑垫 | 1 | 15.31 | 15.31 | https://detail.tmall.com/item.htm?id=888852278057&skuId=5902232407790 |
| 20 | 存储 | 闪迪 Ultra 64GB microSD，A1；2026-11-12 已到货，Windows 识别约 64 GB | 1 | 75.69 | 75.69 |  |
| 21 | 工具 | 电子秤，3 kg / 0.1 g，Type-C | 1 | 13.43 | 13.43 |  |
| 22 | 结构件 | 0 位支架，3D 打印，作者提供 STEP 与 3MF（已打印） | 1 |  |  | ../01_mechanical/author_tips_20261024/ |
| 23 | 紧固件 | M3 螺丝，长度 10–30 mm，0 位支架用 | 1 套 |  |  |  |
| 24 | 电控板 | Microduck HAT 扩展板，人人可做机器人；已下单，最新收货状态、板版本与接口待核对 | 1 | 140.00 | 140.00 | 用户订单截图，2026-10-29；未提供商品网址 |
| 25 | 电控板 | Microduck IMU 姿态模块，人人可做机器人；已有到手照片，方形四安装孔、丝印 V1.0A；芯片、协议与固件待核对 | 1 | 80.00 | 80.00 | 同第 24 项订单；本会话 IMU 实物照片 |
| 26 | 电源 | 直插电解电容 1000 µF，16 V，8×16 mm，高频，20 只一包，长脚为正 | 1 包 | 4.19 | 5.69 |  |
| 27 | 传感器 | VL53L5X V2/VL53L5CX 多区域 ToF 模块；用户商品图确认已焊 2.54 mm 排针，丝印 `VIN/GND/SCL/SDA/INT/LPN`；接 HAT J5 时用 SH1.0 4P 转杜邦母线，首走后再用 | 1 | 49.50 | 49.50 | https://item.taobao.com/item.htm?id=737603917521 |
| 28 | 主控 | Radxa ZERO 3W，1GB RAM、无 eMMC、带排针；已发货，中通配送，收货与批次待核对 | 1 |  |  | 瑞莎计算机(深圳)有限公司；见 2026-11-10 订单记录 |
| 37 | 分电板 | Microduck HUB 分线板，人人可做机器人；已下单，最新收货状态、配线与电池接入待核对 | 1 | 36.00 | 36.00 | 同第 24 项订单 |
| 38 | 结构件 | Microduck 金属结构件，共 7 个，人人可做机器人；原订单保留，最新收货与安装明细待核对；CNC 另有报价，未确认成交 | 1 套 | 45.00 | 45.00 | 同第 24 项订单 |
| 39 | 运费 | 人人可做机器人本单运费，整单计一次 | 1 | 19.00 | 19.00 | 同第 24 项订单 |
|  | **二、待购（首走必需）** |  |  |  |  |  |
| 29 | 线材 | AMP2.0 3P 舵机线，20 cm，1007 24AWG，同向直通（追加，用于脖子与躯干） | 10 | 0.90 |  | https://item.taobao.com/item.htm?id=825340808235 |
|  | **三、待购（视到货核对）** |  |  |  |  |  |
| 30 | 摄像头 | Radxa Camera 8M 219，DECXIN 不适配时再买 | 1 |  |  |  |
|  | **四、选配** |  |  |  |  |  |
| 31 | 散热 | 散热片，Radxa Heatsink 5519A | 1 |  |  |  |
| 32 | 调试 | USB 转 TTL 串口模块，3.3 V，CH340 或 CP2102 | 1 |  |  |  |
| 33 | 线材 | SH1.0 4P 转杜邦母线，20 cm，5 条一包，接 ToF 到 HAT 的 J5（kissqy 同款），首走后用 | 1 包 | 4.56 |  | https://item.taobao.com/item.htm?id=895049863252 |
|  | **五、已购但本机不用** |  |  |  |  |  |
| 34 | 传感器 | GY-BMI160 加速度陀螺仪模块（2 笔订单），与本机 IMU 路线不兼容 | 2 |  | 18.20 |  |
| 35 | 轴承 | 轴承 6×12×3，轮滑用 | 8 | 0.87 | 6.97 |  |
| 36 | 传感器 | VL53L8CX 8×8 ToF 模块，33.4×10.2 mm 长板，脸壳装不下，7 天无理由退货内处理 | 1 | 77.69 | 77.69 |  |
|  | **合计** | 已登记金额，含运费；不含未填价格项，已扣除取消/退款的旧订单 |  |  | **3008.93** |  |

## 2026-10-29 订单与验收

| 项目 | 记录 |
|---|---|
| 店铺 | 淘宝：人人可做机器人 |
| 订单号 | `5127565106175002541` |
| 商品规格 | IMU 姿态模块、HAT 扩展板、HUB 分线板、金属结构件，共 4 项，各 1 份 |
| 金额核对 | 商品 ¥301，运费 ¥19，实付 ¥320；分别计入表内对应项 |
| 当日发货状态 | 2026-10-29 截图显示待发货；这是历史截图，不代表 11月10日仍待发货。IMU 后续已有实物照片，其余收货状态待确认 |
| 旧订单 | 原 kissqy 店 HAT ¥119 与 IMU TO DXL ¥99，用户确认已取消/退款；由本单替换，未重复计数 |
| 编号规则 | 保留原有物料序号，新增项续号，不因分组位置调整已有编号 |

- [ ] 核对 HAT 的 PCB 版本、40Pin 排母焊接、飞特接口规格及针序；不能直接沿用旧 kissqy 板的接线结论。
- [ ] 核对 IMU 芯片、通信协议、供电、固件版本，以及是否兼容当前镜像的 ID 200、1 Mbps 总线读取；“姿态模块”名称不能证明这些参数。
- [ ] 核对 HUB 是否含电容、配套线、电池触点，以及与已购 banana PCB、香蕉插头和 fanhao 电池仓的配合；尚不视为已补齐全部电池接入件。
- [ ] 清点金属结构件 7 个的名称、尺寸、安装位置和配套紧固件，与现有 fanhao 打印件核对；截图不构成适配验收。
- [ ] 核对发票开具情况；订单截图未显示发票信息。

## 2026-11-10 主控订单与当前装配

| 项目 | 已确认内容 | 未确认内容 |
|---|---|---|
| 主控订单 | 订单号 `5127425391031093742`，日期 2026-11-10；瑞莎计算机(深圳)有限公司；1GB RAM、无 eMMC、带排针；已发货，中通配送 | 成交价、预计到货日、收货、PCB/Wi-Fi 批次和启动结果 |
| 机械装配 | 主体已装起并放在支架上，可见脚部、腿部、躯干及上部舵机/结构；部分线束外露 | 头部最终装配、关节行程、紧固与走线验收；照片不能证明舵机 ID 或零位通过 |
| IMU | 已有到手照片，板形与部分上游长条双孔板不同 | 芯片/MCU、固件、针序、安装坐标系及本机标定 |

证据：[主控已发货](evidence/20261110/zero3w_shipped.png)、[装配照片](evidence/20261110/assembly_progress.jpg)。原图已复制归档并逐文件核对 SHA256。主控价格未知，未改已登记金额合计；未把图片上的板子或线束视为通电验收。

## 2026-11-10 补打与备料计划

| 文件/零件 | 拟打数量 | 截图所选材料/颜色 | 用途 |
|---|---:|---|---|
| mumu `obj_5_top_head_shell_头部上壳-FT-3006风扇.STL.stl` | 1 | PLA-P，白色 | 风扇上壳；风扇尺寸/孔距与实物待核对 |
| mumu `obj_1_sole_left_左脚底-FT.stl` | 2 | TPU，白色 | 装机1＋备用1 |
| mumu `obj_26_sole_left_左脚底-FT.stl` | 2 | TPU，白色 | 装机1＋备用1；与 obj_1 是镜像配对 |
| 滑轮 | 6 | TPU，白色 | 同版摆盘装机4＋备用2 |
| `滑轮支架左.stl` | 2 | ABS-ESD，黑色 | 装机1＋备用1 |
| `滑轮支架右.stl` | 2 | ABS-ESD，黑色 | 装机1＋备用1 |

合计拟打15件，来源为[打印计划截图](evidence/20261110/printing_plan.png)及用户“多打备份”的确认；尚未确认提交、付款、生产或收货，不计入已购金额。截图只勾选上壳与左支架，共3件；`obj_1` 与右支架仍为零尺寸/人工报价，提交前须确认解析与最终报价。

文件位置：mumu STL 在 `E:/LingCun/mumu-duck-3Dprint_stls/`；[滑轮鞋文件夹](../01_mechanical/roller_skates_kissqy_20261107/README.md)、[ZIP](../01_mechanical/roller_skates_kissqy_20261107.zip)。截图的 `滑轮(1).stl` 本地来源尚未核实；新提取的 `滑轮.stl` 来自 kissqy 原包，不把文件名和外形相近视为同一文件。

- `obj_1` 与 `obj_26` 网格封闭；镜像对齐最大顶点误差约0.000017 mm。文件名都含“左脚底”，但不可只重复打印其中一个来替代一对左右脚底。
- 滑轮鞋原模型为4个轮子、2个支架；本机备料数量与作者装机数量分开记录。附带的同版左右脚连接件尚未确认需要补打，与现有 v2.2 的接口待核对；623ZZ 为该版配套轴承，不能沿用原6×12×3库存认定适配。
- TPU 滑轮有作者依据；普通 ABS 上壳/支架是此前替代建议，截图实际选的是 PLA-P、ABS-ESD，不改记为普通 ABS。作者关于电池盒 PETG 的说明不能泛化成所有零件必须 PETG。

## 2026-11-10 嘉立创问题确认

| 订单 | 文件与材料 | 当前状态 |
|---|---|---|
| `G26111007405` | mumu obj_5 风扇上壳，PLA-P 白色 | 已提交，审核“有问题”；付款与是否同意风险未知 |
| `G26111007401` | 滑轮支架左、右，ABS-ESD 黑色 | 已提交，审核“有问题”；付款与是否同意风险未知 |

工程师提示：工程塑料整体厚度1.6mm以上，局部不低于1.2mm；过薄可能缺损、变形；另有层纹、线头、支撑痕与弧面纹理。支架另提示精度不足和明显收缩。这里记录的是厂方审核意见，尚未取得可独立量测的薄壁标注原图，也未完成局部厚度或成品装配验证。

处理建议：先不回复接受全部风险。保持原孔位、轴承座、卡扣与壳体结合面不变，优先评估按同版3MF摆放/切片的桌面FDM代打；若保留嘉立创路线，须先定位薄壁并复审工艺，不能仅换普通ABS、尼龙或树脂就认定解决。尚未取消订单、切换材料或修改模型。原先“尚未确认提交”的描述为计划截图时状态，本节取代这两单的提交状态；其余TPU件订单未确认。

检查纠正：封闭网格只说明几何拓扑条件，不等于通过壁厚、收缩、强度与尺寸配合的可制造性验收。后续承力支架先打一套验配，再追加备份。

问题原图：[上壳审核](evidence/20261110/jlc_head_review.png)、[支架审核](evidence/20261110/jlc_skates_review.png)。
