xlx2730109-code/Microduck/01_mechanical/original_downloads/装配BOM-机械行者Robo-2026-10-23-带采购链接.xlsx

序号 | 类别 | 名称 | 原文件名 | 材料 |  | 数量 | 单价 | 总格 | 网址
一、3D打印件（需打印）
1 | 3D打印件 | 头部上壳 | top_head_shell_头部上壳.stp | PLA |  | 1 |  | 139 | https://item.taobao.com/item.htm?from=cart&id=1083122166800&skuId=6306393642451&upStreamPrice=13900
2 | 3D打印件 | 头部下壳 | bottom_head_shell_头部下壳.stp | PLA |  | 1
3 | 3D打印件 | 面部零件 | face_part_面部零件.stp | PLA |  | 1
4 | 3D打印件 | 下巴 | jaw_下巴.stp | PLA |  | 1
5 | 3D打印件 | 软下巴 | jaw_soft_软下巴.stp | PLA | 建议改用TPU软料 | 1
6 | 3D打印件 | 软嘴顶部 | soft_mouth_top_软嘴顶部.stp | PLA | 建议改用TPU软料 | 1
7 | 3D打印件 | 眼睛 | noenoeil_眼睛.stp | PLA |  | 1
8 | 3D打印件 | 颈部 | neck_颈部.stp | PLA | 建议铝合金 | 2
9 | 3D打印件 | 颈部俯仰 | neck_pitch_颈部俯仰.stp | PLA |  | 1
10 | 3D打印件 | 躯干底座 | trunk_base_躯干底座.stp | PLA | 建议铝合金 | 1
11 | 3D打印件 | 左壳 | left_shell_左壳.stp | PLA |  | 1
12 | 3D打印件 | 右壳 | right_shell_右壳.stp | PLA |  | 1
13 | 3D打印件 | 髋部左 | hip_l_髋部左.stp | PLA |  | 2
14 | 3D打印件 | 偏航转横滚 | yaw2roll_偏航转横滚.stp | PLA |  | 1
15 | 3D打印件 | 偏航横滚运动 | yaw_roll_motion_偏航横滚运动.stp | PLA |  | 1
16 | 3D打印件 | 腿部 | leg_腿部.stp | PLA |  | 2
17 | 3D打印件 | 左上腿 | left_upper_leg_左上腿.stp | PLA |  | 1
18 | 3D打印件 | 右上腿 | right_upper_leg_右上腿.stp | PLA |  | 1
19 | 3D打印件 | 上腿加固板 | upper_leg_rigidity_plate_上腿加固板.stp | PLA | 建议铝合金 | 2
20 | 3D打印件 | 左脚 | foot_left_左脚.stp | PLA |  | 1
21 | 3D打印件 | 右脚 | foot_right_右脚.stp | PLA |  | 1
22 | 3D打印件 | 左脚底 | sole_left_左脚底.stp | PLA |  | 1
23 | 3D打印件 | 右脚底 | sole_right_右脚底.stp | PLA |  | 1
24 | 3D打印件 | 脚踝左 | ankle_left_脚踝左.stp | PLA |  | 1
25 | 3D打印件 | 脚踝右 | ankle_right_脚踝右.stp | PLA |  | 1
26 | 3D打印件 | 脚踝左(V1备选) | ankle_l_v1_脚踝左V1.stp | PLA |  | 1
27 | 3D打印件 | 脚踝右(V1备选) | ankle_r_v1_脚踝右V1.stp | PLA |  | 1
28 | 3D打印件 | 合体轮胎 | 合体轮胎.stp | PLA |  | 4
29 | 3D打印件 | 滚轮叶片 | roller_blade_滚轮叶片.stp | PLA |  | 2
30 | 3D打印件 | 电机支架 | motor_support_电机支架.stp | PLA |  | 1
31 | 3D打印件 | 电源支架 | power_support_电源支架.stp | PLA |  | 1
32 | 3D打印件 | 香蕉形PCB锁扣 | banana_pcb_locker_香蕉形PCB锁扣.stp | PLA |  | 1
33 | 3D打印件 | 轴承滚轮 | bearing_roll_轴承滚轮.stp | PLA | 建议铝合金 | 2
二、外购标准件（无需打印） |  |  |  |  |  |  |  | 0 | 网址
1 | 外购件 | Radxa Zero 3W 主控板 |  | 电子件 |  | 1 | 309 | 309 | https://item.taobao.com/item.htm?id=763812025816&last_time=1790655696&upStreamPrice=88800
2 | 外购件 | 64GB TF 卡 |  | 电子件 |  | 1 | 60 | 60
3 | 外购件 | 树莓派机器人HAT电路板 |  | 电子件 | 可拼团 github | 1 | 120 | 120 | https://github.com/fanhao375/microduck-replica
4 | 外购件 | imu_to_dxl电路板 |  | 电子件 | 可拼团github | 1 | 80 | 80 | https://github.com/fanhao375/microduck-replica
5 | 外购件 | 飞特HD1901M舵机 |  | 电子件 | 可拼团github | 15 | 95 | 1425 | https://github.com/fanhao375/microduck-replica
6 | 外购件 | 飞特舵机URT2调试板 |  | 电子件 |  | 1 | 45 | 45 | https://item.taobao.com/item.htm?id=575365901461&xxc=shop&from=cart&skuId=5435424470243
7 | 外购件 | NP-F550电池 |  | 电子件 |  | 1 | 17 | 47 | https://item.taobao.com/item.htm?id=769425140324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
8 | 外购件 | AMP2.0双头转接线 microduck 舵机线 | 调试用 | 电子件 |  | 1 | 2 | 2 | https://item.taobao.com/item.htm?id=1089647066599&skuId=6146736860515&xxc=home_recommend
9 | 外购件 | 2.5mm香蕉插头PCB铜镀金 |  | 电子件 |  | 2 | 1.6 | 3.2 | https://item.taobao.com/item.htm?from=cart&id=1066300439603&skuId=6116801109787&upStreamPrice=160
10 | 外购件 | banana PCB |  | 电子件 |  | 1 | 20 | 20 | 嘉立创
11 | 外购件 | IMX219摄像头模块 |  | 光学件 |  | 1 | 46.8 | 46.8 | https://detail.tmall.com/item.htm?id=775872575316
12 | 外购件 | VL53L8CX ToF 模块 | 名称不一样！！！！ | 电子件 |  | 1 | 49.5 | 49.5 | https://item.taobao.com/item.htm?from=cart&id=737603917521&skuId=5090650052053&upStreamPrice=4950
13 | 外购件 | 扬声器 |  | 电子件 |  | 1 | 3.8 | 3.8 | https://item.taobao.com/item.htm?ali_trackid=318_1fb351596f290624d1f838f6933a4bf9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
14 | 外购件 | 轴承 10×15×3 |  | 标准件 |  | 3 | 2.8 | 8.4 | https://item.taobao.com/item.htm?id=670727787832
15 | 外购件 | 轴承 16×22×4 |  | 标准件 |  | 11 | 3.5 | 38.5 | https://item.taobao.com/item.htm?id=539024647147&skuId=5716548727712
16 | 外购件 | 轴承 6×12×3 | 轮滑鞋用轴承 | 标准件 |  | 4 | 0.88 | 3.52 | https://item.taobao.com/item.htm?id=963037239628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
17 | 外购件 | 自攻螺丝 平尾M2×5 |  | 标准件 |  | 1包 | 3.05 | 3.05 | https://detail.tmall.com/item.htm?id=534923831046
18 | 外购件 | 自攻螺丝 平尾M2×6 |  | 标准件 |  | 1包 | 4.05 | 4.05 | https://detail.tmall.com/item.htm?id=534923831046
19 | 外购件 | 自攻螺丝 平尾M2×8 |  | 标准件 |  | 1包 | 4.05 | 4.05 | https://detail.tmall.com/item.htm?id=534923831046
20 | 外购件 | 自攻螺丝 平尾M2.5×6 |  | 标准件 |  | 1包 | 3.93 | 3.93 | https://item.taobao.com/item.htm?id=534923831046&from=cart&skuId=5947341310639&upStreamPrice=700
21 | 外购件 | 自攻螺丝 平尾M2.5×8 |  | 标准件 |  | 1包 | 2.08 | 2.08 | https://item.taobao.com/item.htm?id=534923831046&from=cart&skuId=5947341310640&upStreamPrice=700
22 | 外购件 | 乐泰螺纹胶243 |  | 标准件 |  | 1 | 9 | 9 | https://item.taobao.com/item.htm?id=1056442610986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
23 | 外购件 | 鞋底防滑垫 |  | 标准件 |  | 1 | 16 | 16 | https://detail.tmall.com/item.htm?id=888852278057&skuId=5902232407790
合计：3D打印件 33 项 / 外购件 23项 |  |  |  |  |  |  |  | 2426.88
说明： 🦆 人人都可以拥有属于自己的 MicroDuck！ 💰 项目成本说明 除 15 个舵机、HAT 板和 IMU 板 外，其余硬件成本约为 828 元。 15 个舵机、HAT 板和 IMU 板 可以通过 GitHub 项目参与拼团，也可以根据需求在 嘉立创、淘宝 等平台自行购买。 后续我们还会陆续开源 安装教程、调试教程，帮助大家更方便地完成 MicroDuck 的组装与调试。 🤖 为什么要开源？ 我们希望让更多人能够以更低的成本接触和学习 具身智能、机器人控制与强化学习。 人人都有属于自己的一只鸭子。 通过开源，我们希望和大家一起打造一个更加开放、友好的学习环境，让更多人能够动手实践，从零开始探索具身智能。 如果这个项目对你有所帮助，点个赞就是对我们最大的支持 ❤️ 也欢迎大家关注我们的 GitHub，帮忙点个 Star ⭐！ 🔗 GitHub： https://github.com/fanhao375/microduck-replica 📕 小红书：机械行者 🎵 抖音：机械行者Robo B站：机械行者Robo
