xlx2730109-code/Microduck/90_archive/notes/12_补购清单与最快路线.md

# 补购清单与最快路线

目标：补齐现有 HD-1910 套件，尽快做出独立运行、能走路、有摄像头并能联网自然对话的 Microduck。

**2026-10-24：本页现为历史参考。当前采购只看 [本机BOM](../../00_notes/01_BOM表.md)，操作只看 [fanhao执行指南](../../00_notes/02_分阶段复现指南.md)。** 以下旧R1/V167步骤不作为当前主线；主控/HAT/躯干IMU仍未购，微雪已确认为Adapter A×1。

**2026-10-23 更新：本页保留早期轻量配套方案与需求记录。当前品质优先选型、版本对比、型号和价格状态以 [硬件选型调研](11_硬件型号版本选型调研.md) 为准。新报告增加 4GB 主控优先候选、品牌电池/充电器/存储与专业工具；2GB 已测成套方案仍为备选。**

## 已确认的用户条件

2026-10-24：全部已购套装、供电、传感器与工具统一维护在 [本机 BOM](../../00_notes/01_BOM表.md)，本页不另建采购台账。新增 BMI160 不适配当前 FT6 躯干路线；VL53L8CX 有板型空间风险，不能将“已买传感器”当成已配套完成。

本机 BOM 现已扩为完整装机表：B015–B019 列核心主控/电控/反馈/取电，B020–B025 列音视频与存储，B026–B034 列配套线材与工具；以下采购建议按主表状态扣除已有或随套包含的物料。

| 条件 | 最新用户确认 |
|---|---|
| 已买 | 飞特机械套装、微雪板、供电件、BMI160、ToF 和简易焊接工具；具体数量与适配状态见本机 BOM |
| 拟购 | 主控 B015：用户框选 2GB 无 eMMC 带排针，未确认下单；4GB 同批已测款优先询价 |
| 尚未买或无已购确认 | 主控、配套 FT6 躯干 IMU、HAT/分线板、电池座/触点、TF 卡/读卡器、相机音频、万用表及台架电源；BMI160 不能抵扣躯干 IMU |
| 功能 | 首版要平地行走、摄像头、自然对话与回答问题 |
| 独立性 | 机器人运行时不依赖电脑，允许 Wi-Fi 云端 AI |
| 采购偏好 | 成品、已焊接、已烧固件，优先缩短周期，预算不设限制 |
| 现有手柄 | 历史记录为 TGZ Controller，Jetson 上验证 6 轴/13 键；Microduck 映射未测 |

轴承数量与打印件适用性已由用户确认。两款电池和单充为已购待验，微雪板型号、线束数量和其他实物验收仍待完成。以下为缺件补购与历史选型参考，不重复采购整套机械或已购供电件。

## 推荐组合

**运动主线：Radxa ZERO 3W + kissqy 配套 AMP2.0 HAT/FT6 IMU 成品 + R1/control.43/V167 + 本机标定。** 摄像头采用该复刻已有资料的 Radxa 8M219。语音先复用 HAT 音频输入输出，在本机运行 Linux 云端语音客户端，避免更换整机计算平台。

这条运动组合有社区作者实机记录。**自然对话客户端与 Microduck 的集成尚未在本机验证**，不能把“买齐零件”写成“刷卡后全部功能直接可用”。

### 第一批：可以按规格准备

链接来自作者采购清单或原厂文档；淘宝页面本轮无法读取当前 SKU、库存和成交价。不要按链接默认勾选项直接付款，先核对本表完整规格。

| 物品 | 数量 | 下单规格/要求 | 入口与依据 |
|---|---:|---|---|
| Radxa ZERO 3W | 1 | 本表原基线为 **2GB RAM、无 eMMC、已焊 2×20 排针**；新购品质选型见新报告的 4GB 条件建议；优先同批镜像验证 | [原淘宝已下架](https://item.taobao.com/item.htm?id=763812025816)、[替代入口与版本对比](11_硬件型号版本选型调研.md)、[瑞莎官方文档](https://docs.radxa.com/zero/zero3) |
| HAT＋躯干 IMU 成品 | 各 1 | **kissqy AMP2.0 飞特版**，HAT 已焊；IMU 为 **STM32G031F8P6＋LSM6DSV16X**，已刷 **FT6_SYNC15_UART_IRQ_v1**，配 V167/control.43；要求卖家出厂验证 | [作者提供的成品入口](https://item.taobao.com/item.htm?id=1095121548583)、[AMP2.0 工程说明](../../02_feetech/Microduck-kissqy/hardware/AMP2.0-VERSION.md)、[FT6 说明](../../02_feetech/Microduck-kissqy/hardware/IMU-FIRMWARE.md) |
| 总线分线/电池触点成套件 | 1 套 | 匹配本套打印件的 HUB、banana/电池触点 PCB、铜触点、固定与供电线；与 HAT/IMU 同卖家成套核对，不能只买空 PCB | [机械 BOM](../../01_mechanical/microduck-replica-cad/BOM/装配BOM-机械行者Robo-2026-10-20-带采购链接.xlsx)、成品卖家配套确认 |
| NP-F550 电池与充电器 | 见 BOM B008–B010 | **已购，先验收，不按旧建议重买双充套装。** 核对电压、尺寸、放电能力和充电器适配 | [已购 BOM 与证据](../../00_notes/01_BOM表.md)；[原作者历史采购款](https://item.taobao.com/item.htm?id=585415365001)仅作参考 |
| microSD | 2 张 | 正规 **64GB 高耐久 A1/A2**，一张工作一张备份；不是只买容量无品牌卡 | 作者镜像/存储方案；可在品牌官方店选择 |
| USB 读卡器 | 1 | 可靠 USB3.x、支持 microSD；与电脑接口匹配 | 镜像写卡必需 |
| Radxa 8M219 摄像头 | 1 | **瑞莎 8M219/IMX219 800 万**，配 ZERO 3W 的 **22Pin/0.5mm CSI 排线**；让卖家确认排线触点方向和打印面板孔距 | [作者采购入口](https://item.taobao.com/item.htm?id=768918125679)、CAD 的面部 FT1 改孔距说明 |
| 扬声器 | 1 | **3525 腔体、4Ω/3W**，为 AMP2.0 HAT 配 **HP1.25 2P 已压好端子线**；体积匹配头部 | [作者采购入口](https://item.taobao.com/item.htm?id=683920556900)、AMP2.0 音频接口说明 |
| 麦克风/音频线束 | 1 套 | 要求 HAT 卖家提供**与其板卡模拟音频接口匹配、已接头并测过录音**的方案；确认板载 MEMS 是否足够，是否另配外置麦克风 | HAT 音频原理图和卖家成品范围；不能自行替换为 INMP441 等 I²S 数字麦克风 |
| AMP2.0 舵机/电源成品线 | 按卖家整套 | 要求随 HAT/IMU/HUB 配齐所需长度与分支，核对针序；已有调试转接线不等于整机线束齐全 | [作者线材入口](https://item.taobao.com/item.htm?id=825340808235)、两版接口工程 |
| 防滑脚底材料 | 一对脚 | 与现有脚掌配合的硅胶/防滑垫；厚度、质量登记，先不改轮滑 | [原 BOM 采购入口](https://detail.tmall.com/item.htm?id=888852278057) |
| 主控台架电源与 USB-C 数据线 | 各 1 | ZERO 3W 原厂要求的稳定 **5V/2A 或更高供电能力**电源；数据线支持通信。板端双电源并联关系另核对 | 瑞莎官方供电要求 |
| 散热片/绝缘固定材料 | 1 套 | 匹配 ZERO 3W 和现有头壳空间；不挡接口，不把金属件压到 PCB；先静态测温再决定风扇 | 社区过热记录与 v2.2 散热孔变更 |

**主控选 2GB 的理由**：运动镜像与作者样机有明确参照，云端对话无需在本机放大模型。若卖家只提供已测的 4GB 套装，也可以作为候选，但须拿到其板卡修订和同版镜像验证信息；增加 RAM 不等于相机、音频和引导自动兼容。

### 第二批：工具与备件，减少装配等待

| 物品 | 数量 | 用途/规格 |
|---|---:|---|
| 数字万用表 | 1 | 通断、直流电压，可靠品牌成品；用于查转接线与 5V/电池分支 |
| 可调限流直流电源 | 1 | 0–15V 或更宽范围、约 10A 级输出、CC/CV、过压保护、显示电流；这不是 15 舵机同时堵转的供电承诺 |
| 精密螺丝刀/六角、镊子、卡尺 | 各 1 套 | 适配 M2/M2.5 舵机与结构件；不买一把大号螺丝刀硬拧 |
| 标签、热缩管、绝缘胶带、理线材料 | 1 套 | 标记 ID、保护接头和管理活动线束 |
| 小型软吊带/机身承托支架 | 1 | 架空标定、HOME 和卸力验收 |
| 同批 HD-1910-C001 备用舵机 | 1–2 | 可选加速备件；同型号、同固件；不把新舵机参数默认当作已标定 |
| 原装 Xbox 蓝牙手柄 | 1 | **可选备份**：官方文档有接入记录，避免 TGZ 映射不兼容拖延；现有 TGZ 先做输入核验，不要求立即淘汰 |

已有简易焊接工具登记为 BOM B013，可作备工具；不因买了工具就改成自焊电控。当前不追加 ST-LINK、进阶焊台或一堆裸电子元件，目标仍是已焊、已刷、已测的成品。也暂不购新轮滑件、另一套打印件、大型 Jetson、树莓派 5 或不同舵机。

## 下单前发给成品卖家的配套要求

以下可复制给卖家询问，**本轮没有代用户发送消息**：

> 我要配现有 15 个 HD-1910-C001 飞特 Microduck 打印套件，现有微雪调试板。请提供免焊完整电控配套：Radxa ZERO 3W（2GB 无 eMMC、带排针）、AMP2.0 HAT 成品、已刷 FT6_SYNC15_UART_IRQ_v1 的 STM32G031F8P6＋LSM6DSV16X 躯干 IMU、适配打印件的总线 HUB 和电池触点/电池座组件、整机成品线束。请明确支持的系统镜像、V167/control.43、主控 PCB/Wi-Fi 修订、每块板版本及接口针序。首版需要瑞莎 8M219 摄像头、麦克风录音与 4Ω3W 扬声器，请配好对应 CSI 排线和 HP1.25 音频线，给出录放音与摄像头已测证明。请说明缺少哪些打印件/结构件、是否适配我现有打印版本，不能只发空 PCB 或未烧录 IMU。请把具体型号、数量和出厂测试项目写在清单中。

卖家样机标定只作为参考，不写成用户本机已校准。若卖家无法提供对应版本与接口说明，不能为了“现货”混买不明版本板卡。

## 自然对话：软件路线与硬件边界

| 方案 | 已找到的能力 | 当前判断 |
|---|---|---|
| Linux Rust 小智客户端 | [xiaozhi_linux_rs](https://github.com/haoyn231/xiaozhi_linux_rs)：AArch64、无界面运行、ALSA 录放音、云端 STT/TTS/WebSocket、MCP | 适合先核对轻量板端对话；作者没有列 Radxa ZERO 3W＋本 HAT 的实测，也不内置离线唤醒/AEC |
| Python 小智客户端 | [py-xiaozhi](https://github.com/huangjunsen0406/py-xiaozhi)：ARM/Linux、CLI、视觉工具与离线唤醒 | 备选；README 推荐内存至少 4GB，不能未经实测就承诺本机 2GB 全功能运行 |
| 独立 ESP32-S3 小智音频模块 | [xiaozhi-esp32](https://github.com/78/xiaozhi-esp32)：云端语音、部分板卡支持 AEC/唤醒/摄像头 | 后备方案；若需要则买已适配完整成品，增加板卡前先核对尺寸、重量、供电和麦克风/喇叭占用，不先堆板 |
| DuckBuddy | [项目](https://github.com/Animan-AI/DuckBuddy)：离线语音识别/视觉/行为集成参考 | 用不同主控和 HL-2915，不直接覆盖本机 HD-1910 运动固件 |

自然对话第一轮验收顺序：HAT 录音 → 播放 → 本机云端对话 → 回声/打断与唤醒 → 摄像头出图 → 需要时让对话调用相机。**能看视频和能理解画面是两个功能**，视觉问答需额外接入相机工具与支持图像的云模型。

运动仍由原 `robotd` 管理，语音进程不得直接写舵机总线。需要语音动作时，通过受限接口请求已验证动作；手柄与停止控制优先。本轮没有编写或部署该集成。

## 最快实施顺序

1. 并行准备电控成套件、电池与存储、相机/音频、工具。先向同一卖家确认接口与打印适配，减少跨店板卡版本组合。
2. 到货后在桌面先测主控启动、相机、录放音和总线身份；这些可在机械装配完成前核对。
3. 按既定飞特方案完成舵机与 IMU 本机标定、架空 HOME/卸力，再做短时首走。
4. 云端对话独立进程接入，不改动已通过的运动控制基线；先完成自然对话，再接图像工具与语音动作。
5. 保存能复现的固件/镜像/模型/标定/接线及实物照片。交付物以本机验证结果更新，不以商品宣传推定通过。

没有给出“几天必定完成”的承诺：发货、打印件版本、成品板兼容、音频全双工和语音集成是实际工期变量。优先成品和单一配套路线，是本轮减少这些变量的措施。
