xlx2730109-code/Microduck/90_archive/notes/14_BOM依据与采购记录.md

# BOM 依据与采购记录

目标：保存 [01 BOM](../../00_notes/01_BOM表.md) 的选型依据、采购订单记录和已核实的适配判断，日常不需要打开。

## 旧编号

正文中的 B001–B038 是旧 BOM 编号，现 BOM 表已重新编号，不再对应，按名称查找。

## 模块用途与连接关系

| 链路 | 对应物料 | 负责什么 |
| --- | --- | --- |
| 主控与系统 | B015＋B024 | ZERO 从系统卡启动，运行策略、相机和云语音客户端；训练在电脑/服务器进行 |
| 整机供电 | B008/B009 → B019 → 配套 HAT/HUB 电源分配 | 电池通过触点取电；配套降压供主控稳定 5V，舵机使用匹配的供电分支 |
| 关节控制 | ZERO → B016 总线接口 → B018/B026 → B001 | 主控下发动作并读取反馈；HAT/HUB 不是另一个训练主机 |
| 躯干姿态反馈 | B017 → 飞特总线 → B016 → ZERO | 躯干 IMU 提供机身姿态/角速度；HAT 的头部 IMU 不能直接顶替 |
| 真实画面 | B020 → B021 → ZERO CSI | 摄像头采集画面，视频预览与视觉问答分别联调 |
| 自然对话 | B023 → HAT 音频 → ZERO 客户端 → Wi-Fi 云端 → B022 | 录音、请求云服务并播放回答，不依赖调试电脑常开 |
| 可选测距 | B014 → 匹配 I²C 接口 → 主控 ToF 服务 | 多区测距；先解决板型、线序和供电，首走不依赖此模块 |
| 舵机台架调试 | 电脑 → B006/B007 → 单颗 B001 | 初始读取、配置与编号；微雪 USB 板不计为已买 HAT |

以上是功能关系，不是逐针接线图。实际针序、电源分支、端口及共地方式按最终 PCBA 与线束图核对。

## 主控拟购判断

用户在 P5 框出 **2GB、无 eMMC、带排针**，与 ZERO 3W 运动路线相符；尚无订单，记为拟购。对首版相机和云对话并发目标，优先询价同批已测的 4GB 无 eMMC 已焊排针版，这是内存余量建议，未做本机性能比较；若 2GB 有完整成套验证和更快交付，可保留并用轻量客户端实测。

原厂 SKU 分别为 2GB 的 `RS107-D2E0H1W15` 与 4GB 的 `RS107-D4E0H1W15`，依据 [原厂规格书](https://dl.radxa.com/zero3/docs/hw/3w/radxa_zero_3w_product_brief.pdf)。[py-xiaozhi 文档](https://github.com/huangjunsen0406/py-xiaozhi)推荐至少 4GB，属于客户端配置建议，不是已测 ZERO 性能门槛，也不能保证买 4GB 即完成语音集成。

P5 的选项呈灰色，底部写“补货中，批量100个以上请联系客服”，显示价 ¥888；仅凭截图不能确认可售库存、个人起订量或该配置真实报价。先取得 2GB/4GB 分别的实价、零售库存、交期、PCB/Wi-Fi 实物信息与已测镜像。主图没焊排针也不能代替所选 SKU 的信息，须取得实际发货的已焊排针照片。

可发给卖家核对：

> 我要给飞特版 Microduck 配 Radxa ZERO 3W，无 eMMC、40Pin 排针已焊好。请分别报 2GB 和 4GB 的单块实价、零售库存和发货时间；页面 ¥888 是否对应我框出的配置？请给实际板卡正反面、PCB 丝印和 Wi-Fi 模组照片，并说明与 kissqy R1/control.43 或其他哪套 Microduck 镜像验证过启动、无线和摄像头。不是仅附送未焊排针，也不要换 ZERO 3E 或其他板卡。

## 外部采购建议的复核

结论：可按本表选定的第二张方案继续核对成品配套，**不能照第一张聊天截图整套下单**。截图中的“复制搜索词就不会买错”不是版本兼容证明；BoBoMaker 店名也不是可唯一核对的 PCB/固件型号。若卖家提供另一套完整软硬件，应先取得实际板号、IMU 位置/协议、运行固件和整机测试证据，再作为独立方案比较。

| 第一张截图的说法 | 本机采用的判断 | 处理 |
| --- | --- | --- |
| HAT 自带机身 IMU，所以不用额外躯干 IMU | 当前官方配置将 HAT 的 BMI088 归为头部 IMU；本机 FT6 躯干反馈另有独立板 | B016 HAT 与 B017 躯干 IMU 分开列，不能用头部反馈顶替躯干姿态 |
| 再买一个头部 BMI160，直接插 I²C，不改线/固件 | 当前归档未发现 BMI160 路径；I²C 接口相同不代表驱动、板型、针序相同，BMI160 也不等于 BMI088 | 不继续按该说法购买，已购 B012 按退货或开发备件处理；不计为直接可用头部模块 |
| 只买 2GB，拒绝 4GB/8GB 和一切 eMMC 版 | 2GB 是有效运动基线；相机与云语音并发可以优先考虑同批已测 4GB。eMMC 是存储选项，不等于必然不兼容 | B015 记录用户拟选 2GB 与 4GB 条件建议，不将容量建议变成已购事实；SD 卡路线仍为当前优先 |
| 裸板、不要散热片，保证插上就用 | HAT 直插需要已焊排针；散热取决于头壳空间和实际温度 | 核对实物排针、间隙和热表现，不凭一句“裸板”买成缺排针版本，也不提前排除散热 |
| NP-F550 电池仓按 6V 供电 | 电池端、舵机端与主控端是不同分支；ZERO 官方只支持 5V 输入，电池与降压须看真实铭牌和配套设计 | 不把全机统一接成 6V，不将电池端直接接主控 5V；到货按供电流程验收 |
| 摄像头只看 IMX219、155°广角，ToF 只看 VL53L8 | 芯片名/视场不保证模块孔位、镜头高度、排线与系统驱动；ToF 长板已有尺寸风险 | 摄像头按 B020/B021 具体板型核对，ToF 按 B014 实物尺寸决定，不仅按搜索词下单 |
| 3W 扬声器即可，其他按通用轴承/螺丝列表补齐 | 录音、功放/阻抗、音频接口与云客户端也要匹配；轴承和打印件已有明确确认 | 依本机 B 行查缺，不因通用截图追加轴承/螺丝或漏掉麦克风链路 |

来源：[用户提供的外部建议截图](../../90_sources/references/20261024_external_shopping_advice.png)仅作待核参考，不当成订单或已验证教程；[官方头部 IMU 配置](https://github.com/pollen-robotics/microduck/blob/main/deploy/robotd.toml)、[FT6 说明](../../02_feetech/Microduck-kissqy/hardware/IMU-FIRMWARE.md)、[fork 支持列表](../../02_feetech/Microduck-kissqy-imu-fork/IMU-MODULE.md)与 [ZERO 供电要求](https://docs.radxa.com/en/zero/zero3/getting-started/preparation)用于核对当前方案。未取得截图所指具体 BoBoMaker 板的完整规格和固件，不推断该店所有产品均不兼容。

## 备选来源：万物拟态商城

第三方商城 `wwntai.com/parts.html`，2026-10-24 读取页面，价格与库存以官网为准，本机未下单。付款为支付宝扫码转账并手填单号，页面未写退换货政策，卖家资质未核实，下单前先向客服问清。依据见根 README K91、K92。

| 对应 B 行 | 商城商品 | 商城价 | 对照 |
| --- | --- | --- | --- |
| B015 | Radxa ZERO 3W 2GB 无 eMMC 带排针，标现货 | ¥385  | 作者表链接价 ¥309，瑞莎官网页面全灰；三处均未核实库存 |
| B020 | Radxa Camera 8M 219，标现货 | ¥180  | 作者表 IMX219 为 ¥46.8，是否同款未核实；本表要求原厂板型 |
| B022 | 扬声器模组，标现货 | ¥5.9  | 规格未写，须与 HAT 接头核对后再买 |
| B003、B004、B027、B036、B037 | 标准件套装，标现货 | ¥99 | 含 16×22×4 ×11、10×15×3 ×3、6×12×3 ×4、M2 与 M2.5 自攻螺丝各规格、乐泰 243、防滑垫；与作者 BOM 对应项一致 |
| B016、B017、B019 | imu_to_dxl 板、banana PCB 与香蕉插头 PCB | 待定 | 标“即将上线”，目前不能买；商城的 HAT 只有 ZERO 3E PoE HAT，与本机无关 |

## 2026-10-24 补购订单

用户按作者 BOM 在淘宝补购，截图见 `90_sources/purchases/`，数量和实付价未显示，不登记金额。

| 订单 | 商品与规格 | 状态 | 对应 B 行与待核事项 |
| --- | --- | --- | --- |
| P7 | 唯卓仕 NP-F550 电池 1 个 | 待发货 | 与 B008、B009 是不同商品，三款电池分别验收 |
| P7 | AMP2.0 双头转接线，100 mm，双头反向 | 待发货 | B007；数量未显示，作者表标注为调试用 |
| P7 | 2.5 mm 香蕉插头 PCB 铜镀金，13 mm，尾部 1.5 mm，U6068 | 待发货，预计后天送达 | B035；规格与作者推荐一致，数量待核 |
| P7 | DECXIN 树莓派 Pi5 IMX219 800 万摄像头，222° 广角镜头加排线 | 待发货 | B020；非 Radxa 原厂，须核对与头壳孔位和 ZERO 3W 的兼容 |
| P8 | 8Ω 2W 扬声器，直径 20 mm，杜邦公头 | 待发货 | B022；须核对与 HAT 接头 |
| P8 | NSK 10×15×3 轴承 | 待发货 | 套装已含小轴承 3 个，这笔为备份 |
| P8 | 16×22×4 不锈钢薄壁轴承 | 已发货 | 套装已含大轴承 11 个，这笔为备份 |
| P8 | 6×12×3 轴承 | 已发货 | 轮滑用，普通脚底不需要 |
| P9 | 自攻螺丝 M2×5、M2×6、M2×8、M2.5×6、M2.5×8 各 500 只 | 见订单 | B036 |
| P9 | 鞋底防滑垫 | 已发货 | B027 |
| P10  | 闪迪 Ultra 64GB microSD，A1，裸卡加卡盒 | 待发货，预计 10 月 28 日送达 | B024；店铺名未见，到货后须测容量；不一定带 SD 卡套，B025 待核 |

截图中未见：乐泰 243 螺纹胶、TF 卡、ZERO 3W、M3 螺丝，以及 HAT、IMU 板。

## 采购证据与记录规则

| 证据 | 内容 | 日期与边界 |
| --- | --- | --- |
| P0 | 首轮商品截图 `00113830327b83ac61582d0a7be84ccf.png` 与用户早期回复 | 原文件于 2026-10-24 检查时已不在原位置；历史大小/哈希保留在文件清单；新证据见 P1，不累加成新订单 |
| P1 | [选中 HD-1910-C001 套装截图](../../90_sources/purchases/20261024_hd1910_c001.png) | 2026-10-24 用户确认已购；页面价 ¥1,826.55、优惠前 ¥1,845，不是实付证明 |
| P2 | [电池和 USB 单充订单截图](../../90_sources/purchases/20261024_npf550_orders.png) | 下单日期 2026-10-24；三条均显示已揽件，未确认到货；不在正文重复完整订单号 |
| P3 | [GY-BMI160 与焊接工具订单截图](../../90_sources/purchases/20261024_bmi160_solder_orders.png) | 下单日期 2026-10-24；两条显示已揽件 |
| P4 | [VL53L8CX 与另一笔 GY-BMI160 订单截图](../../90_sources/purchases/20261024_vl53l8cx_bmi160_orders.png) | 下单日期 2026-10-24；两条显示已揽件；BMI160 订单号与 P3 不同，按两笔登记 |
| P5 | [ZERO 3W 主控候选截图](../../90_sources/purchases/20261024_zero3w_candidate.png) | 2026-10-24 用户拟购；框出 2GB 无 eMMC 带排针，非订单或可售库存证明 |

以后登记保留物料型号/选中 SKU、数量、采购日期、店铺、用户提供的链接或截图、实付价和状态；看不到的字段留待补，不生成商品链接、价格或检测结果。发现已购物料不匹配时，主动说明影响和补救，并更新对应 B 行。

## 已购供电件的适配判断

| 项目 | 当前判断 | 到货后核对 |
| --- | --- | --- |
| 电池类型 | 选中 SKU 为 F550，未见明确误买 F970；商品“适用 Sony”不作为索尼原厂身份 | 电池完整型号、额定/充电电压、端子极性和电池仓配合 |
| 两种电芯规格 | 仅能确认商家区分国产/进口与标称容量，不能凭容量判断品质或峰值负载能力 | 两款分别记录实物尺寸、质量、连续/峰值放电和保护限流说明，之后验证负载压降 |
| 单槽 USB 充电器 | 已购件优先核对；没有依据仅因它不是原先推荐品牌就要求退换 | 完整型号、输入/输出电压电流、与两款电池的适配及充电表现；USB 输入与电池端输出不能混为同一电压 |
| 上机状态 | 已下单不等于供电验收通过；暂未发现足以要求立即退换的型号错误 | 两款电池分别验收，不混写为同一批已验证基线；单充逐块充电，不等于双槽设备 |

原厂通用说明可参考 [JJC NP-F 系列 USB 双充规格](https://www.jjc.cc/index/goods/detail.html?id=403)，其中输入与电池端输出分开标注。它不是 B010 的规格书，不能据此替已购充电器填写电压、电流或兼容结论。本轮未取得 B008–B010 对应完整原厂规格，实际参数待实物/卖家资料。

已购两款电池和单充先进入验收，不重复采购报告中的备选品牌。电池座、触点板、固定件和机器人供电线仍须补齐或核对套装是否包含，充电器不能代替这些取电部件。

## 已购传感器与工具的适配判断

| 物料 | 是否满足当前复现方案 | 判断与处理建议 |
| --- | --- | --- |
| B012 GY-BMI160 | **不能直接替代当前躯干 IMU** | FT6 配套板为 STM32G031F8P6＋LSM6DSV16X；归档 I²C fork 只列 BNO085/086 与 LSM6DSV16X，没有 BMI160 路径。若专为小鸭购买，建议退货；若保留，则作为独立开发备件，不为首版增加驱动/姿态适配工作 |
| B014 VL53L8CX | **芯片受支持，板型未确认适配** | 截图为长条带安装耳模块；作者记录常见长板装不进默认脸壳。先取得卖家外形、孔距和镜头位置；如与现有脸壳不符，换兼容短板型或作为台架备件，不为可选 ToF 阻塞首走 |
| B013 简易焊接工具 | 可作备工具，不改变成品配套路线 | 未见明确型号冲突；清点实际 6 件内容后再判断缺项。不据商品缩略图认定有精密温控能力，也不据此要求自焊 HAT/IMU |

依据与边界：

- [FT6 硬件/固件说明](../../02_feetech/Microduck-kissqy/hardware/IMU-FIRMWARE.md)与 [I²C fork 支持列表](../../02_feetech/Microduck-kissqy-imu-fork/IMU-MODULE.md)说明当前可用躯干链路；[Bosch BMI160 原厂手册](https://www.bosch-sensortec.com/media/boschsensortec/downloads/datasheets/bst-bmi160-ds000.pdf)说明 BMI160 的 I²C/SPI 芯片接口，不能等同带 STM32 和 FT6 协议的总线板。BMI160 与 HAT 资料中出现的 BMI088 也不是同一器件。
- 当前归档 [ToF 驱动](../../02_feetech/Microduck-kissqy/microduck-hd1910/firmware/tof/src/sensor.rs)支持 VL53L5CX 和 VL53L8CX；不是因为 L8CX 芯片不受支持而建议核对外形。
- 作者 [踩坑记录](../../02_feetech/microduck-replica_20261024/踩坑记录.md)与 [采购清单的 ToF 板型比较](../../02_feetech/microduck-replica_20261024/docs/电控采购清单.md)记载：其常见 L8CX 模块约 33.4×10.2mm、孔距约 28mm，默认脸壳孔距约 20mm；推荐的短款 L5CX 板体约 15.8×10mm、含耳约 24.7mm。**这些是源作者样品数据，不是对 B014 或本机打印件的实测。** 已购板与本机均需尺寸核对后再决定是否换货。
- 本轮只提出退换或备件建议，没有操作退款、联系卖家或改打印件；两笔 BMI160 和 ToF 仍保留已购状态，后续有退款结果时在原 B 行更新。

## 先确定一条电控路线（历史记录，R1/V167 路线，当前用 20261023c 镜像）

| 路线 | 完整组合 | 本套件可利用部分 | 限制 |
| --- | --- | --- | --- |
| A：配套总线 IMU  | Radxa ZERO 3W + 匹配的 HAT + kissqy STM32G031/LSM6DSV16X IMU + FT6 + R1 镜像升级到 control.43 / V167  | 飞特舵机、匹配打印件、轴承、螺丝；USB 调试板用于台架 | 需取得配套板；EH2.5 与 AMP2.0 不能混插；IMU 板须单独烧录或确认已烧好 |
| B：I²C IMU 适配 | Radxa ZERO 3W + 经过核对的供电/总线接口 + BNO085/086 或 LSM6DSV16X 模块 + fanhao I²C fork / 配套镜像 | USB 调试板可能继续作总线接口，是否可长期上机须核对串口配置、尺寸和供电 | 原版 kissqy 服务只认总线 IMU；不能只换一块传感器就运行原版服务；镜像说明仍有验收未完成项 |

根据用户成品优先、尽快复现的选择，当前推荐 A 的配套成品路线，B 保留参考。两条路线的标定、镜像与服务不交叉安装；首版摄像头与独立云端自然对话见补购清单。

## 采购与到货执行顺序

1. 先处理 B015 主控的库存、实价和镜像批次；最终只确定一个版本，不把拟购写为已付款。
2. 向成品卖家一次询齐 B016–B019 与 B026，逐项列板号、接口、线束和已测固件，优先取得无需自行焊接的整套交付。
3. 核对 B020–B023 的相机/音频与 HAT 包含范围，再补存储和读卡器；首版需要真实画面与自然对话，ToF 可以后装。
4. 到货按 B 行逐项记实数、照片、铭牌和测试结果；螺丝、舵盘、脚垫、线材先扣除已有内容。两款电池和单充优先验收，不重买备选品牌。
5. 准备供电检查与机身承托工具，完成单舵机、装配、标定、架空与首走验收；不将“买齐”登记成“复现通过”。

ST-LINK 只在需要自行烧录 STM32 时增加，成品已刷且验证通过不要求重复购买。额外缓冲电容须先检查已有电源设计，再决定是否需要；轮滑件、独立语音板和其他升级模块不列为首版必买。

## 原始 BOM 的核对结果

来源：[原始 Excel](../../01_mechanical/microduck-replica-cad/BOM/装配BOM-机械行者Robo-2026-10-20-带采购链接.xlsx)，读取时保留公式，没有编辑文件。

| 位置 | 读到的内容 | 影响 |
| --- | --- | --- |
| `A60` | 33 类打印件 / 23 类外购件 | 仓库 README 的 21 类说明滞后；类别数不等于实物总件数 |
| `I60` | `=SUM(I3:I58)` | 没有包含防滑垫所在第 59 行 |
| `G43/H43/I43` | 电池数量 1、单价 17、金额为空 | 合计不会计入电池金额 |
| `C44` | AMP2.0 双头转接线 | 仓库 README 表格相应位置仍列电池座；需另核对是否实际包含电池座 |
| `E7/F7`、`E8/F8` | 材料栏 PLA，备注建议 TPU | 软下巴和软嘴按柔性需求核对，不能统一按 PLA |
| 舵机名称 | 表内写 HD1901M，截图与机械版写 HD-1910-C001 | 名称存在混写，按实物完整型号确认 |
| 价格列 | 来源作者历史采购价，部分为 `/` 或 0 | 不能视为当前报价；0 不表示免费，也不代表本项目总预算 |

采购链接保留在原始 Excel 和 kissqy 采购表内。补购前按“本机所用版本 + 已有数量 + 尚缺数量”重新核对，不把多个作者的备料数量累加成装机数量。

## kissqy 采购表与本机 BOM 对照（2026-10-26）

来源：kissqy 仓库 `DUCK-SHOPPING-LIST.md`，其“不买打印机”合计约 ¥2747.70，含 HAT 与 IMU 成品之外的本体与线材备料。

| 项目 | kissqy | 本机 | 差异与处理 |
|---|---|---|---|
| 舵机 | 15 个，¥119/个，¥1785 | 套装 ¥1854，含打印件、轴承、调试板 | 不可直接比 |
| 主控 | ZERO 3W 2GB 无 eMMC ¥309 | 未买 | 同 |
| 电池 | 沣标 NP-F550 2200 mAh，2 电加双充，¥84.59 | 3 块电池加 1 个充电器 | 本机更多 |
| 摄像头 | IMX219 160°，¥64.35，树莓派零售商 | DECXIN IMX219 222°，¥53.80 | 同类，均非 Radxa 原厂 |
| ToF | VL53L5CX 紧凑模块 ¥49.50 | VL53L8CX 长板 ¥77.69 | 型号不同，长板有装不进脸壳的风险，首走后再核 |
| 扬声器 | 3525 腔体 4Ω 3W，¥3.08，自带 1.25 端子 | 8Ω 2W 杜邦公头 | 新增 kissqy 同款，原件留作备用 |
| 手柄 | 盖世小鸡启明星 2，蓝牙 Xbox 模式，¥89.91 | TGZ，未验证 | 到货后试，不先买 |
| 轴承 | 10×15×3 ×5，16×22×4 ×12，滑轮 623 ×8 | 10×15×3 ×6，16×22×4 ×17，另有套装内 14 个 | 本机足够 |
| 螺丝 | M2×4/5/6/8/12、M2.6×8 平尾自攻，各 200 | M2×5/6/8、M2.5×6/8 各 500 | kissqy 的打印件是另一版，规格不同，本机按作者 BOM |
| 舵机线 | AMP2.0 3P 10 cm ×30、20 cm ×30，¥0.90/条 | 100 mm 反向线 ×4 | 本机追加 10 cm ×20、20 cm ×10 同向线 |
| 电源线 | 22AWG 硅胶线 | 18AWG 硅胶线 | fanhao 建议 16–18AWG，保留 |
| 电容 | 总入口 1000 µF 16 V | 已加入 BOM | 先问套件含不含 |

线序提醒：HAT 与 IMU 的 AMP2.0 口为 1=GND、2=BATT 或 VDD、3=DATA，而飞特舵机连接器资料写的是 1=信号、2=VCC、3=GND，板与舵机之间需要“反向”线，舵机与舵机之间需要“同向直通”线，用错会接反电源。上电前必须用万用表逐根核对。
