xlx2730109-code/Microduck/01_mechanical/original_downloads/0位支架.stp

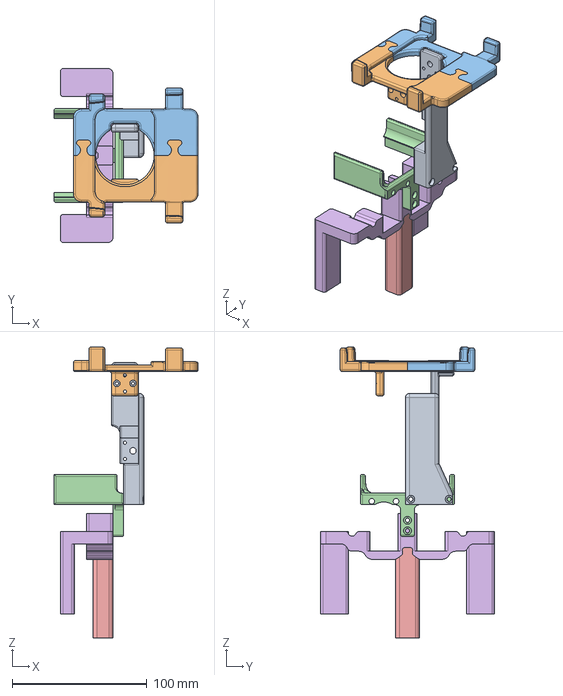
[picture p41: CAD file, 2026-10-25]
01_mechanical/original_downloads/0位支架.stp
106.7 x 129.0 x 215.8 mm
