xlx2730109-code/Microduck/01_mechanical/roller_skates_kissqy_20261107/右脚.stl

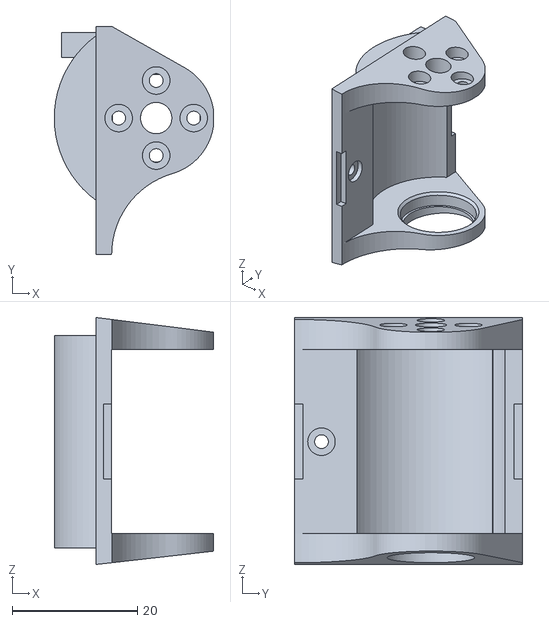
[picture p42: CAD file, 2026-11-10]
01_mechanical/roller_skates_kissqy_20261107/右脚.stl
25.5 x 36.5 x 39.5
