xlx2730109-code/Microduck/01_mechanical/roller_skates_kissqy_20261107/滑轮支架右.stl

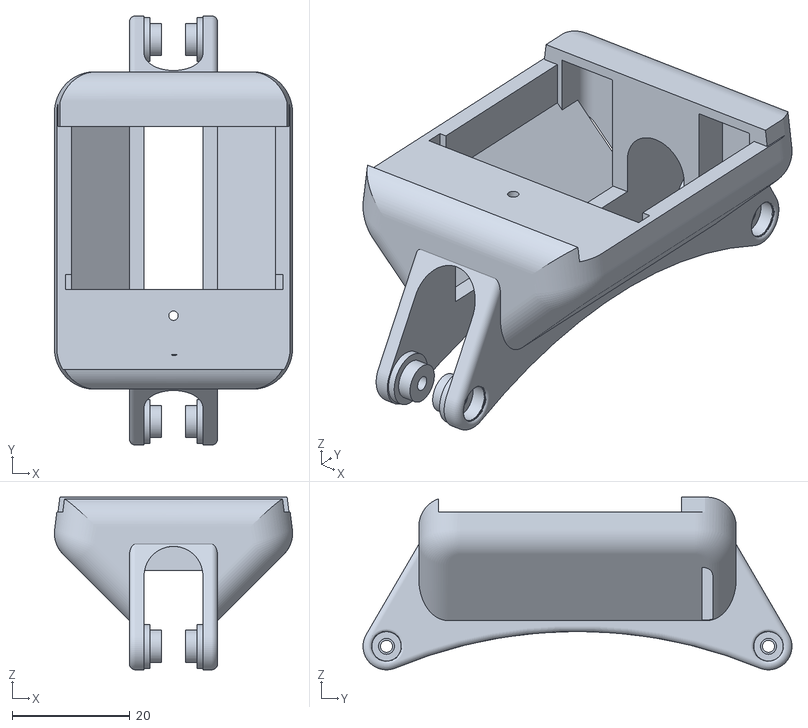
[picture p43: CAD file, 2026-11-10]
01_mechanical/roller_skates_kissqy_20261107/滑轮支架右.stl
40.5 x 73.0 x 29.4
