xlx2730109-code/Microduck/01_mechanical/roller_skates_kissqy_20261107/滑轮.stl

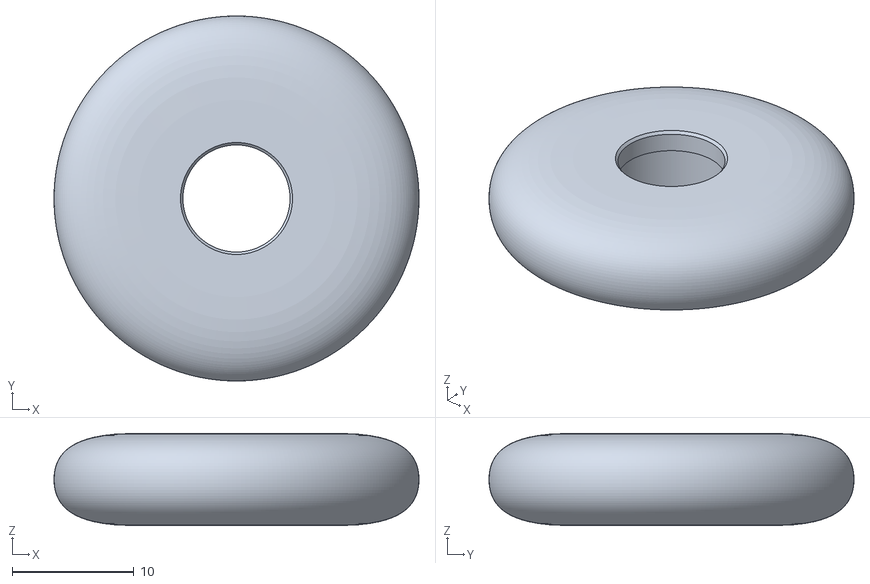
[picture p44: CAD file, 2026-11-10]
01_mechanical/roller_skates_kissqy_20261107/滑轮.stl
30.0 x 30.0 x 7.60
