xlx2730109-code/Microduck/01_mechanical/roller_skates_kissqy_20261107/source_layout.3mf

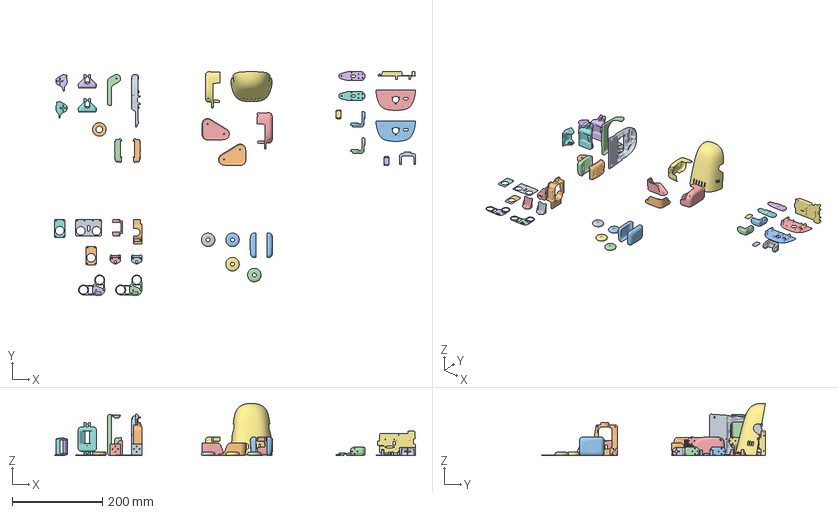
[picture p45: CAD file, 2026-11-10]
01_mechanical/roller_skates_kissqy_20261107/source_layout.3mf
798.8 x 495.0 x 115.6 mm
头部集成板.stl
头部集成盖.stl
右脚底.stl x 2
嘴巴.stl
头部侧倾.stl
滑轮支架右_补缝_内推4mm.stl x 2
电池仓_HUB优化_卡扣优化_IMU定位.stl
右胯旋转.stl
右脚掌.stl
左脚掌.stl
左胯旋转.stl
左脚.stl
头盖.stl
右脚.stl
躯干台.stl
眼睛.stl
滑轮1.stl
右腿固定片.stl
鸭脸_瑞莎IMX219.stl
左腿固定片.stl
滑轮2.stl
右胯固定片.stl
滑轮3.stl
左胯固定片.stl
鸭脸_仓库IMX219.stl
滑轮4.stl
躯干左壳.stl
右腿_斜面优化.stl
躯干右壳.stl
左腿_斜面优化.stl
头部旋转.stl
左胯外壳.stl
左胯侧摆.stl
右胯侧摆.stl
右胯外壳.stl
颈部支撑.stl
颈部支撑2.stl
