xlx2730109-code/Microduck/(list of files, cad)

Other CAD files:
01_mechanical/roller_skates_kissqy_20261107/左脚.stl
01_mechanical/original_downloads/0位支架.3MF
