xlx2730109-code/Microduck/00_notes/evidence/20261110/printing_plan.png

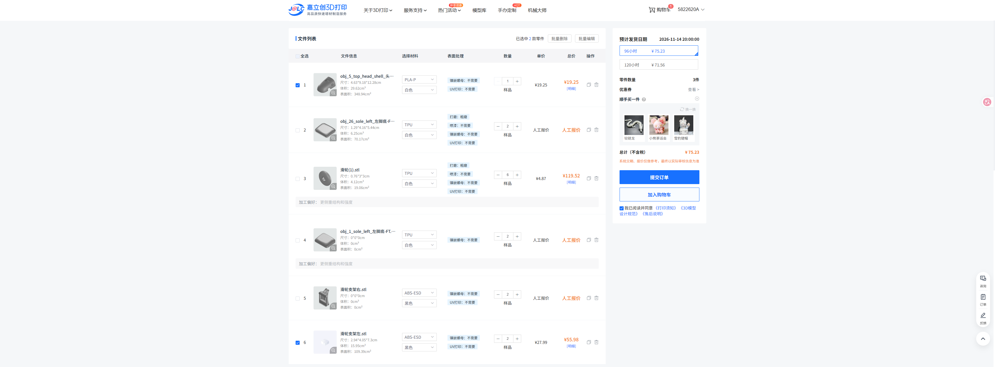
00_notes/evidence/20261110/printing_plan.png
