xlx2730109-code/Microduck/01_mechanical/microduck-replica-cad/组件图/00-microduck装配体爆炸图2.png

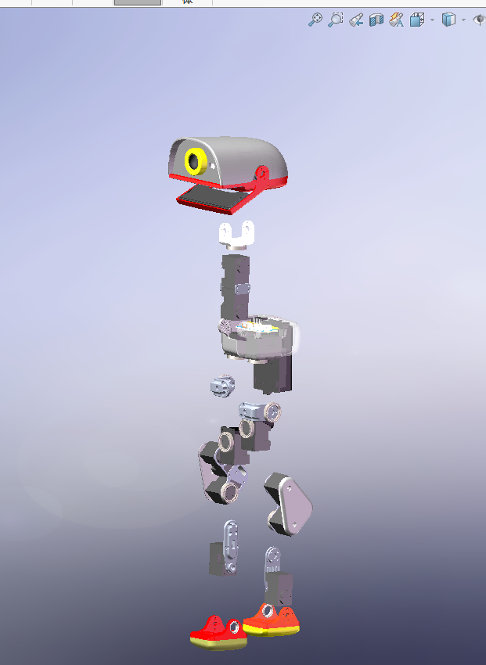
01_mechanical/microduck-replica-cad/组件图/00-microduck装配体爆炸图2.png
