xlx2730109-code/Microduck/(commit log)

2026-10-25 Add Microduck reproduction notes, BOM, mechanical references and audit reports
    [0位支架.3MF, 0位支架.stp, microduck-飞特版-BambuStudio2026-10-20.3mf, zero_position_jig.stp, 装配BOM-机械行者Robo-2026-10-20-带采购链接.xlsx, 装配BOM-机械行者Robo-2026-10-23-带采购链接.xlsx]
2026-11-10 整理项目资料并修复本地网页运行文件的 Git 忽略规则
    [0位支架.3MF, 0位支架.stp, battery-20261012-1458.csv, battery-20261012-1532.csv, battery-20261013-1540.csv, source_layout.3mf, 右脚.stl, 左脚.stl]
