xlx2730109-code/Microduck/00_notes/evidence/20261110/assembly_progress.jpg

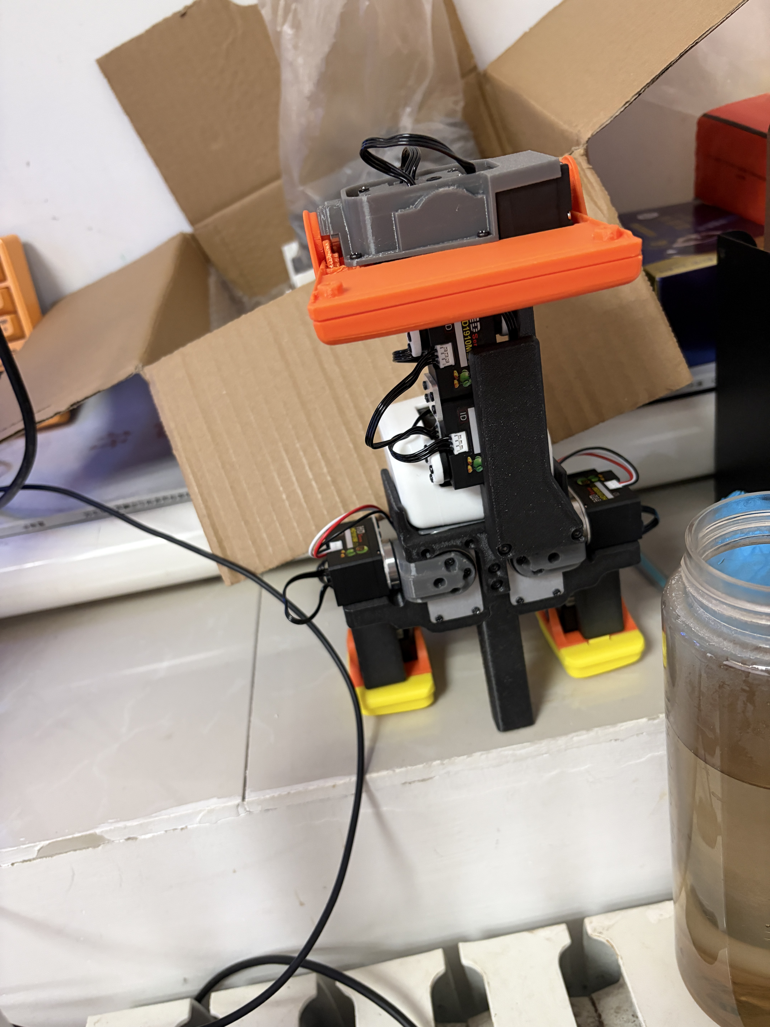
00_notes/evidence/20261110/assembly_progress.jpg
